Ali-Helmi/modular_robotics/Object Dection and Gripper Arm/Object Detection/Source code/test/images/WIN_20230304_14_51_10_Pro_jpg.rf.c719f185c8aedad8c6cd8eb817fdbf0e.jpg

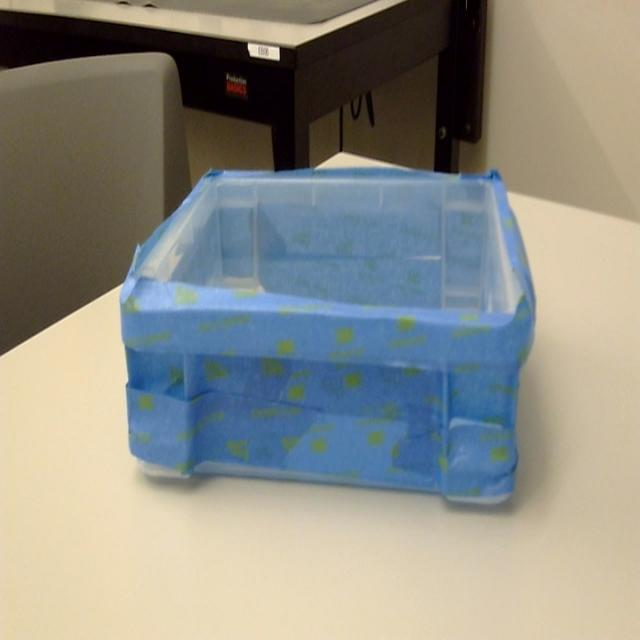
Object Dection and Gripper Arm/Object Detection/Source code/test/images/WIN_20230304_14_51_10_Pro_jpg.rf.c719f185c8aedad8c6cd8eb817fdbf0e.jpg
