Ali-Helmi/modular_robotics/Object Dection and Gripper Arm/Object Detection/Source code/test/images/WIN_20230304_14_51_47_Pro_jpg.rf.07478893552f3b3fd59447c2d8dccacb.jpg

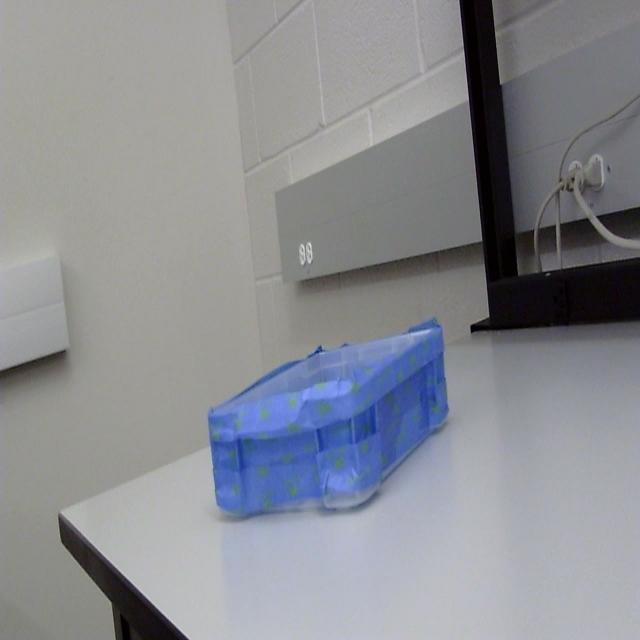
Object Dection and Gripper Arm/Object Detection/Source code/test/images/WIN_20230304_14_51_47_Pro_jpg.rf.07478893552f3b3fd59447c2d8dccacb.jpg
