Ali-Helmi/modular_robotics/README.md

# Modular Robotics (Molucubes)
A repository which holds all the files for the subsystems that make up our senior design project.
