Ali-Helmi/modular_robotics/Housing and PCBs/PCBs/info.txt

final_PCBs_404 is the location for the final designs for the arm, sensor, and connector PCBs
used for the robot in ECEN 404

The others are the old designs
