Ali-Helmi/modular_robotics/Object Dection and Gripper Arm/Gripper Arm/2-15-2023/newArm/screenshots/hollistic_sketch_layout.png

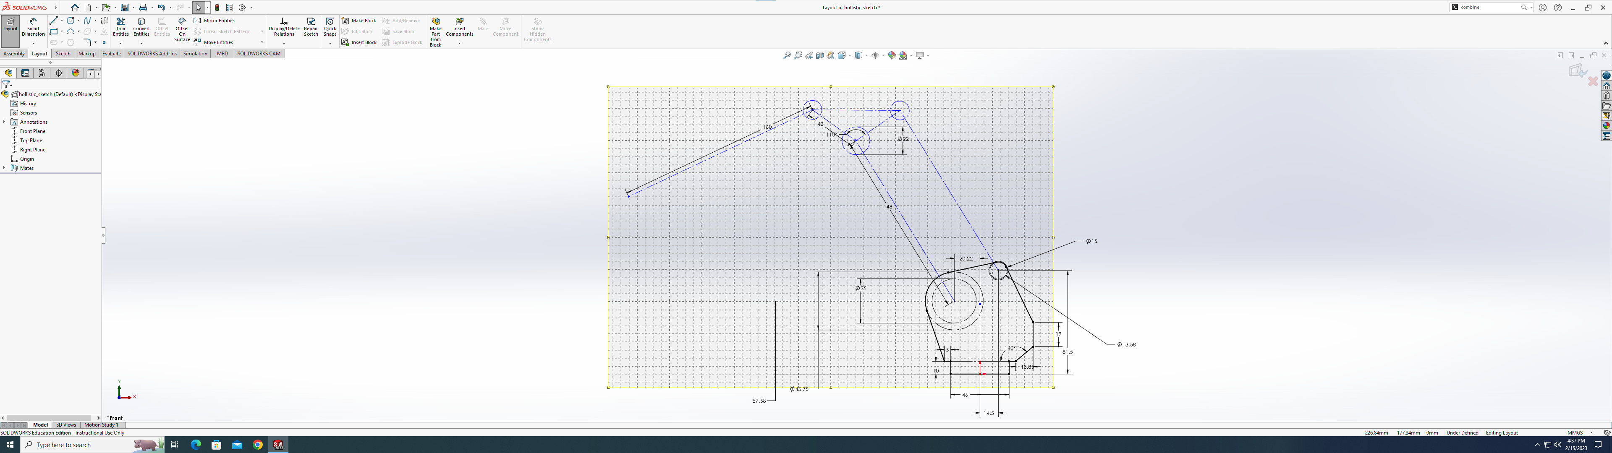
Object Dection and Gripper Arm/Gripper Arm/2-15-2023/newArm/screenshots/hollistic_sketch_layout.png
