Ali-Helmi/modular_robotics/Object Dection and Gripper Arm/Gripper Arm/2-15-2023/newArm/screenshots/modular_base_3d.png

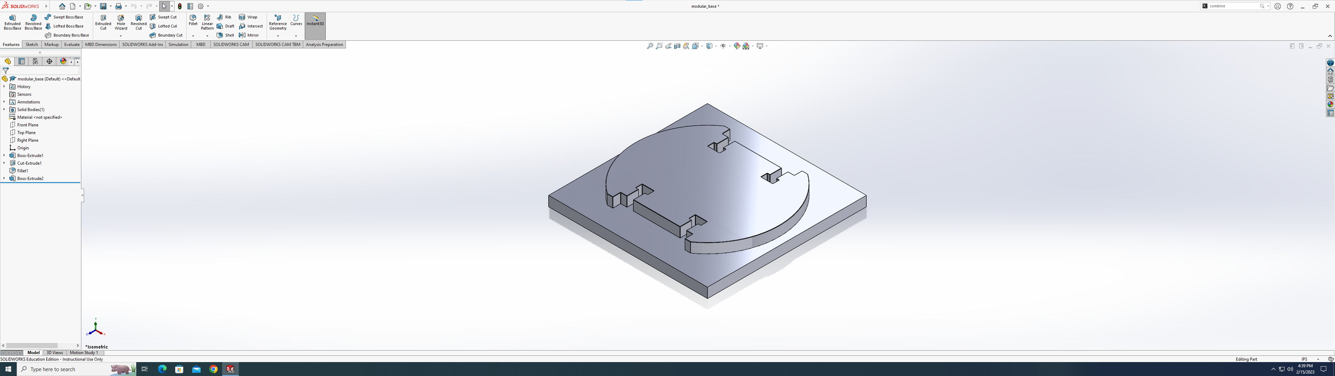
Object Dection and Gripper Arm/Gripper Arm/2-15-2023/newArm/screenshots/modular_base_3d.png
