Ali-Helmi/modular_robotics/Object Dection and Gripper Arm/Gripper Arm/3-20-2023/PXL_20230322_123354596.jpg

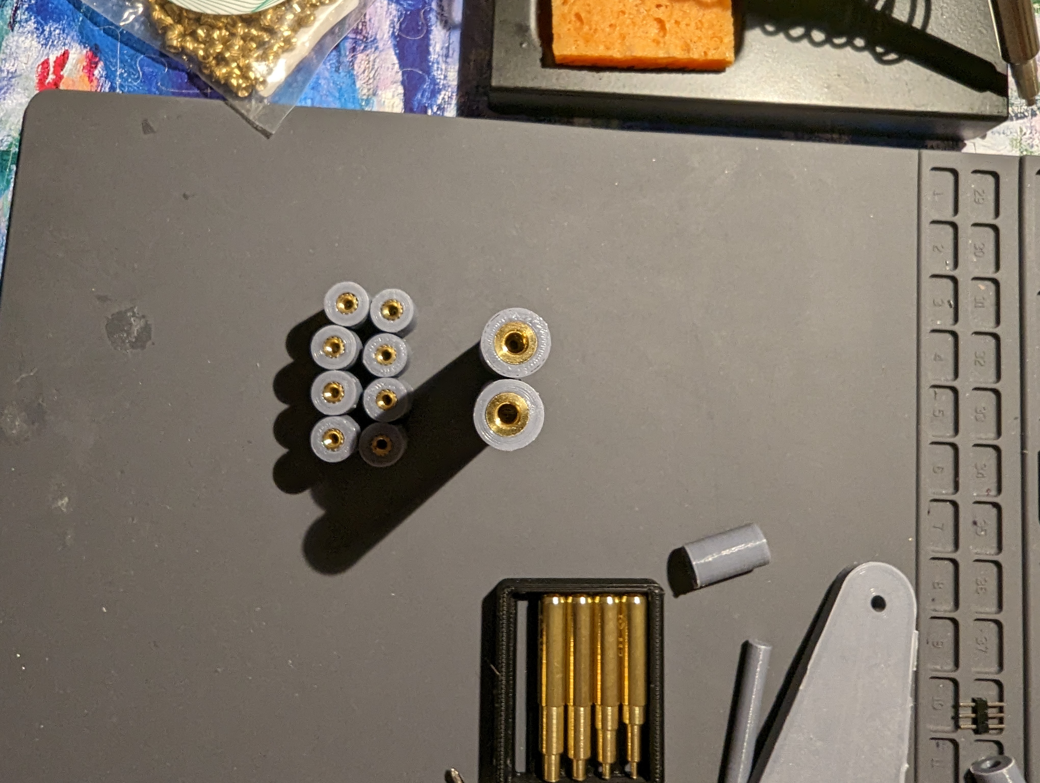
Object Dection and Gripper Arm/Gripper Arm/3-20-2023/PXL_20230322_123354596.jpg
