Ali-Helmi/modular_robotics/Object Dection and Gripper Arm/Gripper Arm/Demonstrations/gripper_arm_extended.jpg

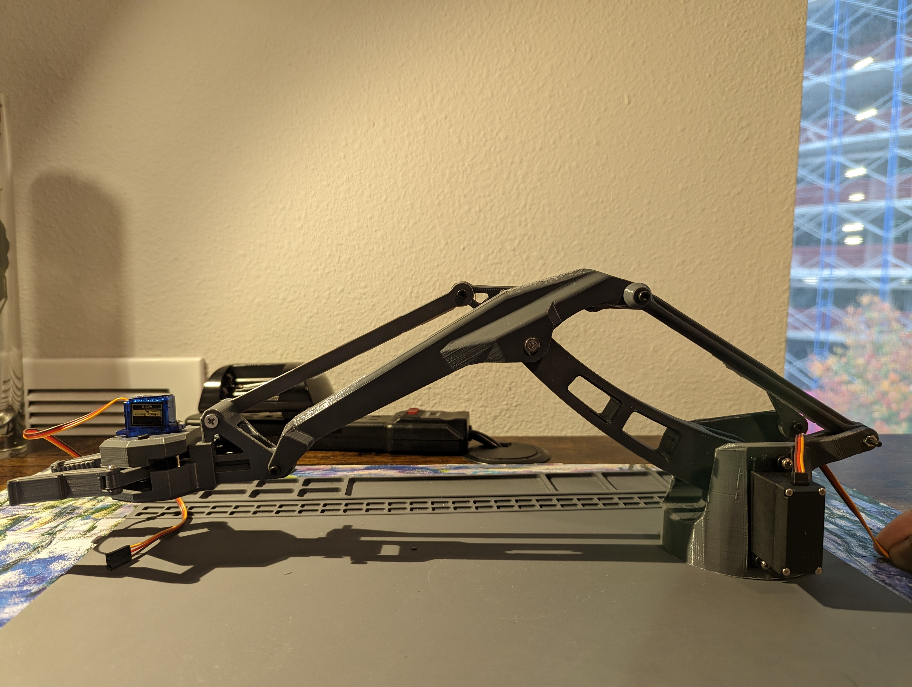
Object Dection and Gripper Arm/Gripper Arm/Demonstrations/gripper_arm_extended.jpg
