Ali-Helmi/modular_robotics/Object Dection and Gripper Arm/Gripper Arm/Demonstrations/gripper_arm_normal.jpg

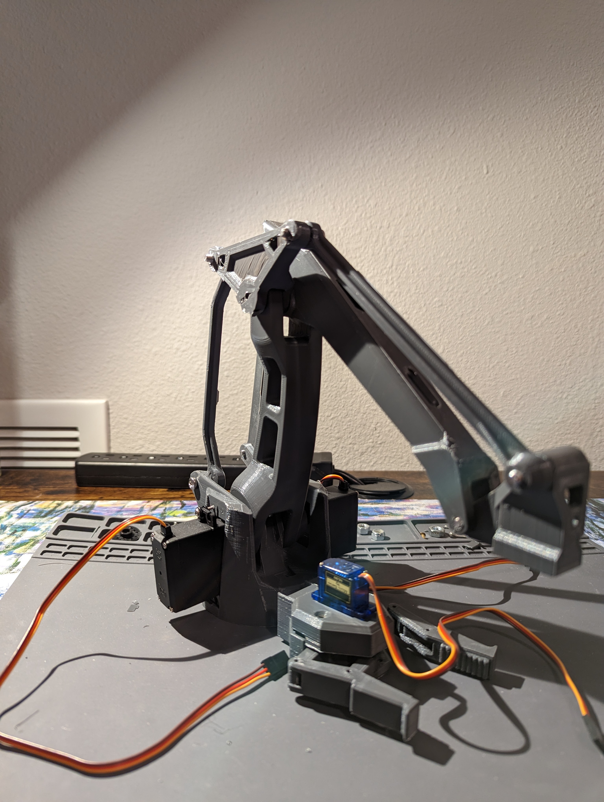
Object Dection and Gripper Arm/Gripper Arm/Demonstrations/gripper_arm_normal.jpg
