Ali-Helmi/modular_robotics/Object Dection and Gripper Arm/Gripper Arm/Demonstrations/PXL_20230322_113851654.jpg

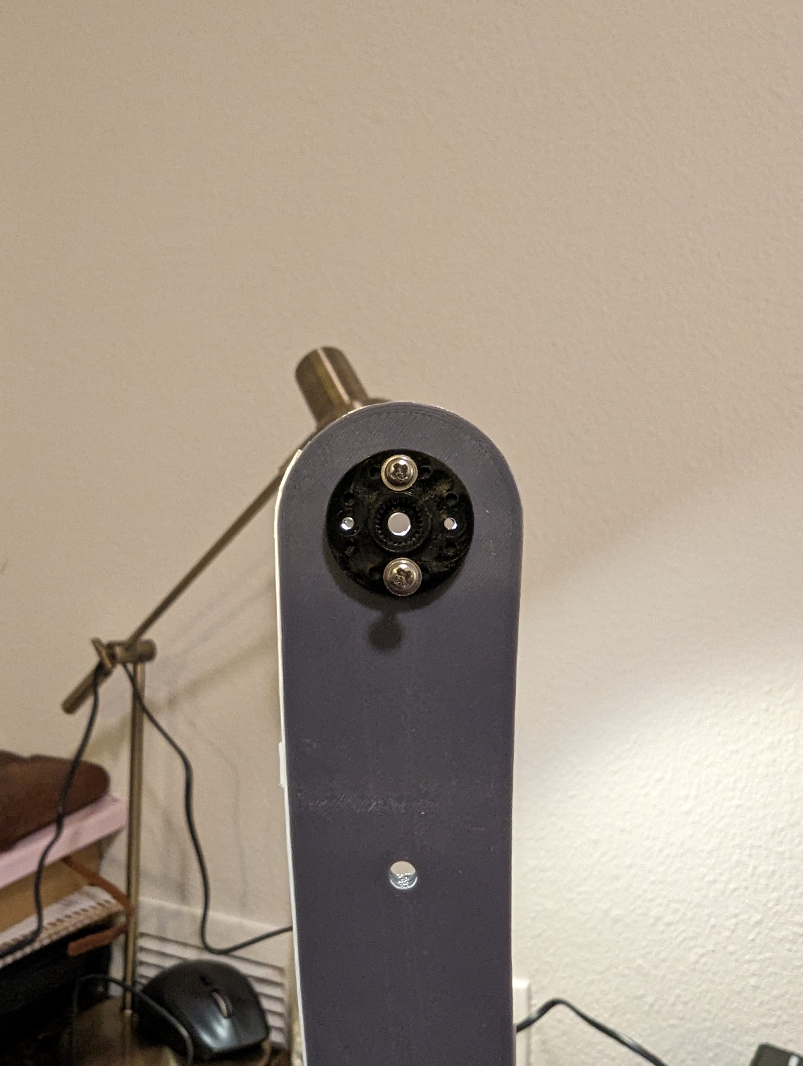
Object Dection and Gripper Arm/Gripper Arm/Demonstrations/PXL_20230322_113851654.jpg
