Ali-Helmi/modular_robotics/Object Dection and Gripper Arm/Gripper Arm/Demonstrations/PXL_20230405_151951665.jpg

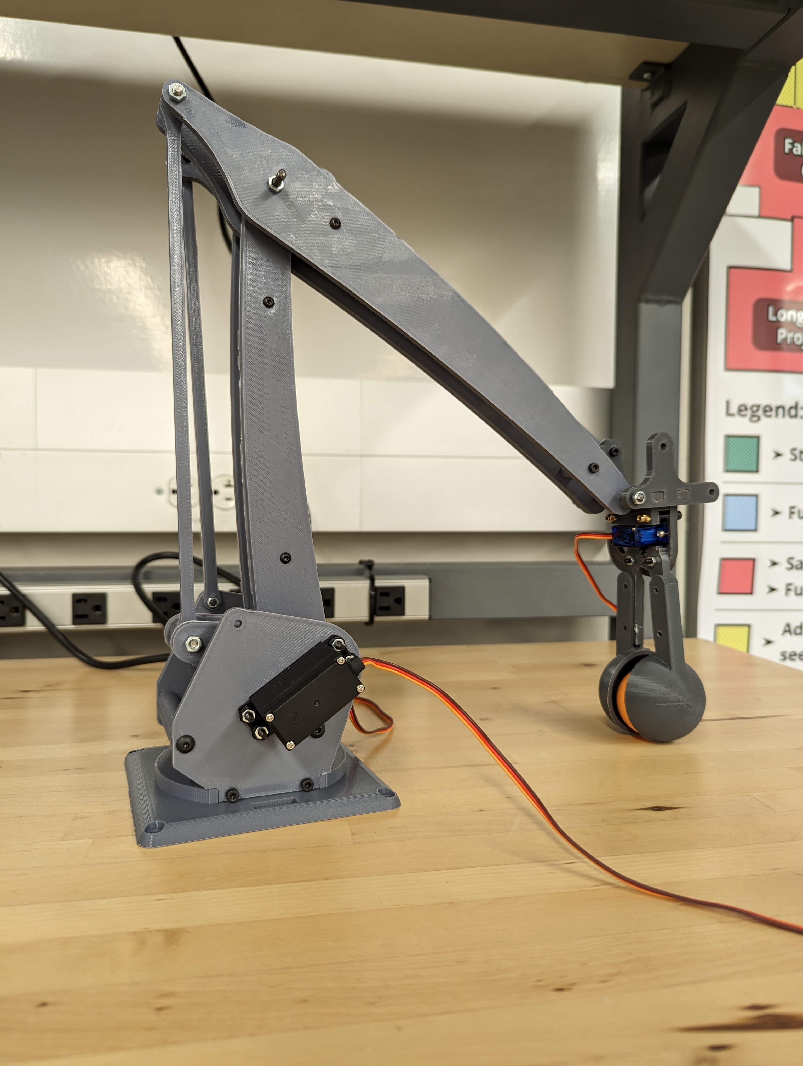
Object Dection and Gripper Arm/Gripper Arm/Demonstrations/PXL_20230405_151951665.jpg
