Ali-Helmi/modular_robotics/Object Dection and Gripper Arm/Gripper Arm/Demonstrations/PXL_20230406_000420174.jpg

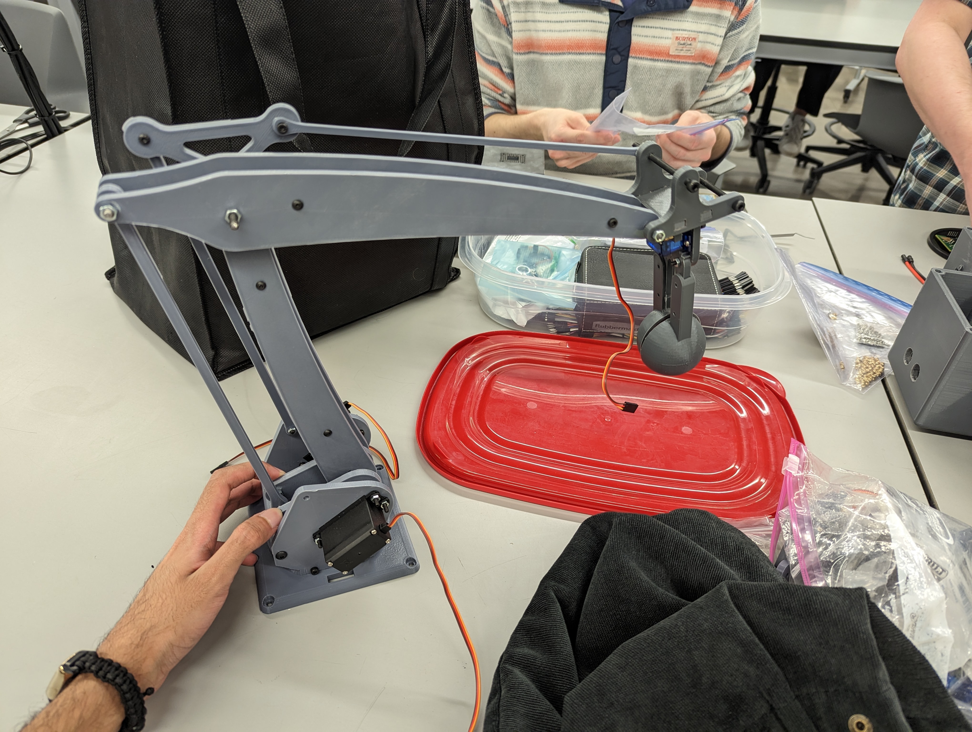
Object Dection and Gripper Arm/Gripper Arm/Demonstrations/PXL_20230406_000420174.jpg
