Ali-Helmi/modular_robotics/Object Dection and Gripper Arm/Gripper Arm/Demonstrations/PXL_20230406_001806251.jpg

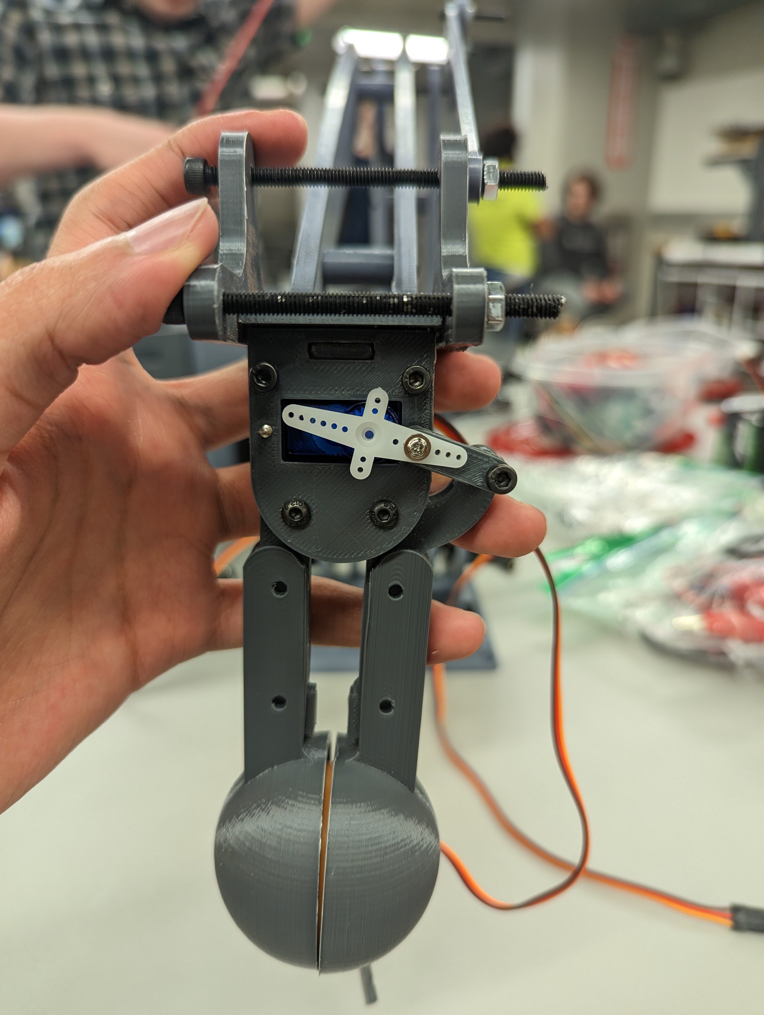
Object Dection and Gripper Arm/Gripper Arm/Demonstrations/PXL_20230406_001806251.jpg
