Ali-Helmi/modular_robotics/Object Dection and Gripper Arm/Gripper Arm/Designs/design1.png

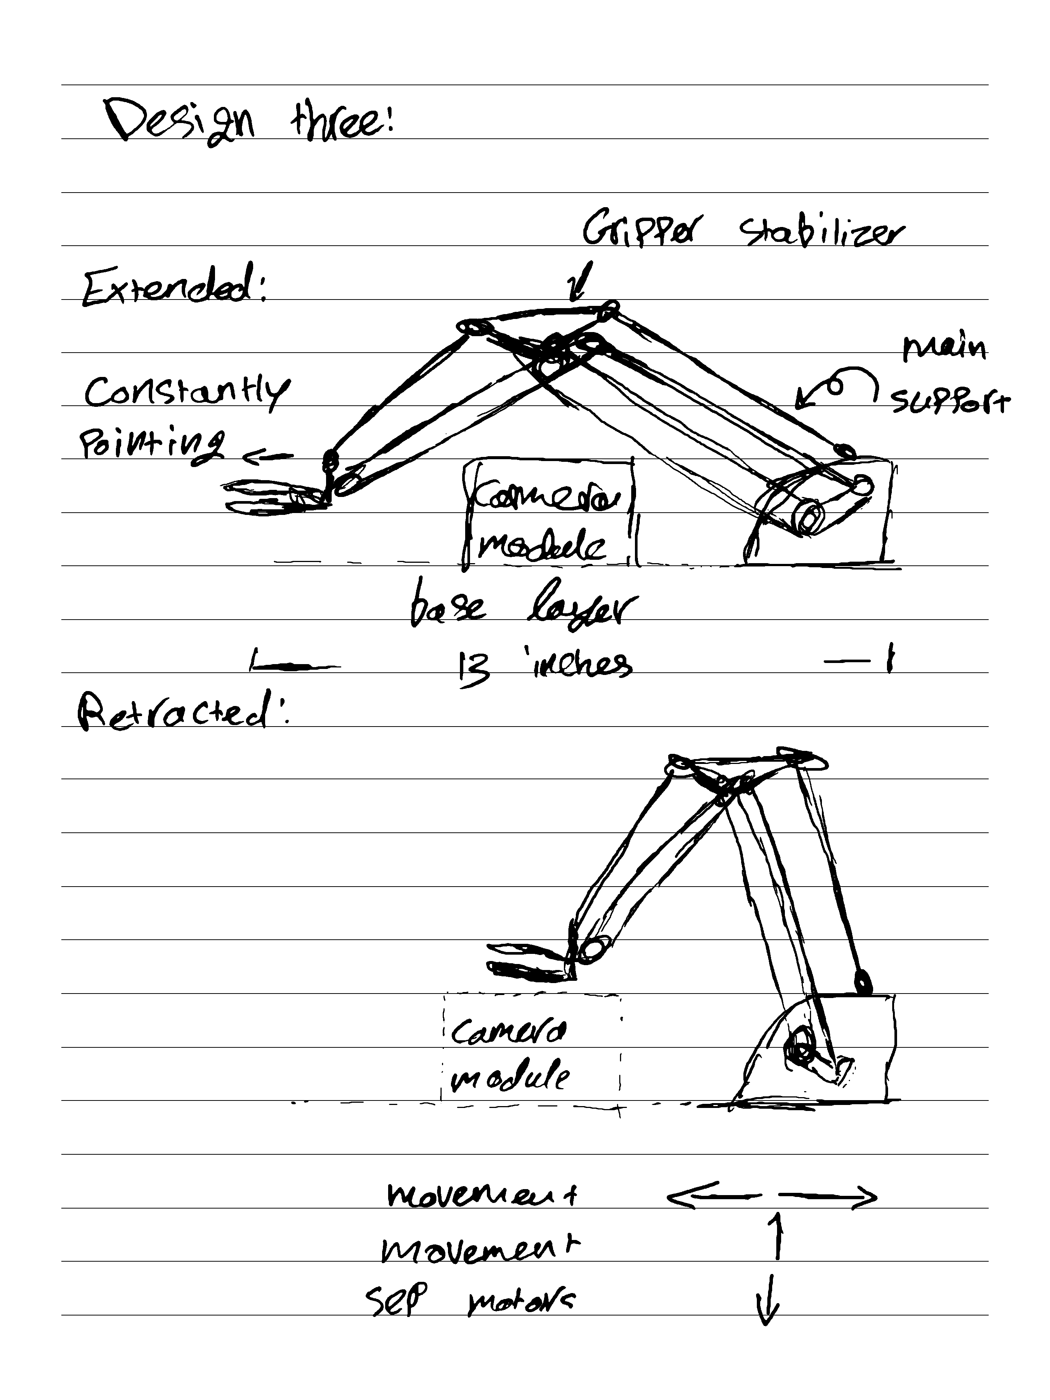
Object Dection and Gripper Arm/Gripper Arm/Designs/design1.png
