Ali-Helmi/modular_robotics/Object Dection and Gripper Arm/Gripper Arm/Designs/design2.png

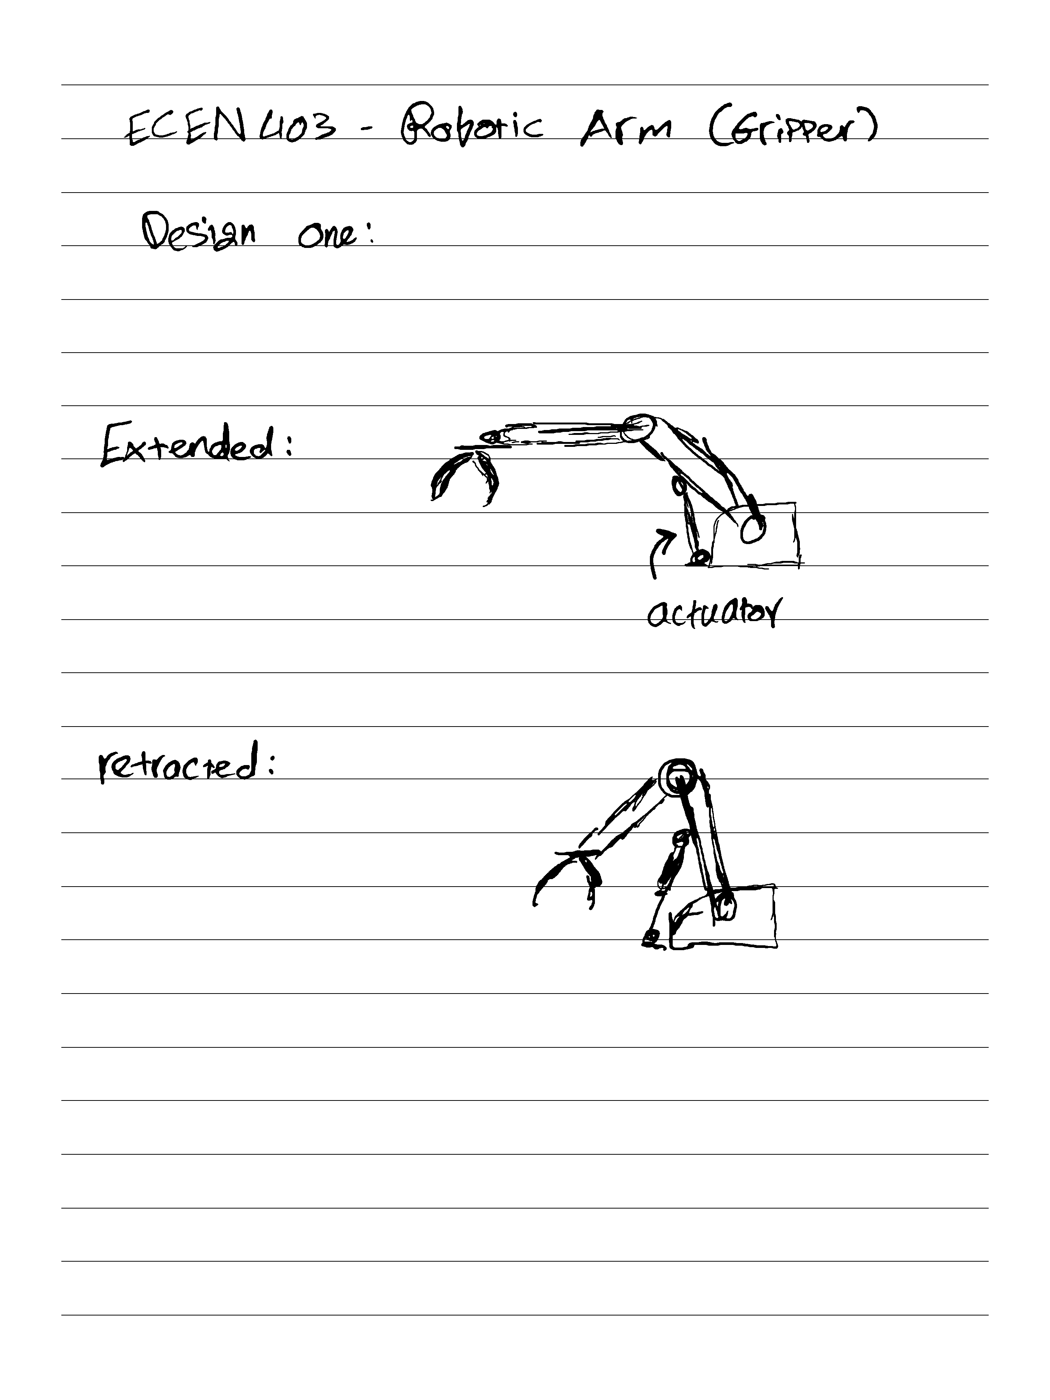
Object Dection and Gripper Arm/Gripper Arm/Designs/design2.png
