Ali-Helmi/modular_robotics/Object Dection and Gripper Arm/Gripper Arm/Designs/design3.png

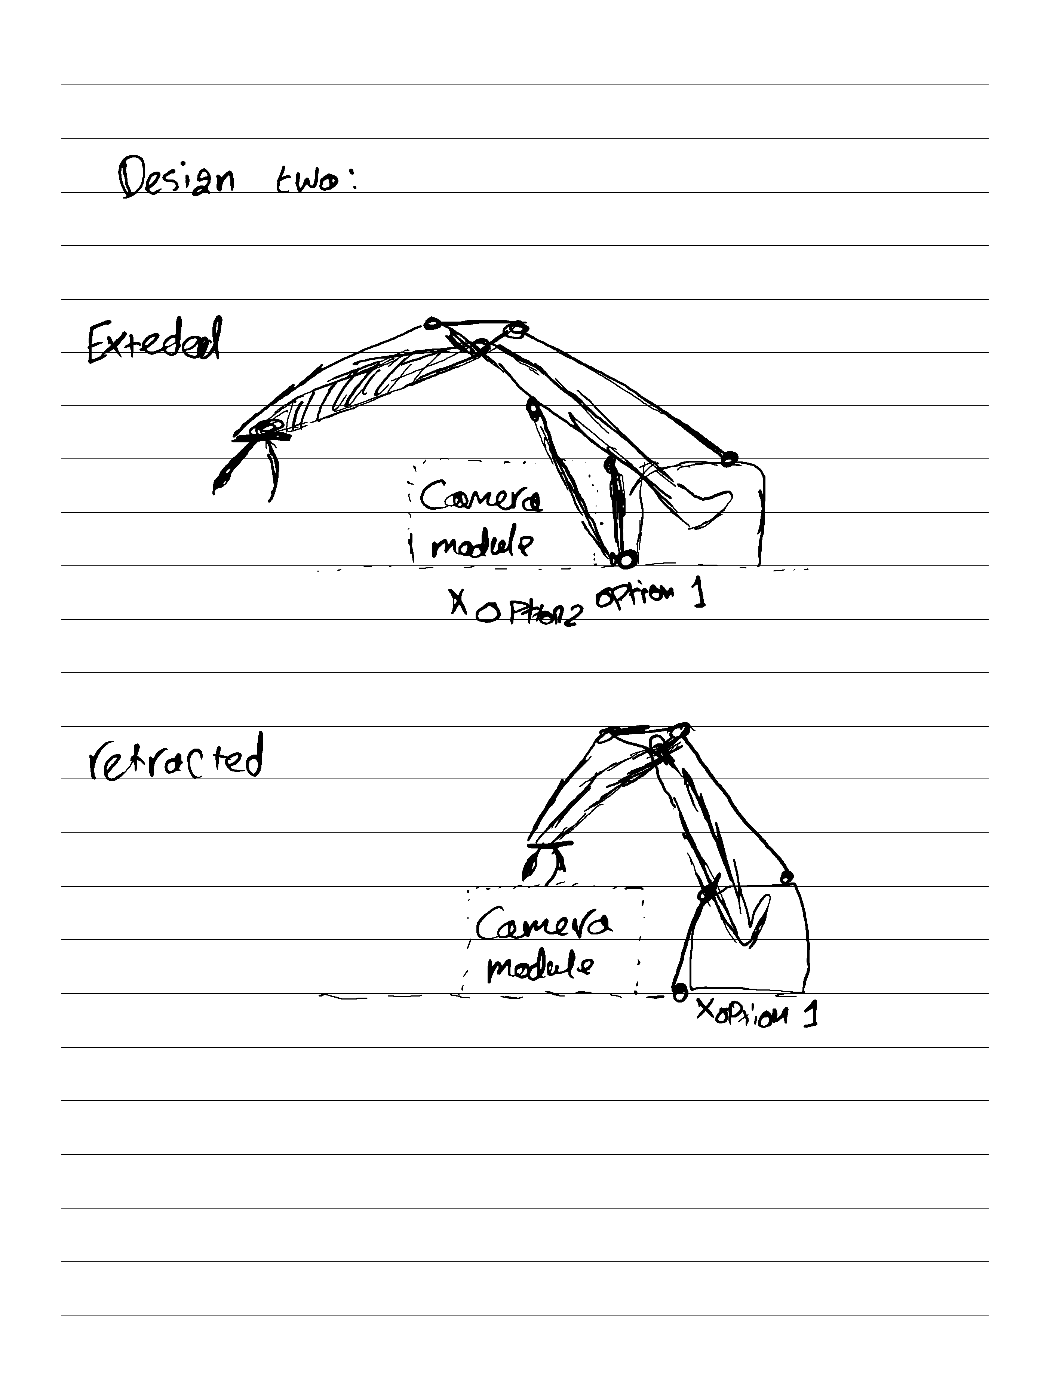
Object Dection and Gripper Arm/Gripper Arm/Designs/design3.png
