Ali-Helmi/modular_robotics/Object Dection and Gripper Arm/Object Detection/Demonstration/confusion_matrix.png

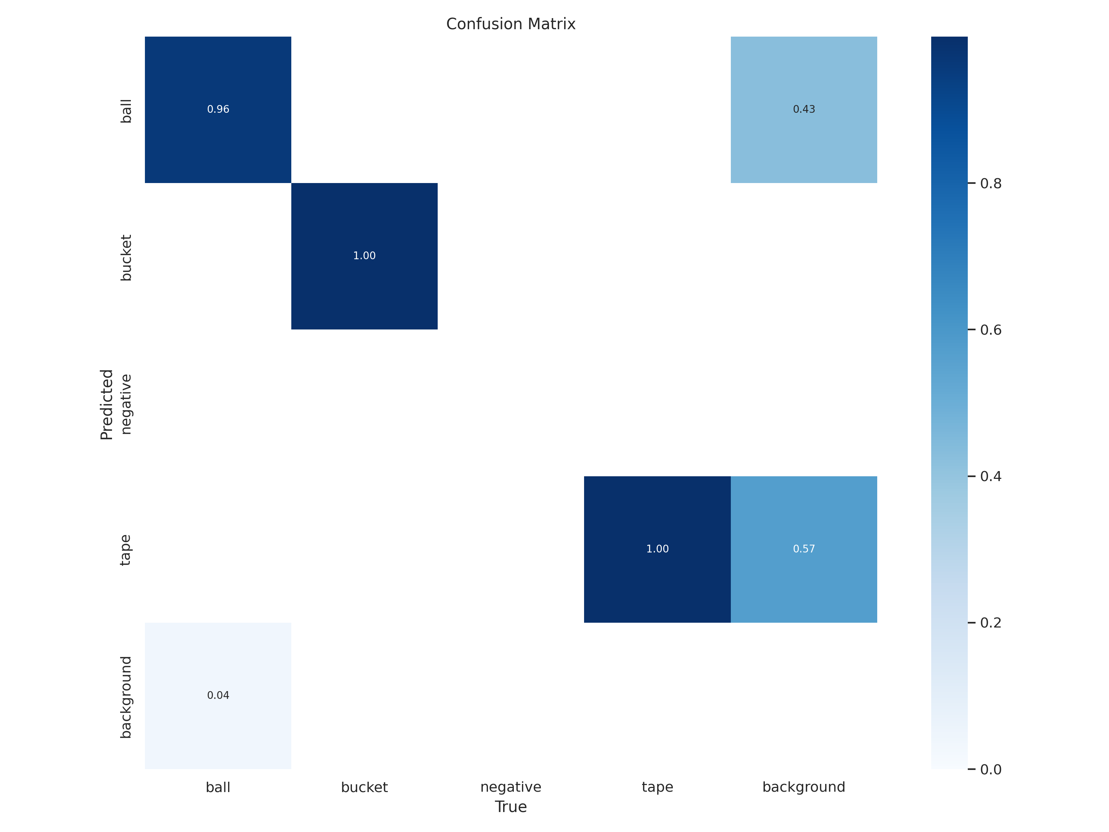
Object Dection and Gripper Arm/Object Detection/Demonstration/confusion_matrix.png
