Ali-Helmi/modular_robotics/Object Dection and Gripper Arm/Object Detection/Demonstration/example.jpeg

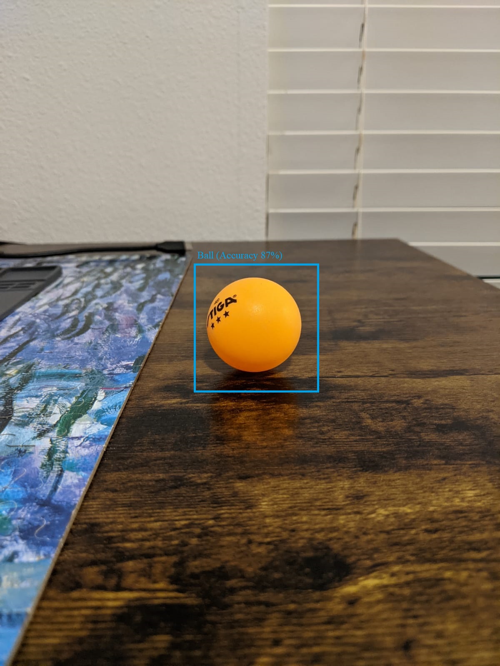
Object Dection and Gripper Arm/Object Detection/Demonstration/example.jpeg
