Ali-Helmi/modular_robotics/Object Dection and Gripper Arm/Object Detection/Demonstration/F1_curve.png

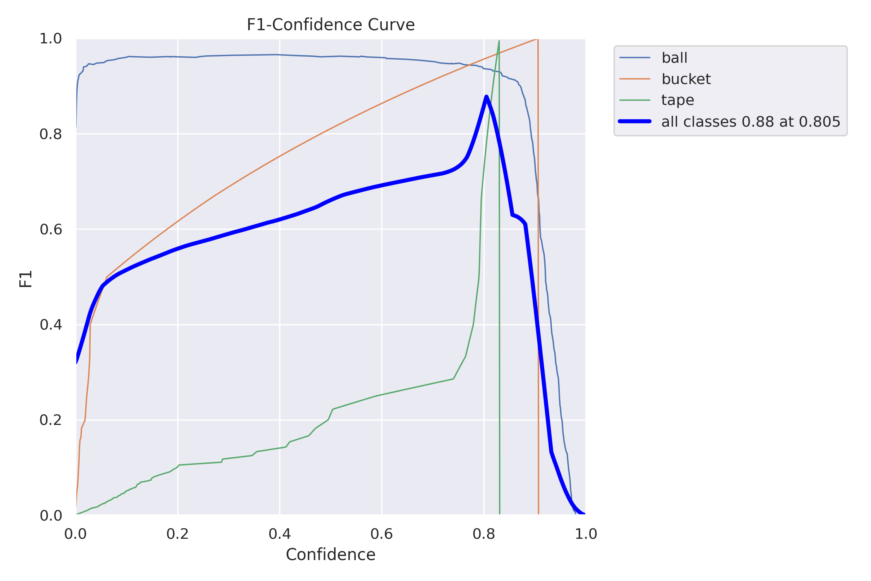
Object Dection and Gripper Arm/Object Detection/Demonstration/F1_curve.png
