Ali-Helmi/modular_robotics/Object Dection and Gripper Arm/Object Detection/Demonstration/PR_curve.png

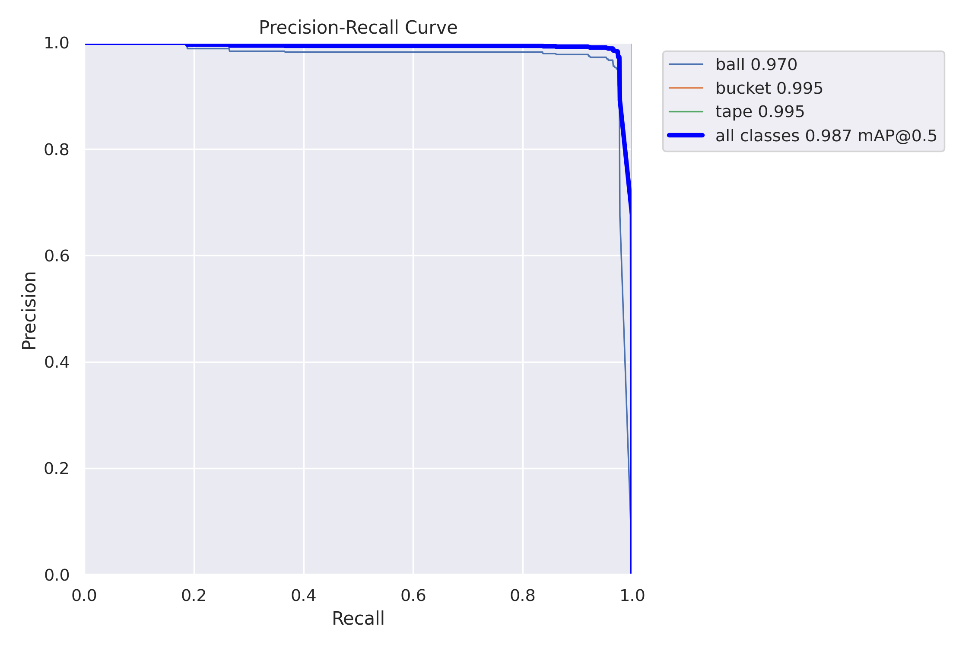
Object Dection and Gripper Arm/Object Detection/Demonstration/PR_curve.png
