Ali-Helmi/modular_robotics/Object Dection and Gripper Arm/Object Detection/Demonstration/Screenshot 2023-02-15 011303.png

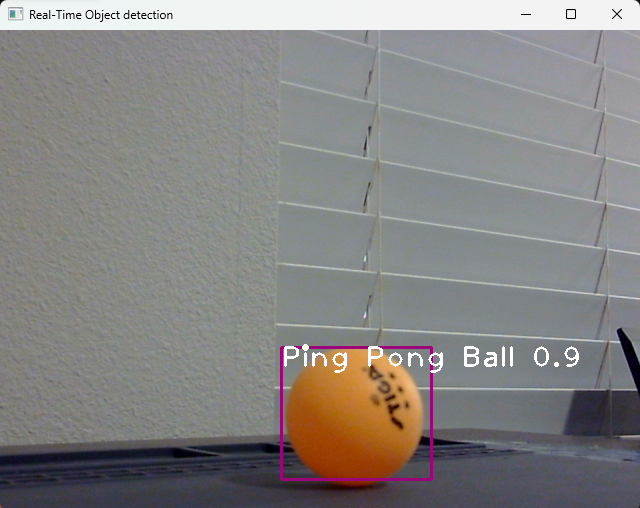
Object Dection and Gripper Arm/Object Detection/Demonstration/Screenshot 2023-02-15 011303.png
