Ali-Helmi/modular_robotics/Object Dection and Gripper Arm/Object Detection/Demonstration/Screenshot 2023-03-20 095929.png

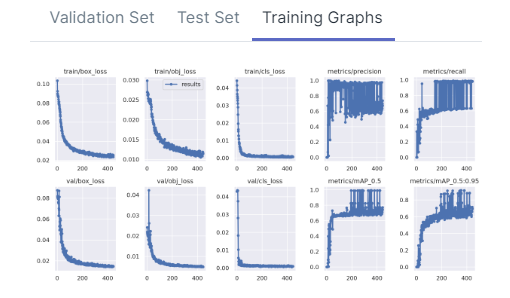
Object Dection and Gripper Arm/Object Detection/Demonstration/Screenshot 2023-03-20 095929.png
