Ali-Helmi/modular_robotics/Object Dection and Gripper Arm/Object Detection/Demonstration/train_batch1.jpg

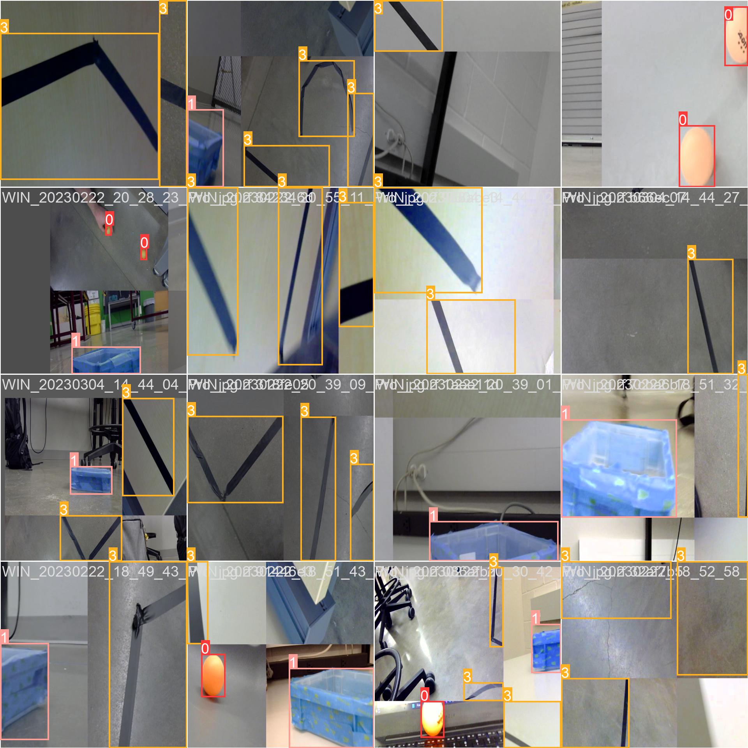
Object Dection and Gripper Arm/Object Detection/Demonstration/train_batch1.jpg
