Ali-Helmi/modular_robotics/Object Dection and Gripper Arm/Object Detection/Demonstration/val_batch0_labels.jpg

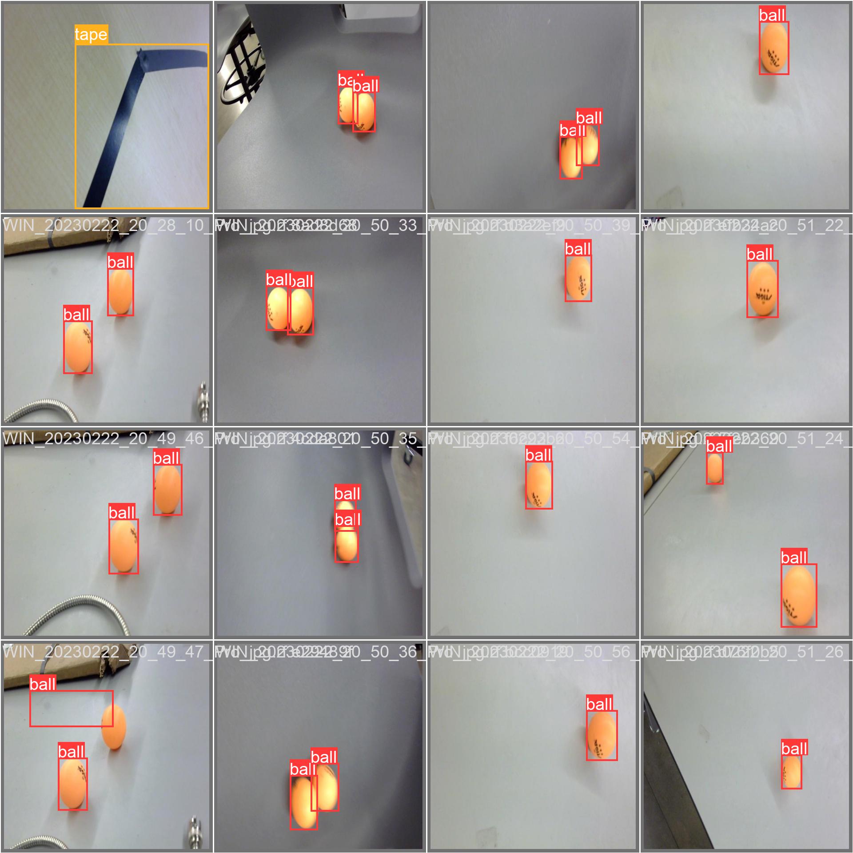
Object Dection and Gripper Arm/Object Detection/Demonstration/val_batch0_labels.jpg
