Ali-Helmi/modular_robotics/Object Dection and Gripper Arm/Object Detection/Demonstration/val_batch1_labels.jpg

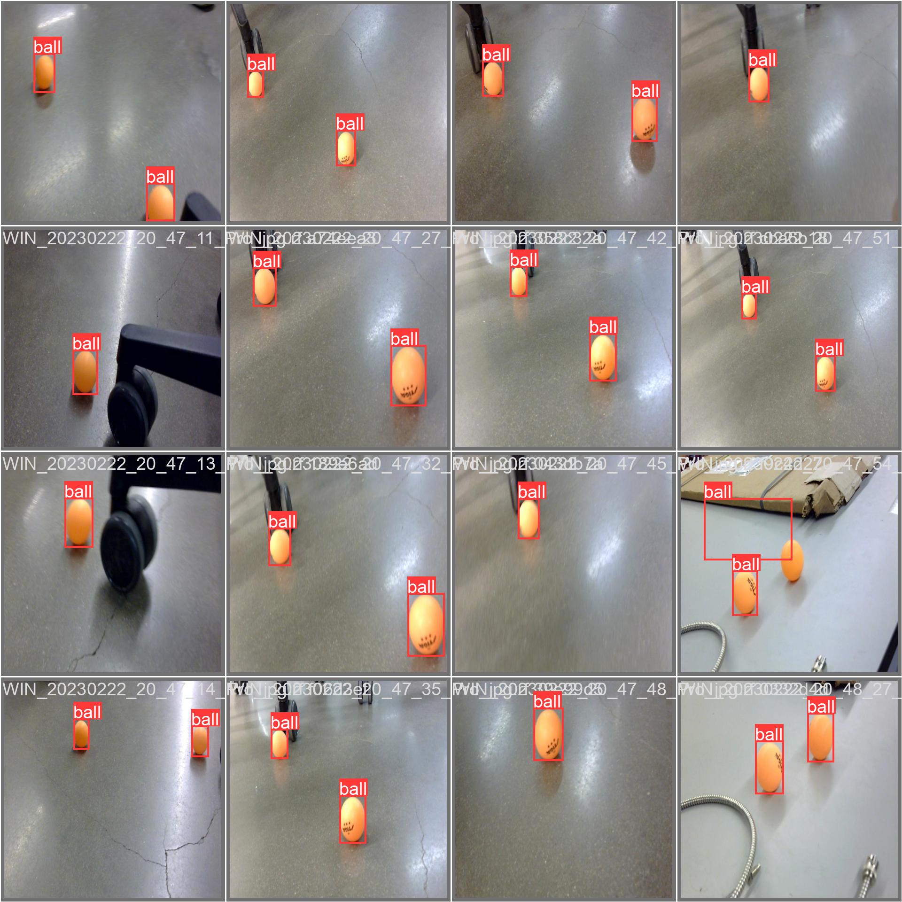
Object Dection and Gripper Arm/Object Detection/Demonstration/val_batch1_labels.jpg
