Ali-Helmi/modular_robotics/Object Dection and Gripper Arm/Object Detection/Source code/runs/detect/predict/WIN_20230222_20_41_58_Pro_jpg.rf.e61d919e48a1193bfad353eb70a3a4d8.jpg

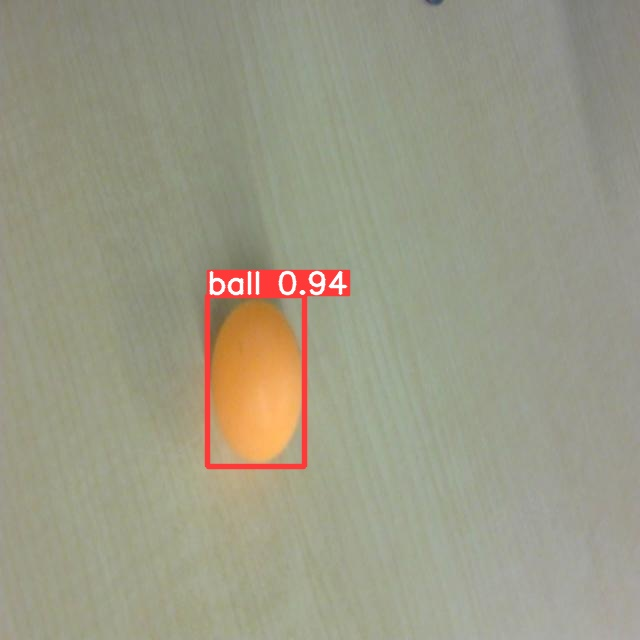
Object Dection and Gripper Arm/Object Detection/Source code/runs/detect/predict/WIN_20230222_20_41_58_Pro_jpg.rf.e61d919e48a1193bfad353eb70a3a4d8.jpg
