Ali-Helmi/modular_robotics/Object Dection and Gripper Arm/Object Detection/Source code/runs/detect/predict/WIN_20230222_20_41_59_Pro_jpg.rf.57af9cab96229cc4d8199def921395b4.jpg

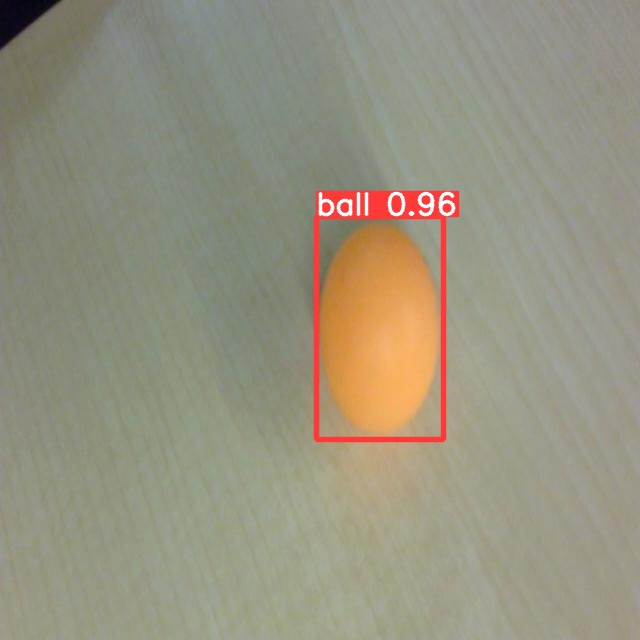
Object Dection and Gripper Arm/Object Detection/Source code/runs/detect/predict/WIN_20230222_20_41_59_Pro_jpg.rf.57af9cab96229cc4d8199def921395b4.jpg
