Ali-Helmi/modular_robotics/Object Dection and Gripper Arm/Object Detection/Source code/runs/detect/predict/WIN_20230222_20_42_05_Pro_jpg.rf.62c3d07dbcf5bc8ec9b22e7d9fde196d.jpg

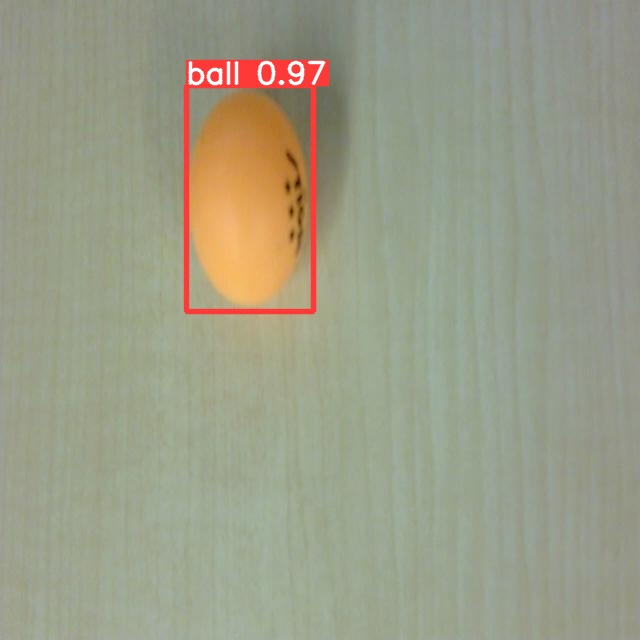
Object Dection and Gripper Arm/Object Detection/Source code/runs/detect/predict/WIN_20230222_20_42_05_Pro_jpg.rf.62c3d07dbcf5bc8ec9b22e7d9fde196d.jpg
