Ali-Helmi/modular_robotics/Object Dection and Gripper Arm/Object Detection/Source code/runs/detect/predict/WIN_20230222_20_42_07_Pro_jpg.rf.55e85c02e4a7fd01ec5aa6d832e29c8c.jpg

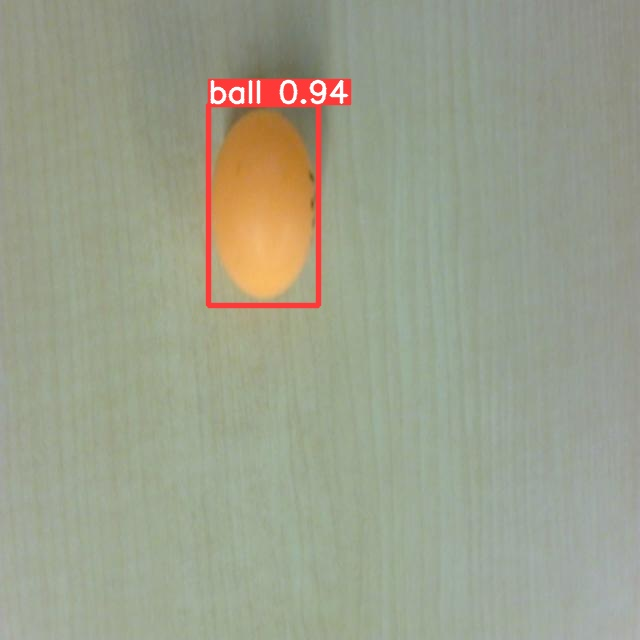
Object Dection and Gripper Arm/Object Detection/Source code/runs/detect/predict/WIN_20230222_20_42_07_Pro_jpg.rf.55e85c02e4a7fd01ec5aa6d832e29c8c.jpg
