Ali-Helmi/modular_robotics/Object Dection and Gripper Arm/Object Detection/Source code/runs/detect/predict/WIN_20230222_20_42_08_Pro_jpg.rf.afa162356394767642ac89f98e0a964a.jpg

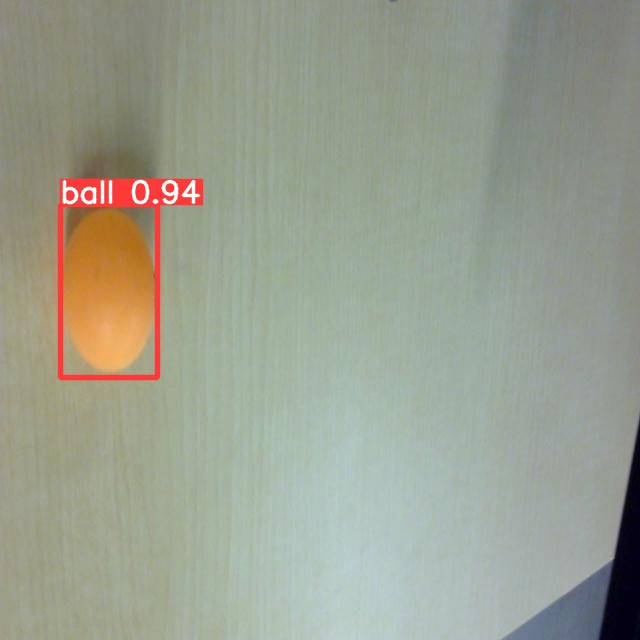
Object Dection and Gripper Arm/Object Detection/Source code/runs/detect/predict/WIN_20230222_20_42_08_Pro_jpg.rf.afa162356394767642ac89f98e0a964a.jpg
