Ali-Helmi/modular_robotics/Object Dection and Gripper Arm/Object Detection/Source code/runs/detect/predict/WIN_20230222_20_42_10_Pro_jpg.rf.1fc8804907ce4d8326613d061204f312.jpg

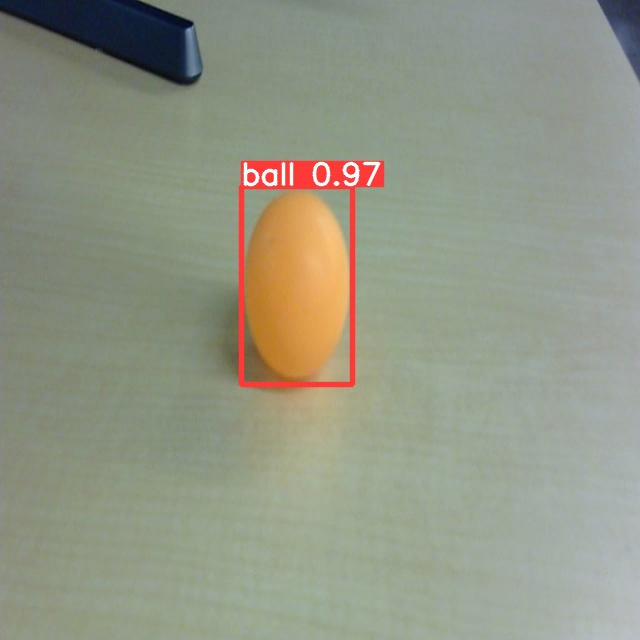
Object Dection and Gripper Arm/Object Detection/Source code/runs/detect/predict/WIN_20230222_20_42_10_Pro_jpg.rf.1fc8804907ce4d8326613d061204f312.jpg
