Ali-Helmi/modular_robotics/Object Dection and Gripper Arm/Object Detection/Source code/runs/detect/predict/WIN_20230222_20_42_14_Pro_jpg.rf.e390a783e06d13daef66cd6103ca5f59.jpg

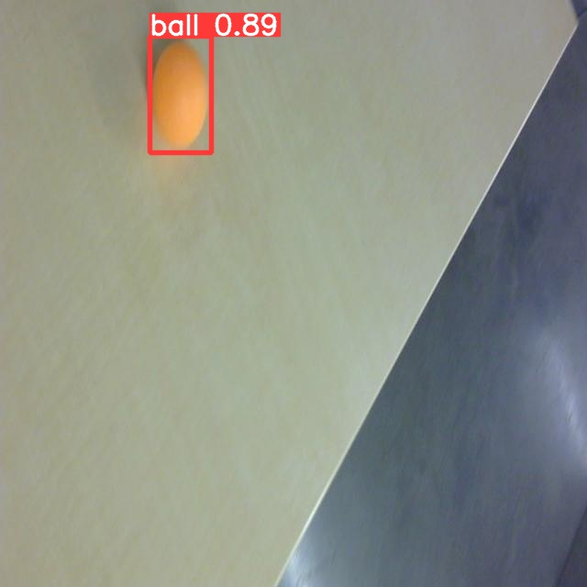
Object Dection and Gripper Arm/Object Detection/Source code/runs/detect/predict/WIN_20230222_20_42_14_Pro_jpg.rf.e390a783e06d13daef66cd6103ca5f59.jpg
