Ali-Helmi/modular_robotics/Object Dection and Gripper Arm/Object Detection/Source code/runs/detect/predict/WIN_20230222_20_42_17_Pro_jpg.rf.e4c94163a046c77c65f2ad23986a45a2.jpg

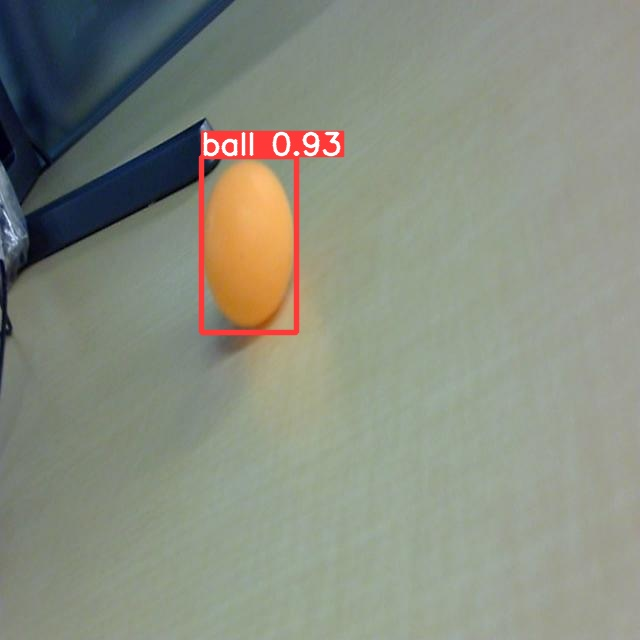
Object Dection and Gripper Arm/Object Detection/Source code/runs/detect/predict/WIN_20230222_20_42_17_Pro_jpg.rf.e4c94163a046c77c65f2ad23986a45a2.jpg
