Ali-Helmi/modular_robotics/Object Dection and Gripper Arm/Object Detection/Source code/runs/detect/predict/WIN_20230222_20_42_22_Pro_jpg.rf.ad3f222d145c41b0b2daa8378d9c63dd.jpg

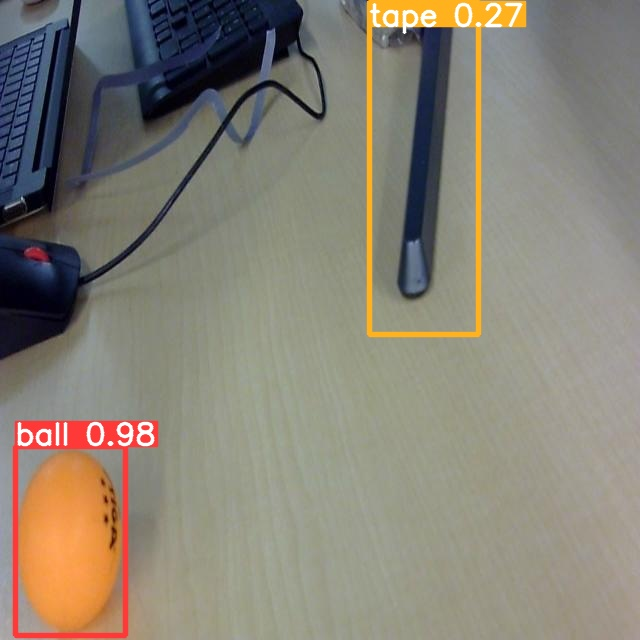
Object Dection and Gripper Arm/Object Detection/Source code/runs/detect/predict/WIN_20230222_20_42_22_Pro_jpg.rf.ad3f222d145c41b0b2daa8378d9c63dd.jpg
