Ali-Helmi/modular_robotics/Object Dection and Gripper Arm/Object Detection/Source code/runs/detect/predict/WIN_20230222_20_42_23_Pro-2-_jpg.rf.ef897bb1f743953ebfe49b2d5eb873fb.jpg

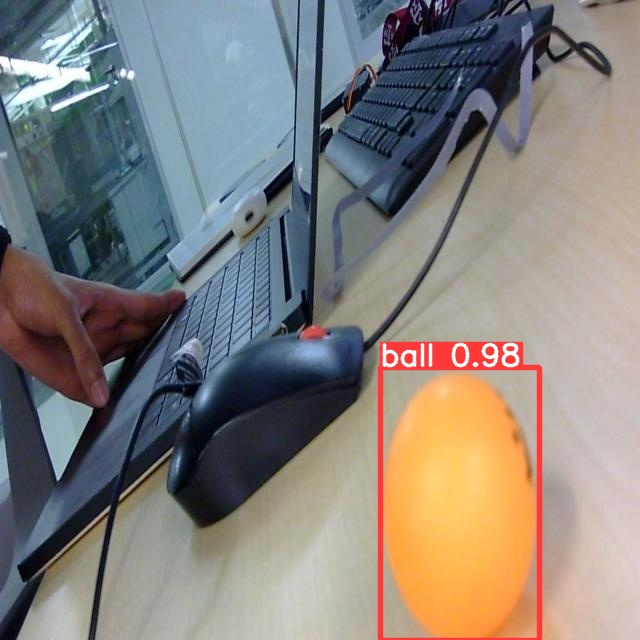
Object Dection and Gripper Arm/Object Detection/Source code/runs/detect/predict/WIN_20230222_20_42_23_Pro-2-_jpg.rf.ef897bb1f743953ebfe49b2d5eb873fb.jpg
