Ali-Helmi/modular_robotics/Object Dection and Gripper Arm/Object Detection/Source code/runs/detect/predict/WIN_20230222_20_42_23_Pro_jpg.rf.421d33f15f3513c79c6f9f95c828416c.jpg

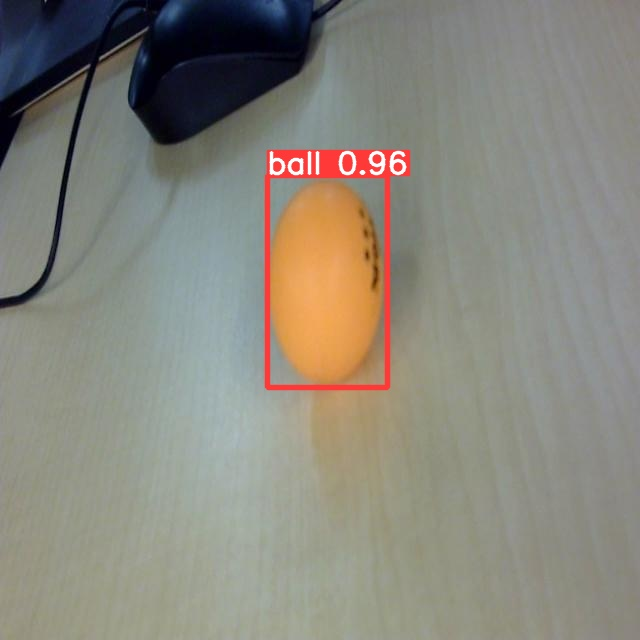
Object Dection and Gripper Arm/Object Detection/Source code/runs/detect/predict/WIN_20230222_20_42_23_Pro_jpg.rf.421d33f15f3513c79c6f9f95c828416c.jpg
