Ali-Helmi/modular_robotics/Object Dection and Gripper Arm/Object Detection/Source code/runs/detect/predict/WIN_20230222_20_42_24_Pro_jpg.rf.1850f637ae83d1093a1e5ebb9f2cc64a.jpg

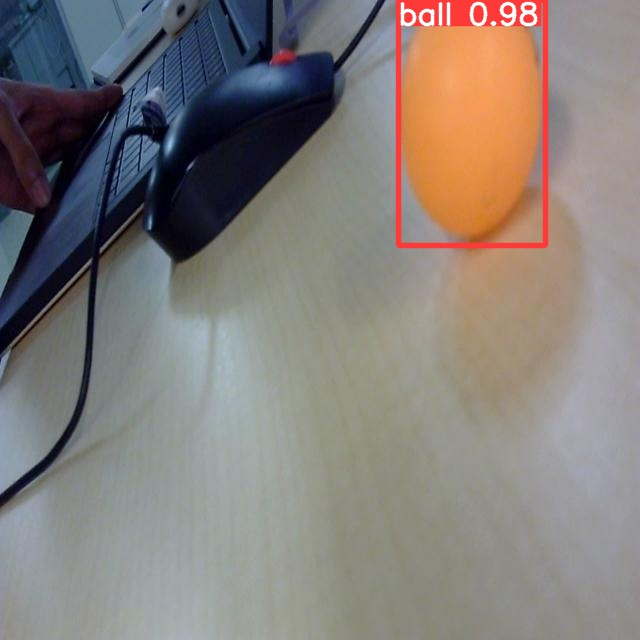
Object Dection and Gripper Arm/Object Detection/Source code/runs/detect/predict/WIN_20230222_20_42_24_Pro_jpg.rf.1850f637ae83d1093a1e5ebb9f2cc64a.jpg
