Ali-Helmi/modular_robotics/Object Dection and Gripper Arm/Object Detection/Source code/runs/detect/predict/WIN_20230222_20_42_37_Pro_jpg.rf.7443cb3c177e2c0b7fa5cba786193930.jpg

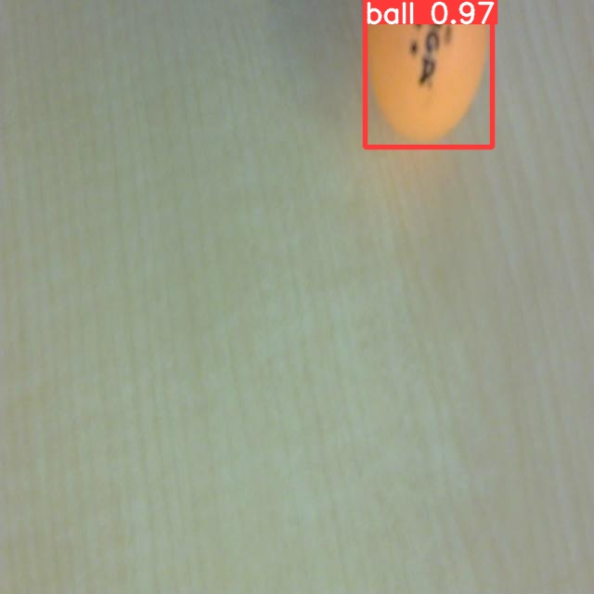
Object Dection and Gripper Arm/Object Detection/Source code/runs/detect/predict/WIN_20230222_20_42_37_Pro_jpg.rf.7443cb3c177e2c0b7fa5cba786193930.jpg
