Ali-Helmi/modular_robotics/Object Dection and Gripper Arm/Object Detection/Source code/runs/detect/predict/WIN_20230222_20_42_51_Pro_jpg.rf.cf0f2888a317015a88816559bff2b334.jpg

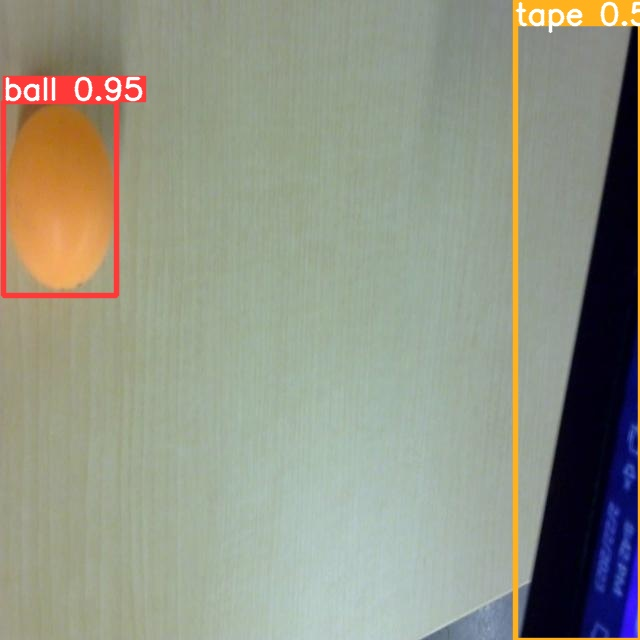
Object Dection and Gripper Arm/Object Detection/Source code/runs/detect/predict/WIN_20230222_20_42_51_Pro_jpg.rf.cf0f2888a317015a88816559bff2b334.jpg
