Ali-Helmi/modular_robotics/Object Dection and Gripper Arm/Object Detection/Source code/runs/detect/predict/WIN_20230222_20_43_01_Pro_jpg.rf.1466e566113093e976327f3e50e0bfa6.jpg

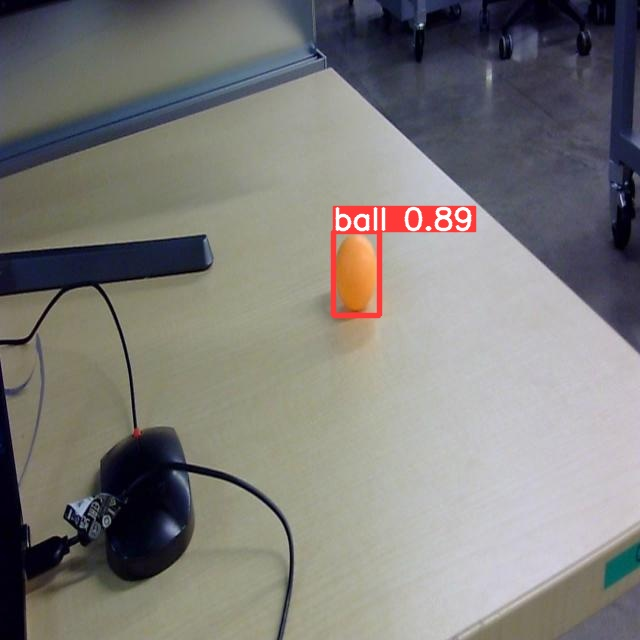
Object Dection and Gripper Arm/Object Detection/Source code/runs/detect/predict/WIN_20230222_20_43_01_Pro_jpg.rf.1466e566113093e976327f3e50e0bfa6.jpg
