Ali-Helmi/modular_robotics/Object Dection and Gripper Arm/Object Detection/Source code/runs/detect/predict/WIN_20230304_14_46_15_Pro_jpg.rf.ad3b58071bb6a038ecffc0758272e7c8.jpg

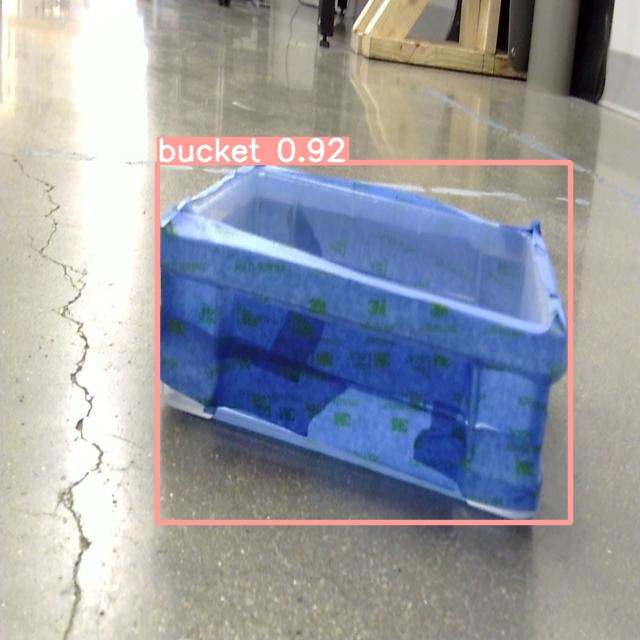
Object Dection and Gripper Arm/Object Detection/Source code/runs/detect/predict/WIN_20230304_14_46_15_Pro_jpg.rf.ad3b58071bb6a038ecffc0758272e7c8.jpg
