Ali-Helmi/modular_robotics/Object Dection and Gripper Arm/Object Detection/Source code/runs/detect/predict/WIN_20230304_14_48_05_Pro_jpg.rf.032ed2ba74aa346afbc14d55ac41eee0.jpg

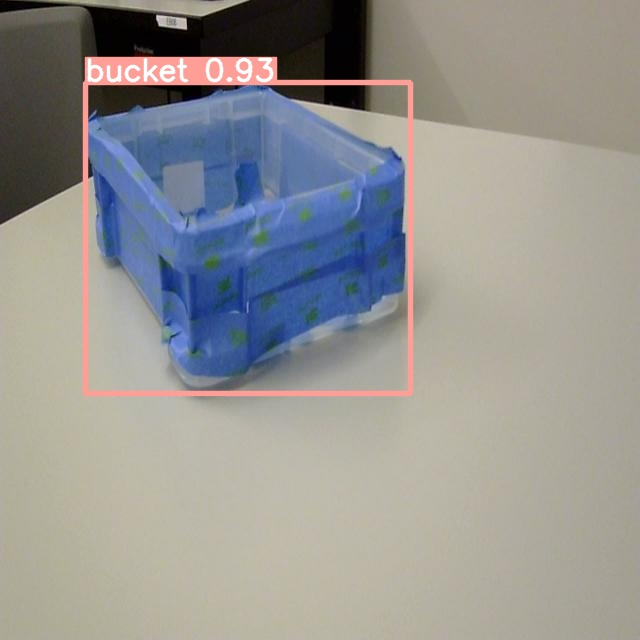
Object Dection and Gripper Arm/Object Detection/Source code/runs/detect/predict/WIN_20230304_14_48_05_Pro_jpg.rf.032ed2ba74aa346afbc14d55ac41eee0.jpg
