Ali-Helmi/modular_robotics/Object Dection and Gripper Arm/Object Detection/Source code/runs/detect/predict/WIN_20230304_14_48_30_Pro_jpg.rf.718f7f3974199c090885a59334cac305.jpg

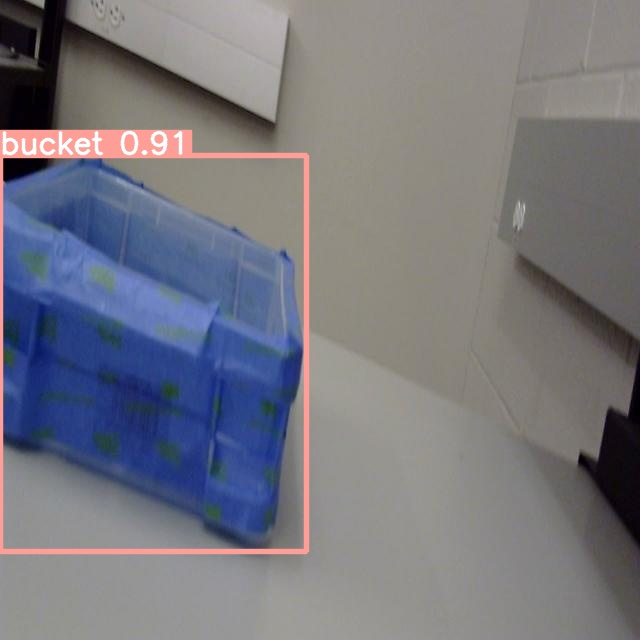
Object Dection and Gripper Arm/Object Detection/Source code/runs/detect/predict/WIN_20230304_14_48_30_Pro_jpg.rf.718f7f3974199c090885a59334cac305.jpg
