Ali-Helmi/modular_robotics/Object Dection and Gripper Arm/Object Detection/Source code/runs/detect/predict/WIN_20230304_14_48_39_Pro_jpg.rf.cf532f7716e0446a99bb854064ceee5d.jpg

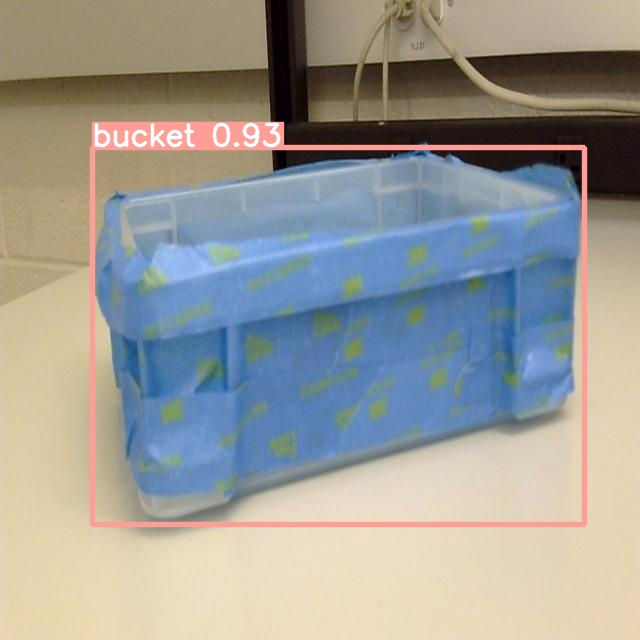
Object Dection and Gripper Arm/Object Detection/Source code/runs/detect/predict/WIN_20230304_14_48_39_Pro_jpg.rf.cf532f7716e0446a99bb854064ceee5d.jpg
