Ali-Helmi/modular_robotics/Object Dection and Gripper Arm/Object Detection/Source code/runs/detect/predict/WIN_20230304_14_48_40_Pro_jpg.rf.a6c73db75bf1a3c4b4ed3e310eabf87a.jpg

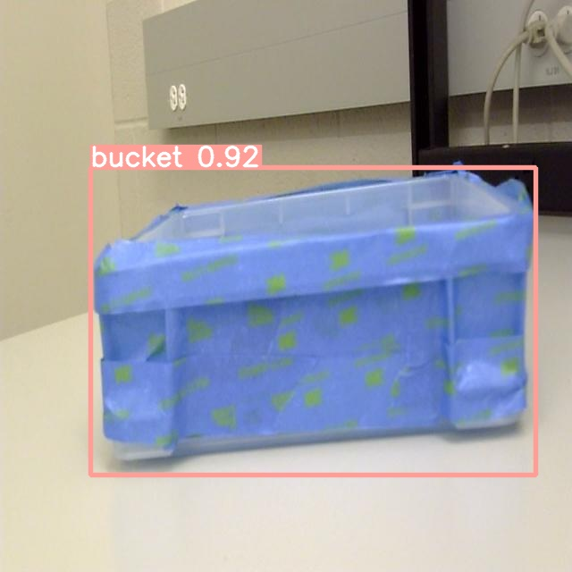
Object Dection and Gripper Arm/Object Detection/Source code/runs/detect/predict/WIN_20230304_14_48_40_Pro_jpg.rf.a6c73db75bf1a3c4b4ed3e310eabf87a.jpg
