Ali-Helmi/modular_robotics/Object Dection and Gripper Arm/Object Detection/Source code/runs/detect/predict/WIN_20230304_14_48_45_Pro_jpg.rf.d2edaa73f7cdd017987211a29db16979.jpg

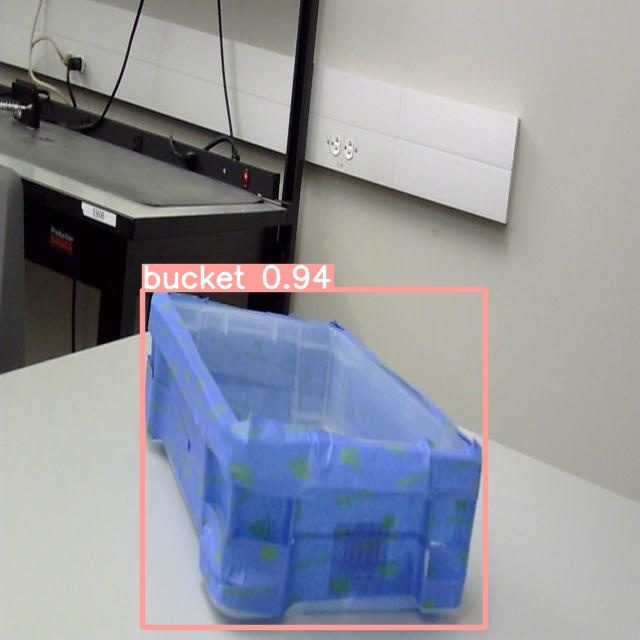
Object Dection and Gripper Arm/Object Detection/Source code/runs/detect/predict/WIN_20230304_14_48_45_Pro_jpg.rf.d2edaa73f7cdd017987211a29db16979.jpg
