Ali-Helmi/modular_robotics/Object Dection and Gripper Arm/Object Detection/Source code/runs/detect/predict/WIN_20230304_14_48_49_Pro_jpg.rf.f5be8b0f634f58380dcf9c016fd42464.jpg

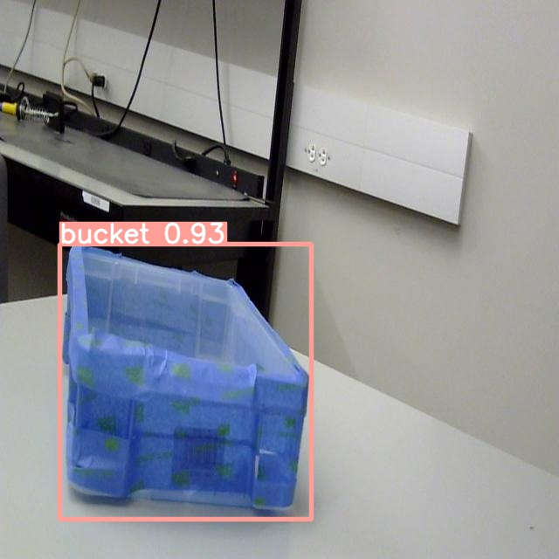
Object Dection and Gripper Arm/Object Detection/Source code/runs/detect/predict/WIN_20230304_14_48_49_Pro_jpg.rf.f5be8b0f634f58380dcf9c016fd42464.jpg
