Ali-Helmi/modular_robotics/Object Dection and Gripper Arm/Object Detection/Source code/runs/detect/predict/WIN_20230304_14_49_18_Pro-2-_jpg.rf.40296b98a6694dd991e0f5c5bda36253.jpg

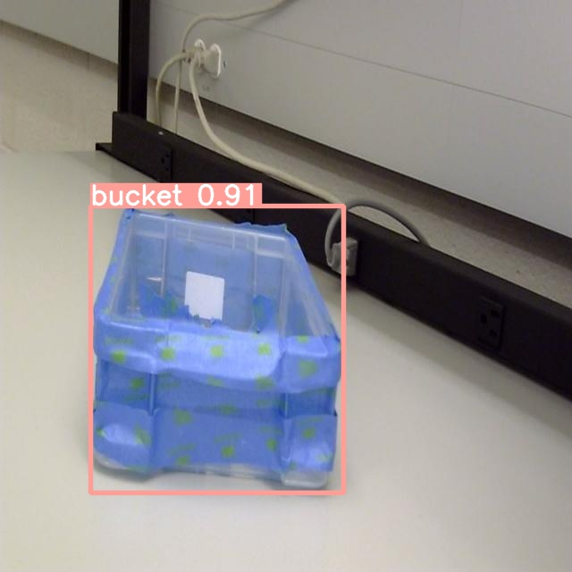
Object Dection and Gripper Arm/Object Detection/Source code/runs/detect/predict/WIN_20230304_14_49_18_Pro-2-_jpg.rf.40296b98a6694dd991e0f5c5bda36253.jpg
