Ali-Helmi/modular_robotics/Object Dection and Gripper Arm/Object Detection/Source code/runs/detect/predict/WIN_20230304_14_49_18_Pro_jpg.rf.6ad0076021e30d94ddaf0cc675c56f7b.jpg

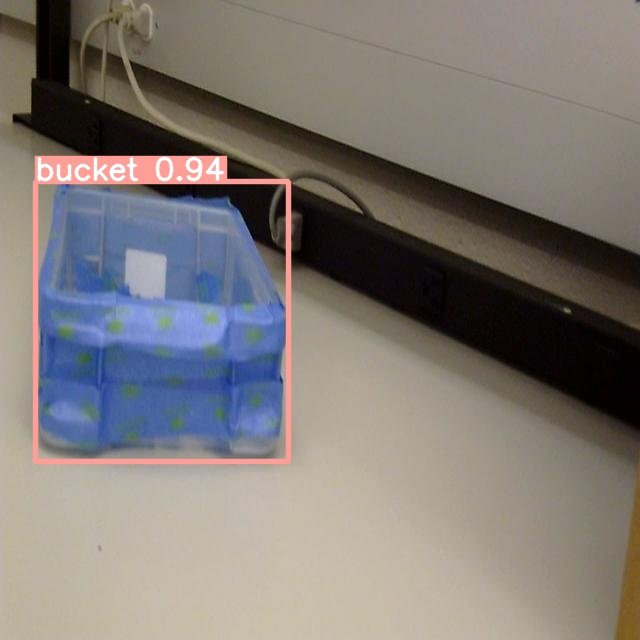
Object Dection and Gripper Arm/Object Detection/Source code/runs/detect/predict/WIN_20230304_14_49_18_Pro_jpg.rf.6ad0076021e30d94ddaf0cc675c56f7b.jpg
