Ali-Helmi/modular_robotics/Object Dection and Gripper Arm/Object Detection/Source code/runs/detect/predict/WIN_20230304_14_49_20_Pro_jpg.rf.9f84a50bb8383904dcbba25180c477c6.jpg

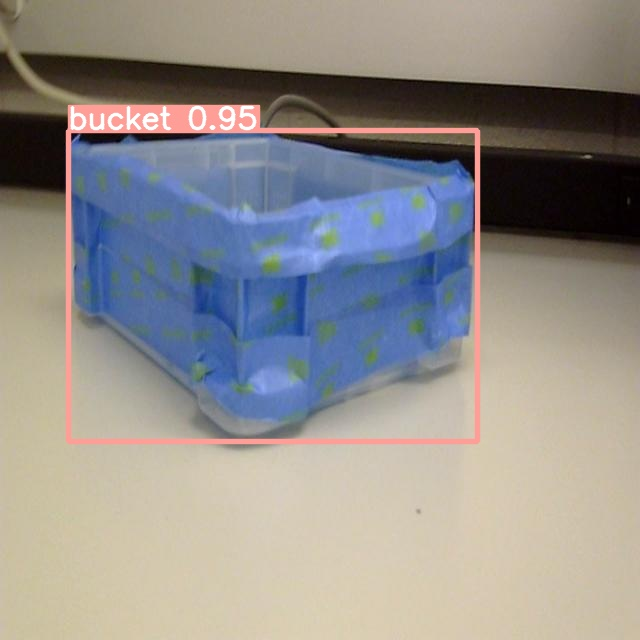
Object Dection and Gripper Arm/Object Detection/Source code/runs/detect/predict/WIN_20230304_14_49_20_Pro_jpg.rf.9f84a50bb8383904dcbba25180c477c6.jpg
