Ali-Helmi/modular_robotics/Object Dection and Gripper Arm/Object Detection/Source code/runs/detect/predict/WIN_20230304_14_49_21_Pro-2-_jpg.rf.b58da9c7e0e8edc387e3b7d142c59af5.jpg

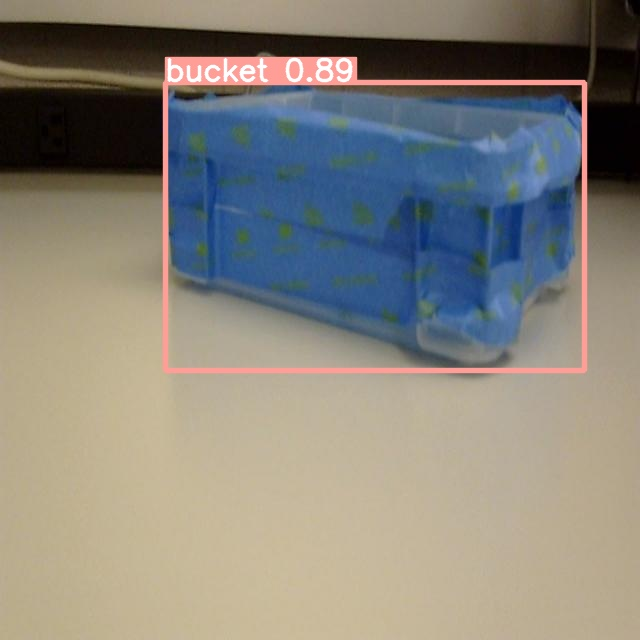
Object Dection and Gripper Arm/Object Detection/Source code/runs/detect/predict/WIN_20230304_14_49_21_Pro-2-_jpg.rf.b58da9c7e0e8edc387e3b7d142c59af5.jpg
