Ali-Helmi/modular_robotics/Object Dection and Gripper Arm/Object Detection/Source code/runs/detect/predict/WIN_20230304_14_49_21_Pro_jpg.rf.1c350e98f0405bd76f2a9eed6e580ce1.jpg

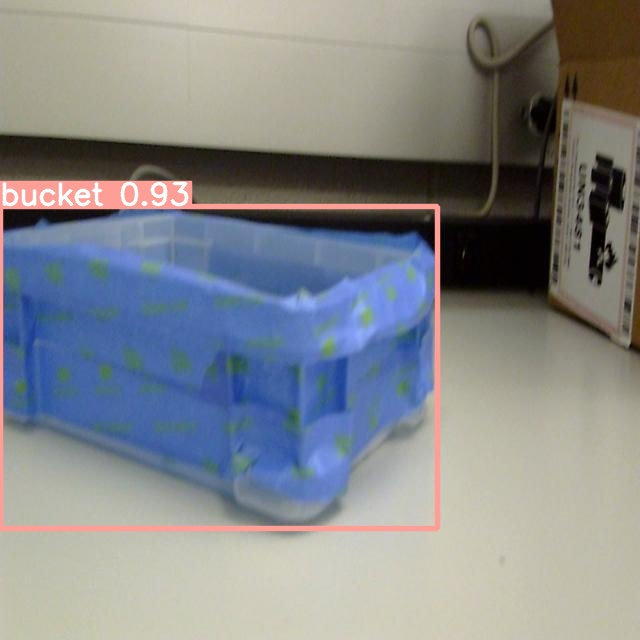
Object Dection and Gripper Arm/Object Detection/Source code/runs/detect/predict/WIN_20230304_14_49_21_Pro_jpg.rf.1c350e98f0405bd76f2a9eed6e580ce1.jpg
