Ali-Helmi/modular_robotics/Object Dection and Gripper Arm/Object Detection/Source code/runs/detect/predict/WIN_20230304_14_49_23_Pro_jpg.rf.ac087db0f7249e2eae21c289c21c8d93.jpg

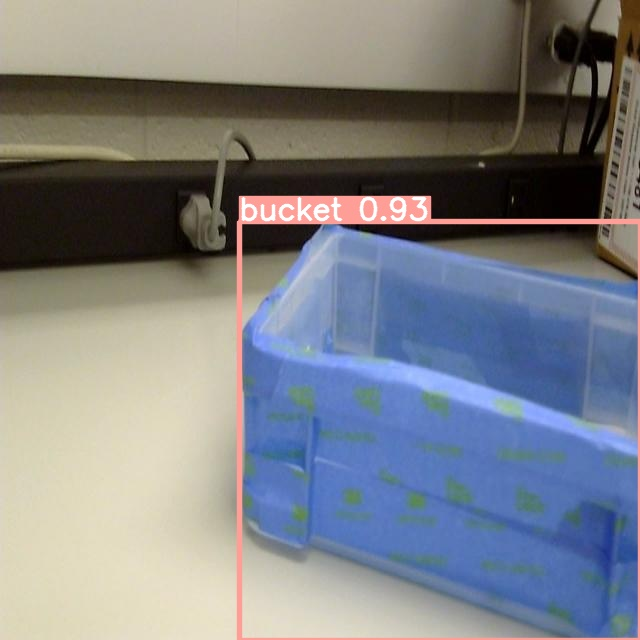
Object Dection and Gripper Arm/Object Detection/Source code/runs/detect/predict/WIN_20230304_14_49_23_Pro_jpg.rf.ac087db0f7249e2eae21c289c21c8d93.jpg
