Ali-Helmi/modular_robotics/Object Dection and Gripper Arm/Object Detection/Source code/runs/detect/predict/WIN_20230304_14_49_24_Pro_jpg.rf.4e52d64cfa2c5ca3434820039efc5289.jpg

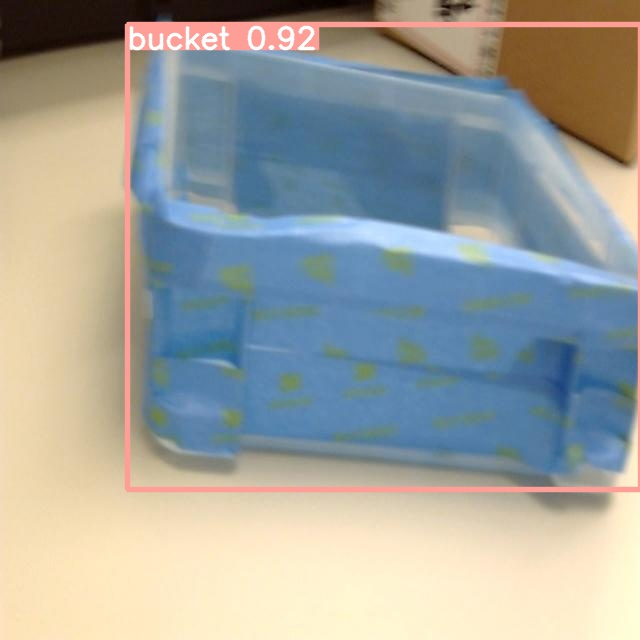
Object Dection and Gripper Arm/Object Detection/Source code/runs/detect/predict/WIN_20230304_14_49_24_Pro_jpg.rf.4e52d64cfa2c5ca3434820039efc5289.jpg
