Ali-Helmi/modular_robotics/Object Dection and Gripper Arm/Object Detection/Source code/runs/detect/predict/WIN_20230304_14_49_29_Pro_jpg.rf.9992d71a5b6e733b80d9029d1cfd01af.jpg

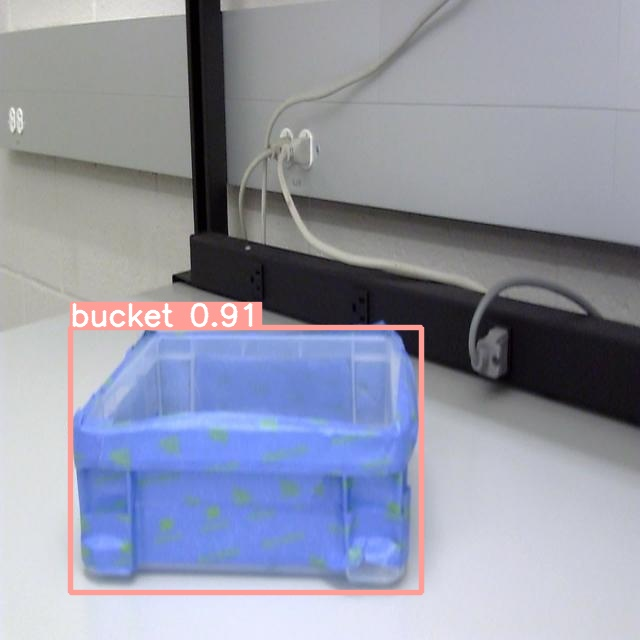
Object Dection and Gripper Arm/Object Detection/Source code/runs/detect/predict/WIN_20230304_14_49_29_Pro_jpg.rf.9992d71a5b6e733b80d9029d1cfd01af.jpg
