Ali-Helmi/modular_robotics/Object Dection and Gripper Arm/Object Detection/Source code/runs/detect/predict/WIN_20230304_14_49_30_Pro-2-_jpg.rf.bc72359d6a8329692b1e8d35709e5933.jpg

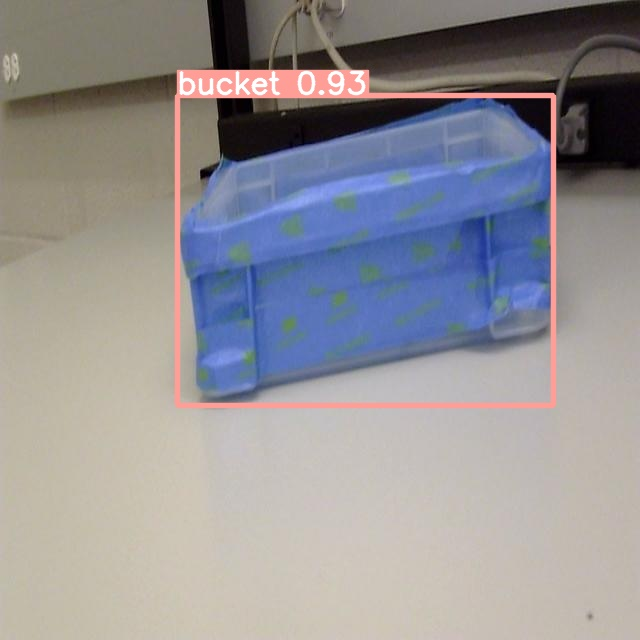
Object Dection and Gripper Arm/Object Detection/Source code/runs/detect/predict/WIN_20230304_14_49_30_Pro-2-_jpg.rf.bc72359d6a8329692b1e8d35709e5933.jpg
