Ali-Helmi/modular_robotics/Object Dection and Gripper Arm/Object Detection/Source code/runs/detect/predict/WIN_20230304_14_49_30_Pro_jpg.rf.d962908502c18c0b7d09894a5f6896f4.jpg

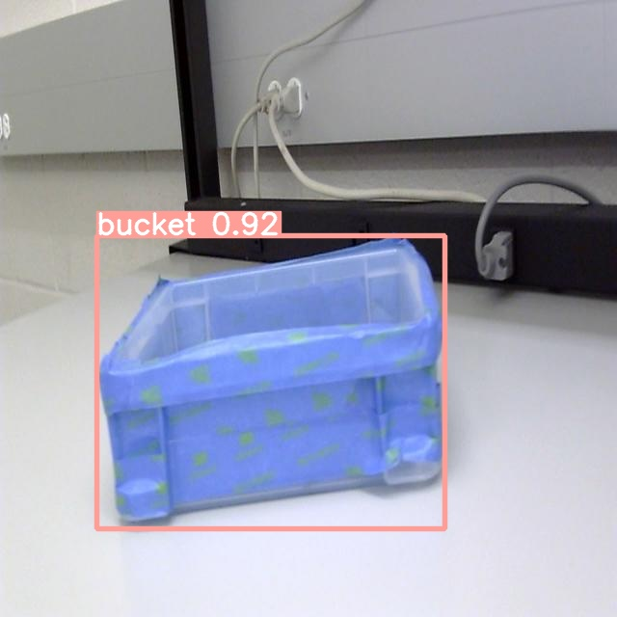
Object Dection and Gripper Arm/Object Detection/Source code/runs/detect/predict/WIN_20230304_14_49_30_Pro_jpg.rf.d962908502c18c0b7d09894a5f6896f4.jpg
