Ali-Helmi/modular_robotics/Object Dection and Gripper Arm/Object Detection/Source code/runs/detect/predict/WIN_20230304_14_49_32_Pro_jpg.rf.2ecabddede55c05cf26b78389f81c76c.jpg

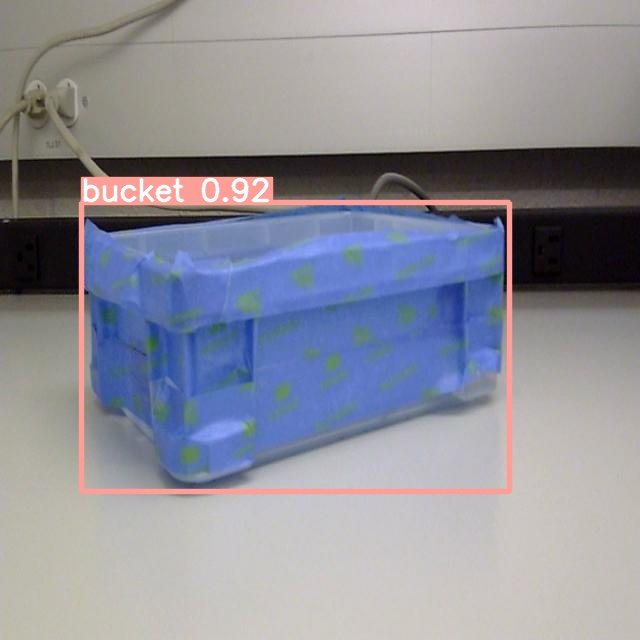
Object Dection and Gripper Arm/Object Detection/Source code/runs/detect/predict/WIN_20230304_14_49_32_Pro_jpg.rf.2ecabddede55c05cf26b78389f81c76c.jpg
