Ali-Helmi/modular_robotics/Object Dection and Gripper Arm/Object Detection/Source code/runs/detect/predict/WIN_20230304_14_49_35_Pro_jpg.rf.3351db3e97e9774fb5ce38f87013e334.jpg

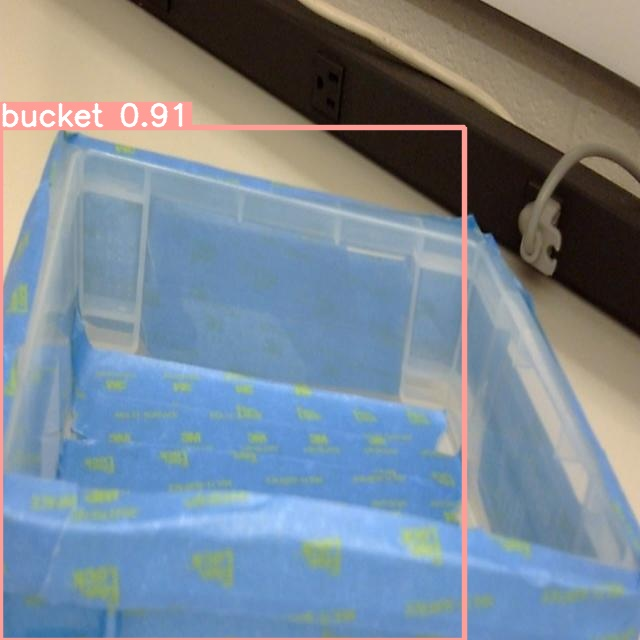
Object Dection and Gripper Arm/Object Detection/Source code/runs/detect/predict/WIN_20230304_14_49_35_Pro_jpg.rf.3351db3e97e9774fb5ce38f87013e334.jpg
