Ali-Helmi/modular_robotics/Object Dection and Gripper Arm/Object Detection/Source code/runs/detect/predict/WIN_20230304_14_49_39_Pro_jpg.rf.794fe931cdc10fef4bd9d6371243f491.jpg

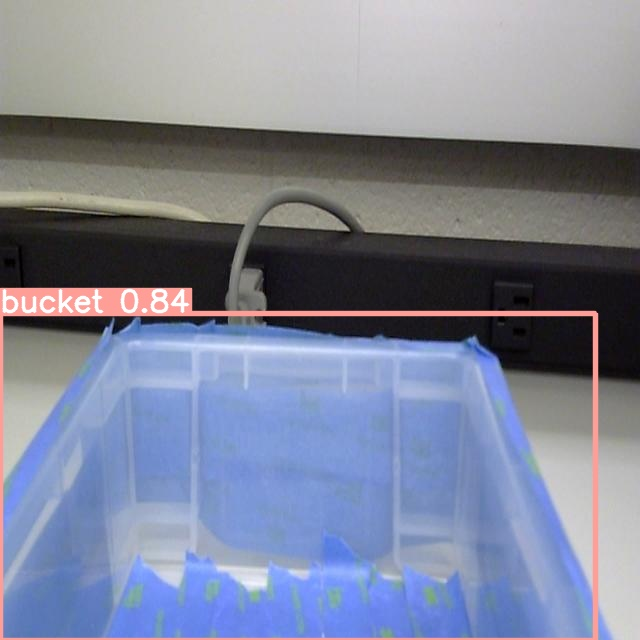
Object Dection and Gripper Arm/Object Detection/Source code/runs/detect/predict/WIN_20230304_14_49_39_Pro_jpg.rf.794fe931cdc10fef4bd9d6371243f491.jpg
