Ali-Helmi/modular_robotics/Object Dection and Gripper Arm/Object Detection/Source code/runs/detect/predict/WIN_20230304_14_49_40_Pro_jpg.rf.0b7ae8f24d247cfe2c9de858f47e9dc7.jpg

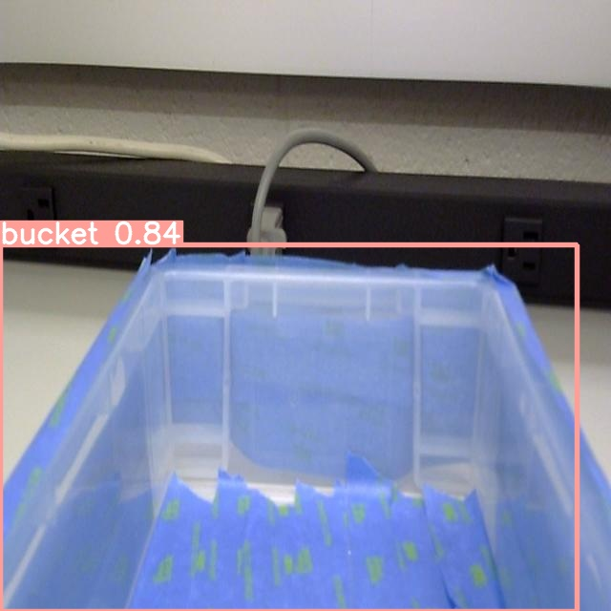
Object Dection and Gripper Arm/Object Detection/Source code/runs/detect/predict/WIN_20230304_14_49_40_Pro_jpg.rf.0b7ae8f24d247cfe2c9de858f47e9dc7.jpg
