Ali-Helmi/modular_robotics/Object Dection and Gripper Arm/Object Detection/Source code/runs/detect/predict/WIN_20230304_14_49_42_Pro_jpg.rf.ecb39163936746ccbc8a0b3ed40c6ea9.jpg

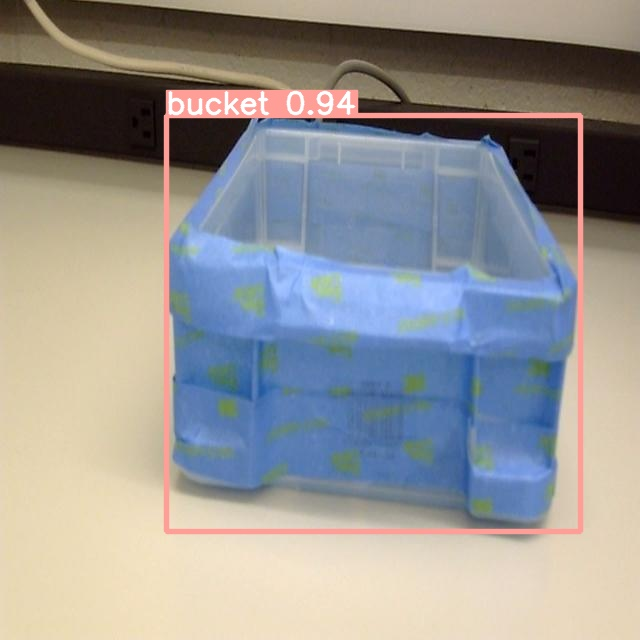
Object Dection and Gripper Arm/Object Detection/Source code/runs/detect/predict/WIN_20230304_14_49_42_Pro_jpg.rf.ecb39163936746ccbc8a0b3ed40c6ea9.jpg
