Ali-Helmi/modular_robotics/Object Dection and Gripper Arm/Object Detection/Source code/runs/detect/predict/WIN_20230304_14_49_43_Pro_jpg.rf.e0da24f99922b47fdc4b7af2ba8dfe9c.jpg

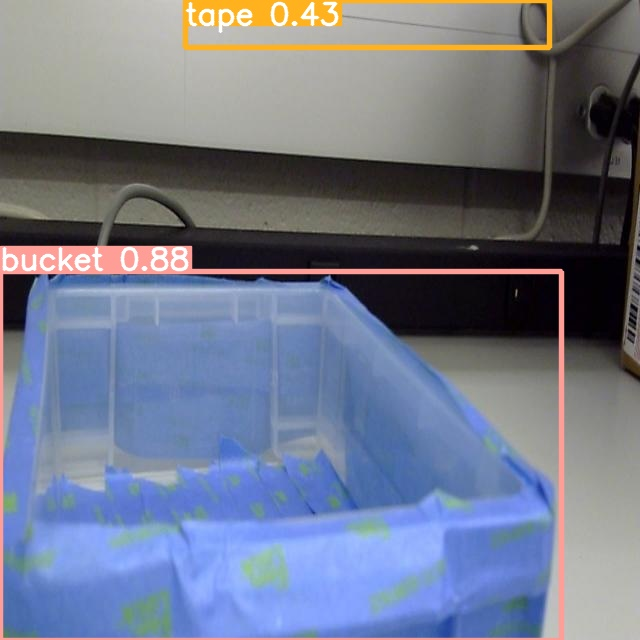
Object Dection and Gripper Arm/Object Detection/Source code/runs/detect/predict/WIN_20230304_14_49_43_Pro_jpg.rf.e0da24f99922b47fdc4b7af2ba8dfe9c.jpg
