Ali-Helmi/modular_robotics/Object Dection and Gripper Arm/Object Detection/Source code/runs/detect/predict/WIN_20230304_14_49_51_Pro_jpg.rf.3da37361e55337ab01c40cd0485cd9bd.jpg

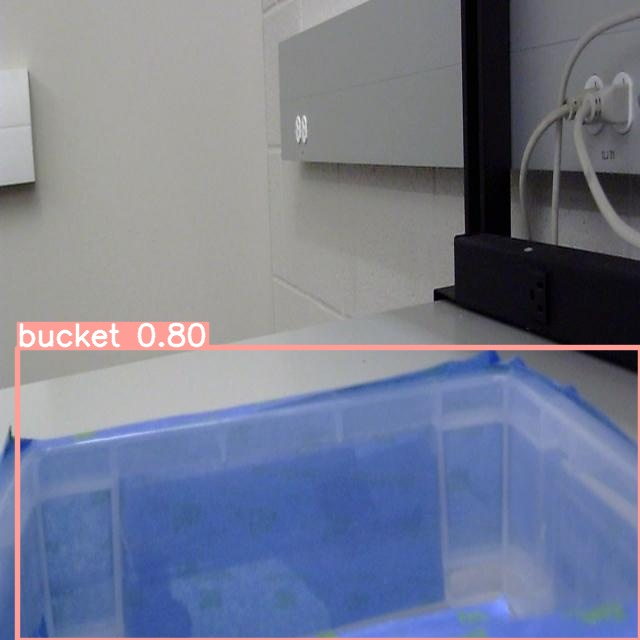
Object Dection and Gripper Arm/Object Detection/Source code/runs/detect/predict/WIN_20230304_14_49_51_Pro_jpg.rf.3da37361e55337ab01c40cd0485cd9bd.jpg
