Ali-Helmi/modular_robotics/Object Dection and Gripper Arm/Object Detection/Source code/runs/detect/predict/WIN_20230304_14_49_54_Pro_jpg.rf.73b31e1edb7322927ed5406c2f8c88e9.jpg

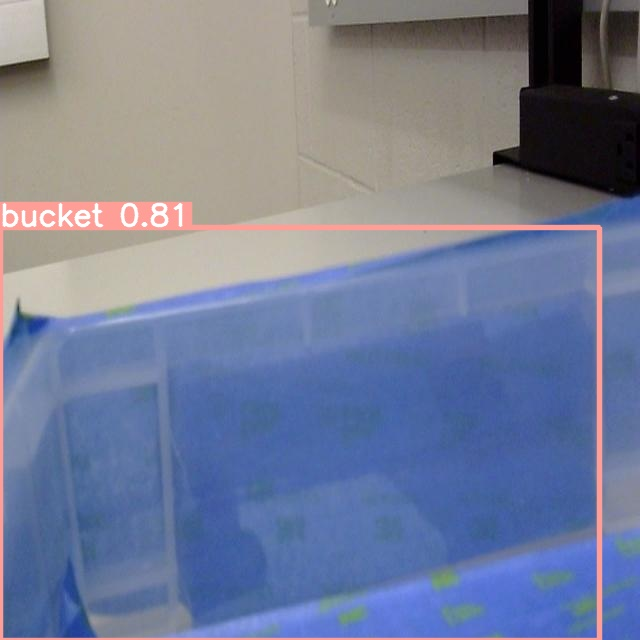
Object Dection and Gripper Arm/Object Detection/Source code/runs/detect/predict/WIN_20230304_14_49_54_Pro_jpg.rf.73b31e1edb7322927ed5406c2f8c88e9.jpg
