Ali-Helmi/modular_robotics/Object Dection and Gripper Arm/Object Detection/Source code/runs/detect/predict/WIN_20230304_14_49_57_Pro_jpg.rf.a7d962164d650b200921ca3bd62d5140.jpg

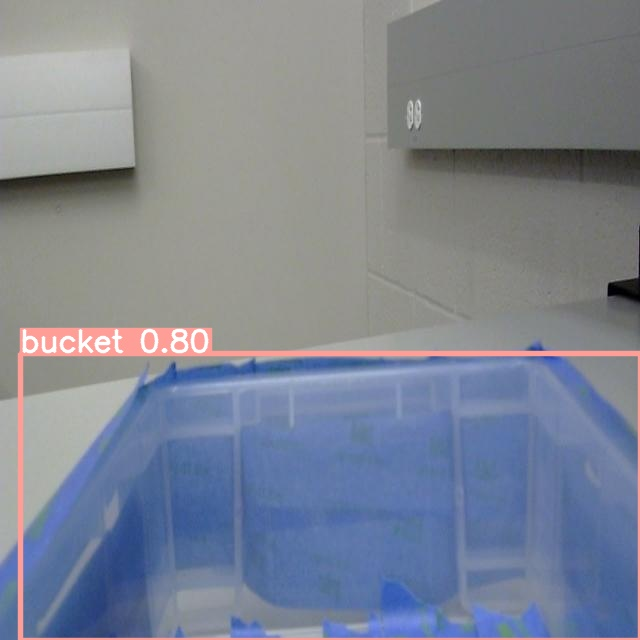
Object Dection and Gripper Arm/Object Detection/Source code/runs/detect/predict/WIN_20230304_14_49_57_Pro_jpg.rf.a7d962164d650b200921ca3bd62d5140.jpg
