Ali-Helmi/modular_robotics/Object Dection and Gripper Arm/Object Detection/Source code/runs/detect/predict/WIN_20230304_14_49_58_Pro_jpg.rf.5b450190fc0497180ceec3f7968df04d.jpg

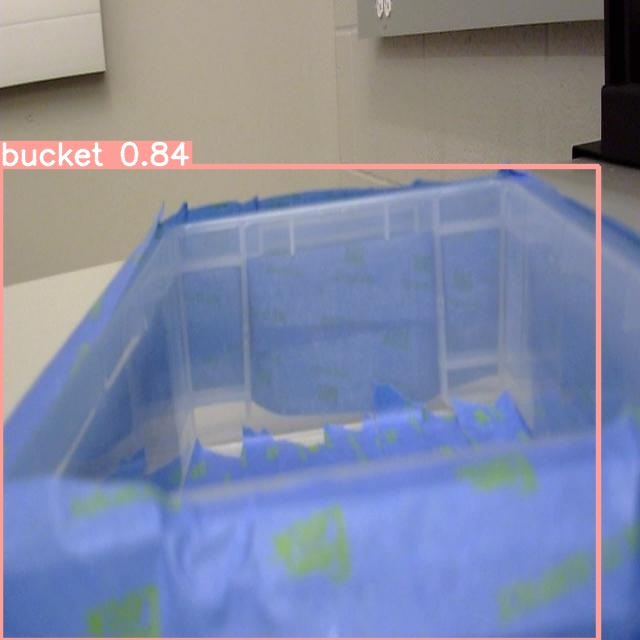
Object Dection and Gripper Arm/Object Detection/Source code/runs/detect/predict/WIN_20230304_14_49_58_Pro_jpg.rf.5b450190fc0497180ceec3f7968df04d.jpg
