Ali-Helmi/modular_robotics/Object Dection and Gripper Arm/Object Detection/Source code/runs/detect/predict/WIN_20230304_14_50_00_Pro_jpg.rf.7bc9ea965251cde1c69ce1c11c8a9e60.jpg

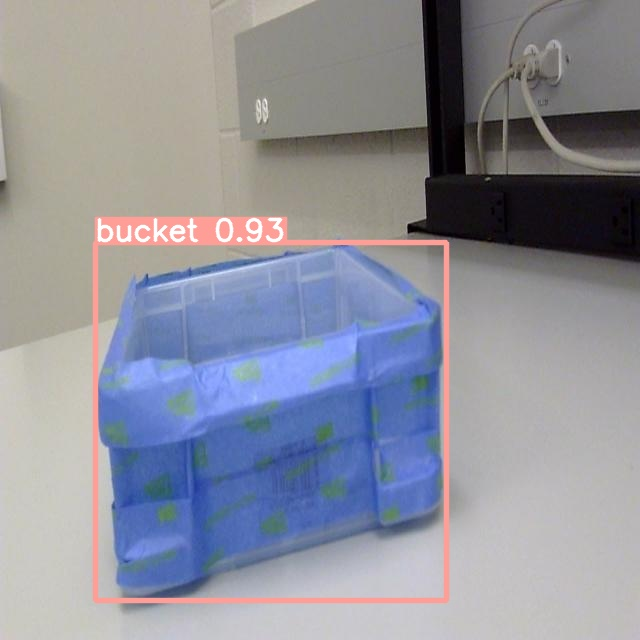
Object Dection and Gripper Arm/Object Detection/Source code/runs/detect/predict/WIN_20230304_14_50_00_Pro_jpg.rf.7bc9ea965251cde1c69ce1c11c8a9e60.jpg
