Ali-Helmi/modular_robotics/Object Dection and Gripper Arm/Object Detection/Source code/runs/detect/predict/WIN_20230304_14_50_05_Pro_jpg.rf.dfff0ebf71373d765927e24b974f6400.jpg

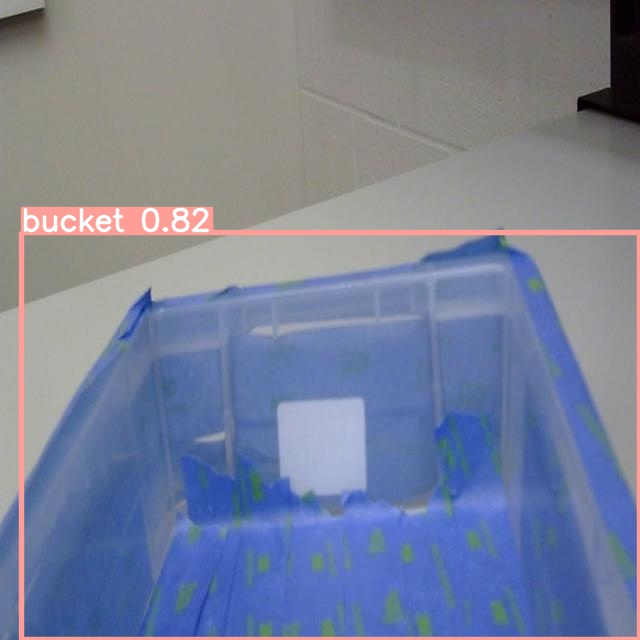
Object Dection and Gripper Arm/Object Detection/Source code/runs/detect/predict/WIN_20230304_14_50_05_Pro_jpg.rf.dfff0ebf71373d765927e24b974f6400.jpg
