Ali-Helmi/modular_robotics/Object Dection and Gripper Arm/Object Detection/Source code/runs/detect/predict/WIN_20230304_14_50_06_Pro_jpg.rf.391a799db9262c05b175812b11b5e2f3.jpg

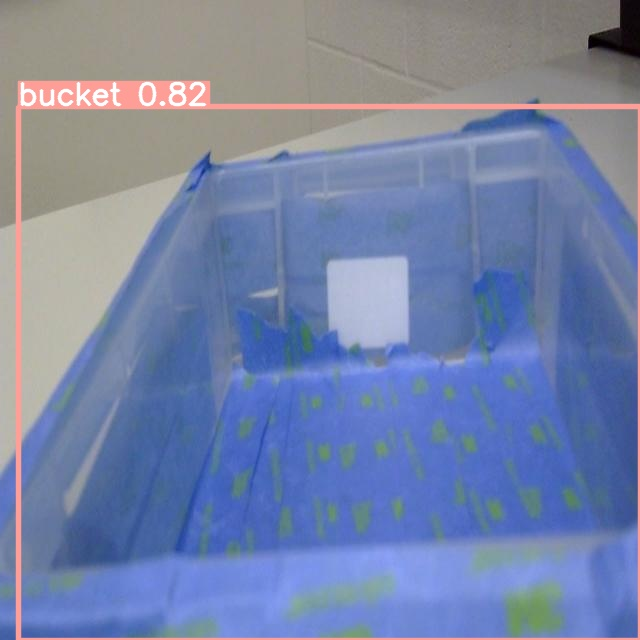
Object Dection and Gripper Arm/Object Detection/Source code/runs/detect/predict/WIN_20230304_14_50_06_Pro_jpg.rf.391a799db9262c05b175812b11b5e2f3.jpg
