Ali-Helmi/modular_robotics/Object Dection and Gripper Arm/Object Detection/Source code/runs/detect/predict/WIN_20230304_14_50_07_Pro_jpg.rf.1597d24cfdc0ec8e97d4e1db2131fbc2.jpg

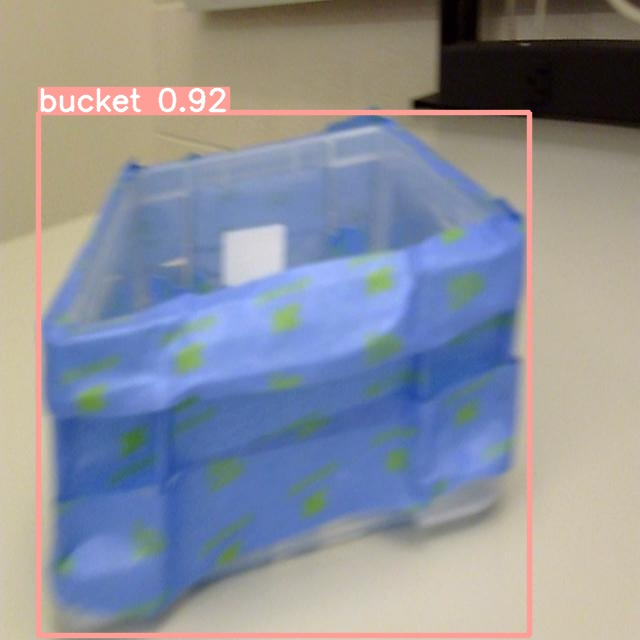
Object Dection and Gripper Arm/Object Detection/Source code/runs/detect/predict/WIN_20230304_14_50_07_Pro_jpg.rf.1597d24cfdc0ec8e97d4e1db2131fbc2.jpg
