Ali-Helmi/modular_robotics/Object Dection and Gripper Arm/Object Detection/Source code/runs/detect/predict/WIN_20230304_14_50_08_Pro_jpg.rf.476732ffd5344557595fa426ad9012ff.jpg

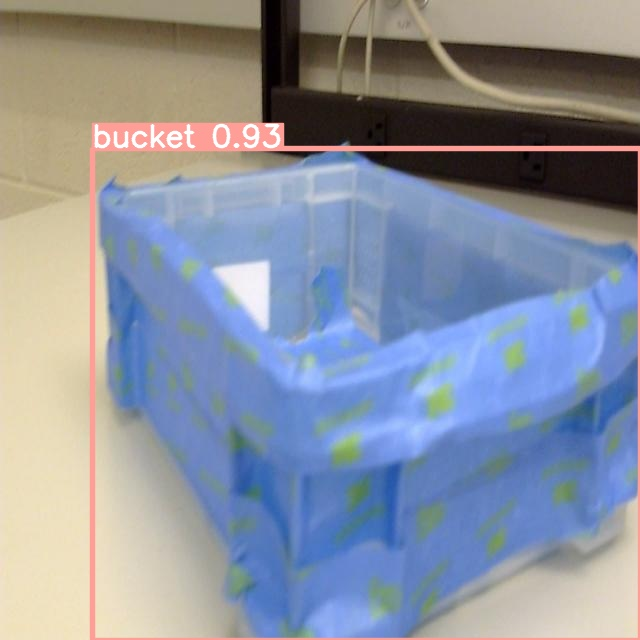
Object Dection and Gripper Arm/Object Detection/Source code/runs/detect/predict/WIN_20230304_14_50_08_Pro_jpg.rf.476732ffd5344557595fa426ad9012ff.jpg
