Ali-Helmi/modular_robotics/Object Dection and Gripper Arm/Object Detection/Source code/runs/detect/predict/WIN_20230304_14_50_09_Pro_jpg.rf.d7391adcfece9db5724f4b740da0280c.jpg

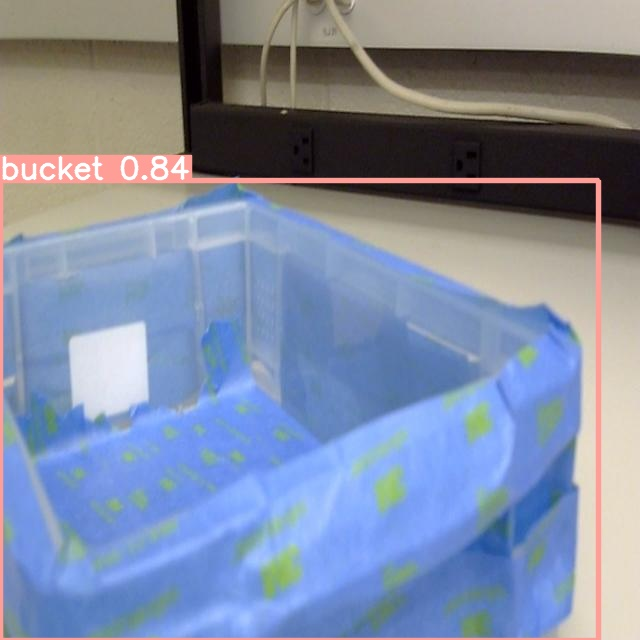
Object Dection and Gripper Arm/Object Detection/Source code/runs/detect/predict/WIN_20230304_14_50_09_Pro_jpg.rf.d7391adcfece9db5724f4b740da0280c.jpg
