Ali-Helmi/modular_robotics/Object Dection and Gripper Arm/Object Detection/Source code/runs/detect/predict/WIN_20230304_14_50_11_Pro_jpg.rf.8e973e08be1a7de0de0e9ebd1caa654f.jpg

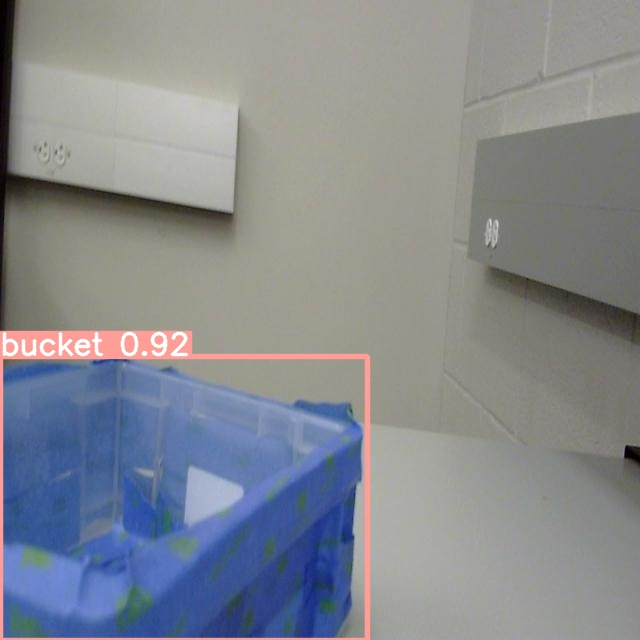
Object Dection and Gripper Arm/Object Detection/Source code/runs/detect/predict/WIN_20230304_14_50_11_Pro_jpg.rf.8e973e08be1a7de0de0e9ebd1caa654f.jpg
