Ali-Helmi/modular_robotics/Object Dection and Gripper Arm/Object Detection/Source code/runs/detect/predict/WIN_20230304_14_50_12_Pro_jpg.rf.cfaa60d3e09adba76f5d1a509303dc82.jpg

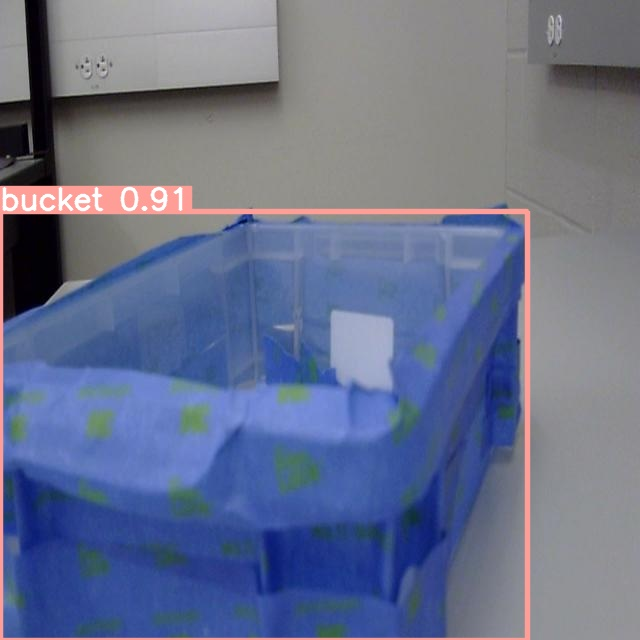
Object Dection and Gripper Arm/Object Detection/Source code/runs/detect/predict/WIN_20230304_14_50_12_Pro_jpg.rf.cfaa60d3e09adba76f5d1a509303dc82.jpg
