Ali-Helmi/modular_robotics/Object Dection and Gripper Arm/Object Detection/Source code/runs/detect/predict/WIN_20230304_14_50_14_Pro-2-_jpg.rf.4c511e84b7cabc03f0e35fab618101ab.jpg

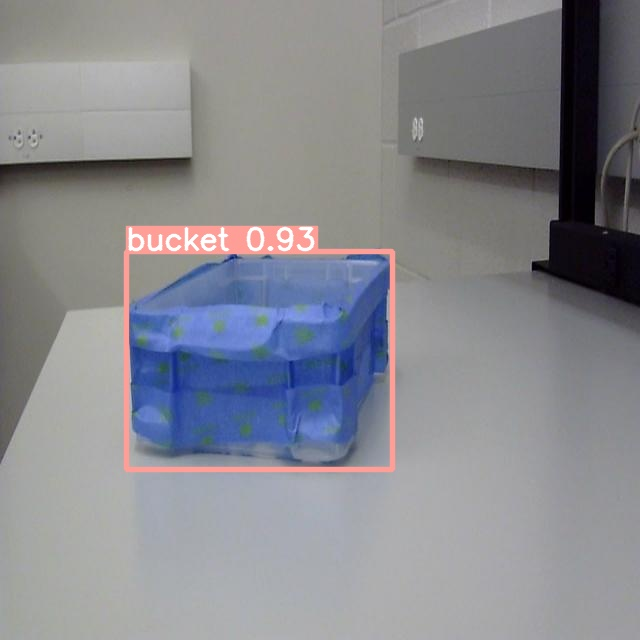
Object Dection and Gripper Arm/Object Detection/Source code/runs/detect/predict/WIN_20230304_14_50_14_Pro-2-_jpg.rf.4c511e84b7cabc03f0e35fab618101ab.jpg
