Ali-Helmi/modular_robotics/Object Dection and Gripper Arm/Object Detection/Source code/runs/detect/predict/WIN_20230304_14_50_14_Pro_jpg.rf.f851fdad19f463f0924a4c0e8c6e9f46.jpg

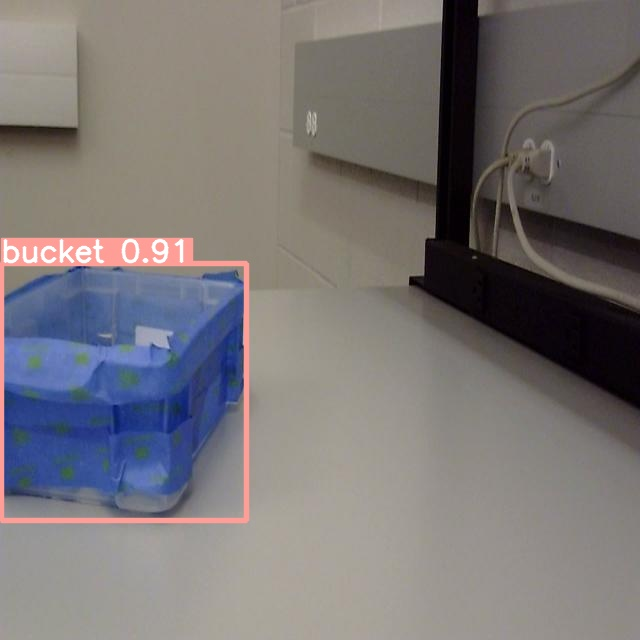
Object Dection and Gripper Arm/Object Detection/Source code/runs/detect/predict/WIN_20230304_14_50_14_Pro_jpg.rf.f851fdad19f463f0924a4c0e8c6e9f46.jpg
