Ali-Helmi/modular_robotics/Object Dection and Gripper Arm/Object Detection/Source code/runs/detect/predict/WIN_20230304_14_50_15_Pro_jpg.rf.caeb3a0ccc3e39be45a2c2cac4016d2b.jpg

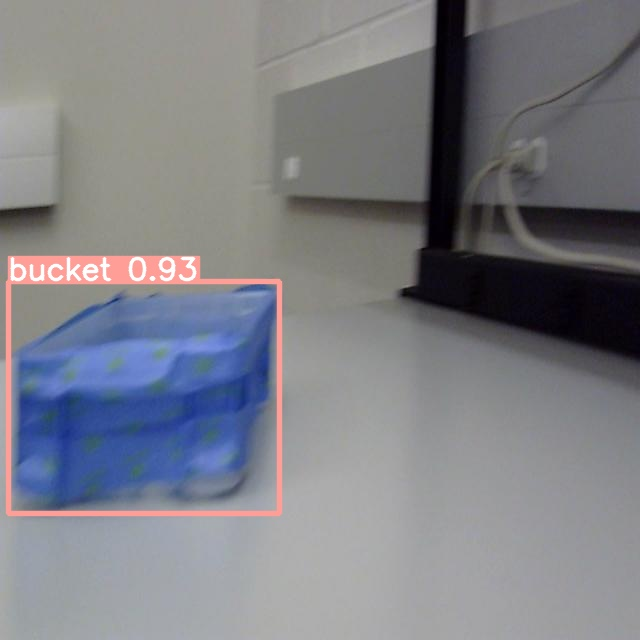
Object Dection and Gripper Arm/Object Detection/Source code/runs/detect/predict/WIN_20230304_14_50_15_Pro_jpg.rf.caeb3a0ccc3e39be45a2c2cac4016d2b.jpg
