Ali-Helmi/modular_robotics/Object Dection and Gripper Arm/Object Detection/Source code/runs/detect/predict/WIN_20230304_14_50_17_Pro_jpg.rf.59cbdf5b2377c3ddcc6756e1f8af1f67.jpg

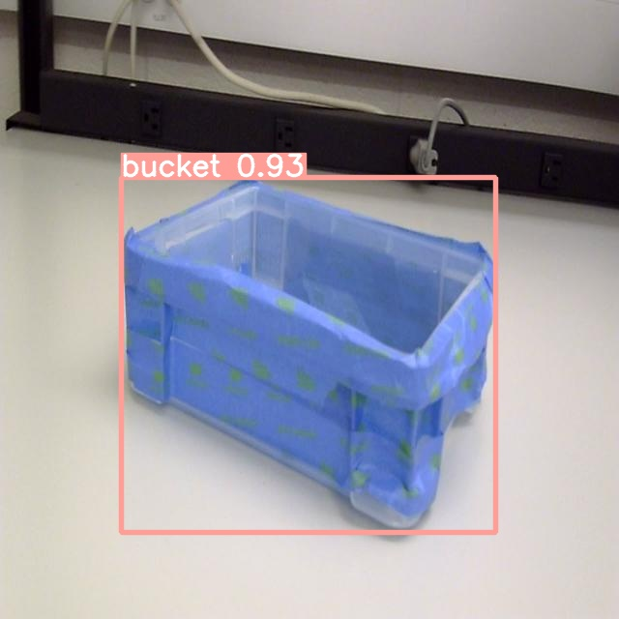
Object Dection and Gripper Arm/Object Detection/Source code/runs/detect/predict/WIN_20230304_14_50_17_Pro_jpg.rf.59cbdf5b2377c3ddcc6756e1f8af1f67.jpg
