Ali-Helmi/modular_robotics/Object Dection and Gripper Arm/Object Detection/Source code/runs/detect/predict/WIN_20230304_14_50_18_Pro_jpg.rf.89cf818595abe91fe9cceaba33c6d5c7.jpg

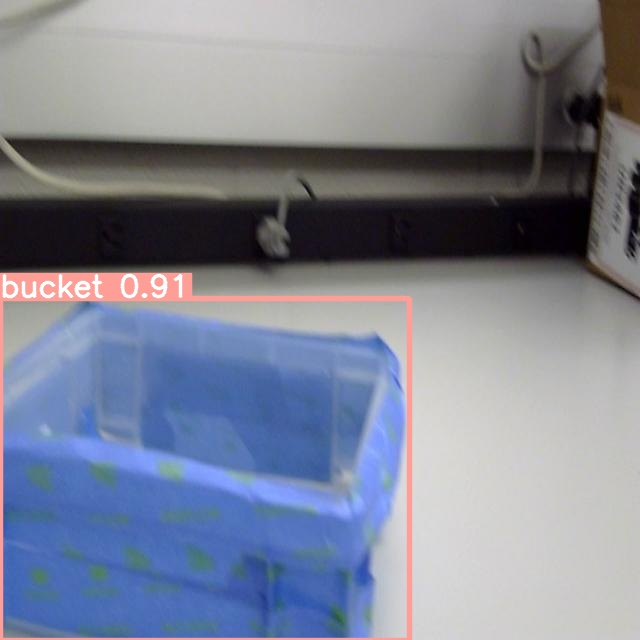
Object Dection and Gripper Arm/Object Detection/Source code/runs/detect/predict/WIN_20230304_14_50_18_Pro_jpg.rf.89cf818595abe91fe9cceaba33c6d5c7.jpg
