Ali-Helmi/modular_robotics/Object Dection and Gripper Arm/Object Detection/Source code/runs/detect/predict/WIN_20230304_14_50_20_Pro_jpg.rf.38b64e348074e1c0fd59d26f643f6258.jpg

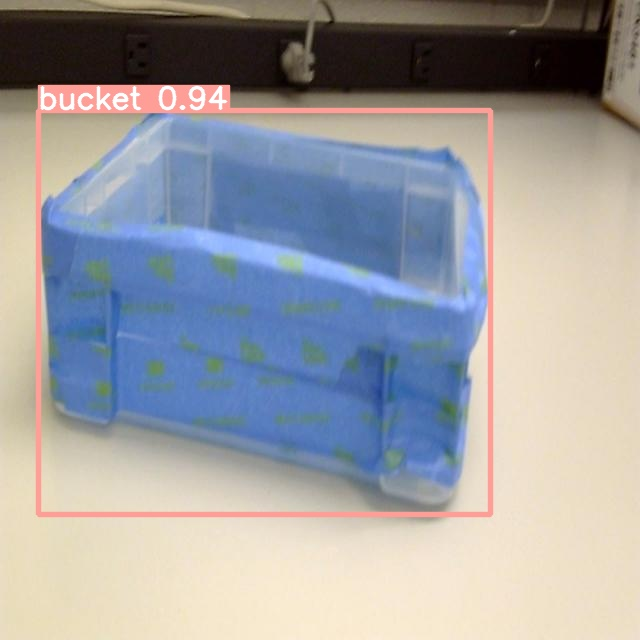
Object Dection and Gripper Arm/Object Detection/Source code/runs/detect/predict/WIN_20230304_14_50_20_Pro_jpg.rf.38b64e348074e1c0fd59d26f643f6258.jpg
