Ali-Helmi/modular_robotics/Object Dection and Gripper Arm/Object Detection/Source code/runs/detect/predict/WIN_20230304_14_50_22_Pro_jpg.rf.fe85290f1ed16287fbb2b5551db84e3a.jpg

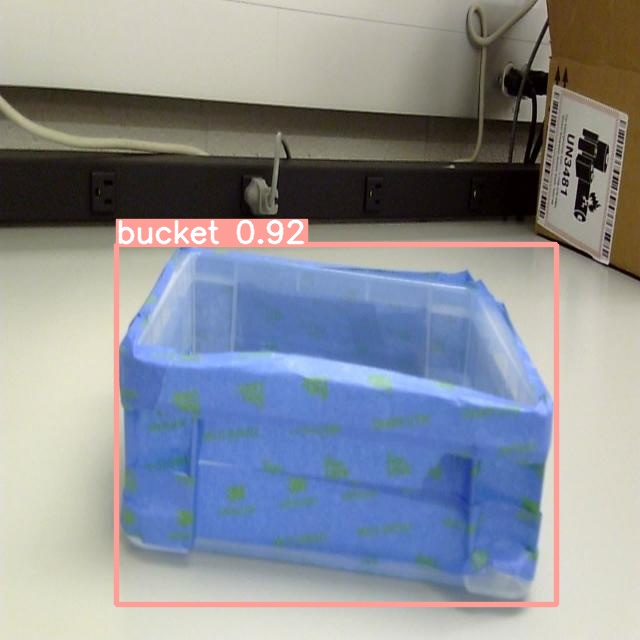
Object Dection and Gripper Arm/Object Detection/Source code/runs/detect/predict/WIN_20230304_14_50_22_Pro_jpg.rf.fe85290f1ed16287fbb2b5551db84e3a.jpg
