Ali-Helmi/modular_robotics/Object Dection and Gripper Arm/Object Detection/Source code/runs/detect/predict/WIN_20230304_14_50_24_Pro_jpg.rf.71905244a8d7ec243bb5760a7569f439.jpg

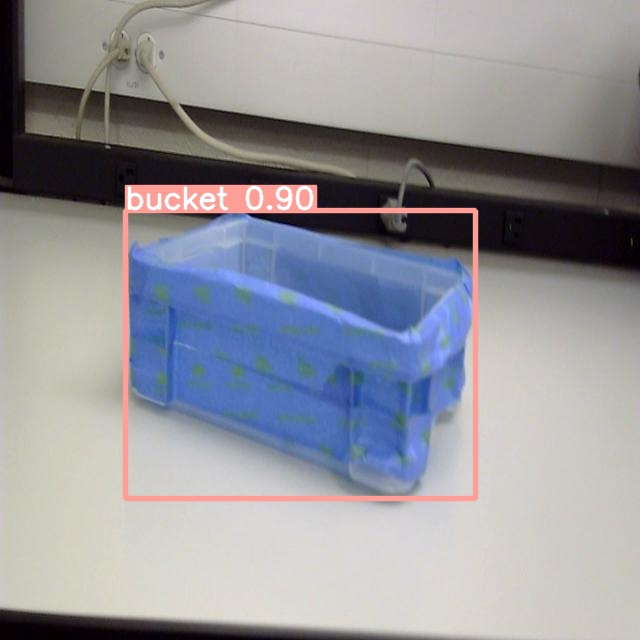
Object Dection and Gripper Arm/Object Detection/Source code/runs/detect/predict/WIN_20230304_14_50_24_Pro_jpg.rf.71905244a8d7ec243bb5760a7569f439.jpg
