Ali-Helmi/modular_robotics/Object Dection and Gripper Arm/Object Detection/Source code/runs/detect/predict/WIN_20230304_14_50_30_Pro_jpg.rf.3e4f06d4425b5f7623a65ffbbb94d6d8.jpg

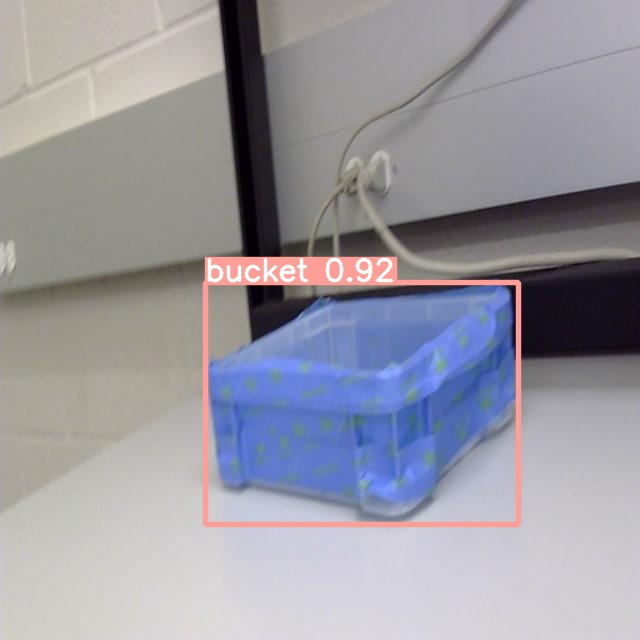
Object Dection and Gripper Arm/Object Detection/Source code/runs/detect/predict/WIN_20230304_14_50_30_Pro_jpg.rf.3e4f06d4425b5f7623a65ffbbb94d6d8.jpg
