Ali-Helmi/modular_robotics/Object Dection and Gripper Arm/Object Detection/Source code/runs/detect/predict/WIN_20230304_14_50_31_Pro_jpg.rf.343aaf48f283fd798304e9bb661755e6.jpg

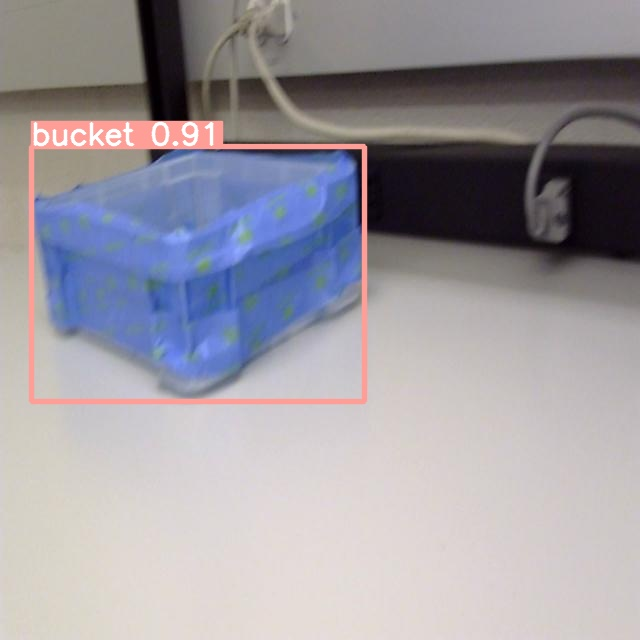
Object Dection and Gripper Arm/Object Detection/Source code/runs/detect/predict/WIN_20230304_14_50_31_Pro_jpg.rf.343aaf48f283fd798304e9bb661755e6.jpg
