Ali-Helmi/modular_robotics/Object Dection and Gripper Arm/Object Detection/Source code/runs/detect/predict/WIN_20230304_14_50_32_Pro_jpg.rf.6c81bbd1367f5ced7e10e8cad06f85a4.jpg

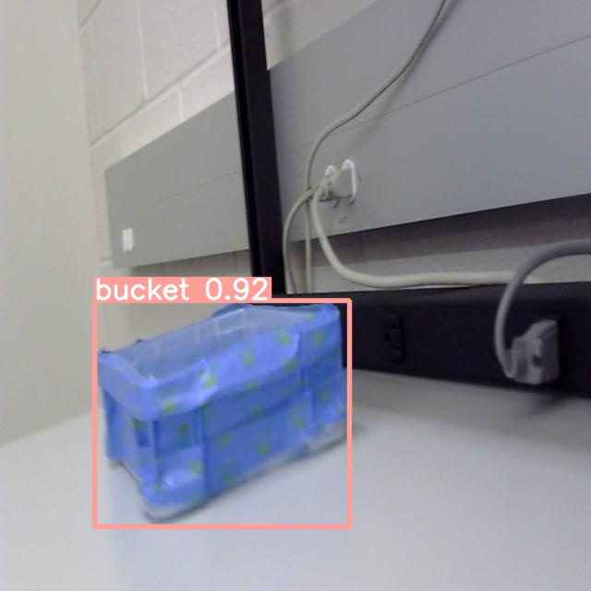
Object Dection and Gripper Arm/Object Detection/Source code/runs/detect/predict/WIN_20230304_14_50_32_Pro_jpg.rf.6c81bbd1367f5ced7e10e8cad06f85a4.jpg
