Ali-Helmi/modular_robotics/Object Dection and Gripper Arm/Object Detection/Source code/runs/detect/predict/WIN_20230304_14_50_33_Pro_jpg.rf.0ad00d70b5c28584a752e1b21b224910.jpg

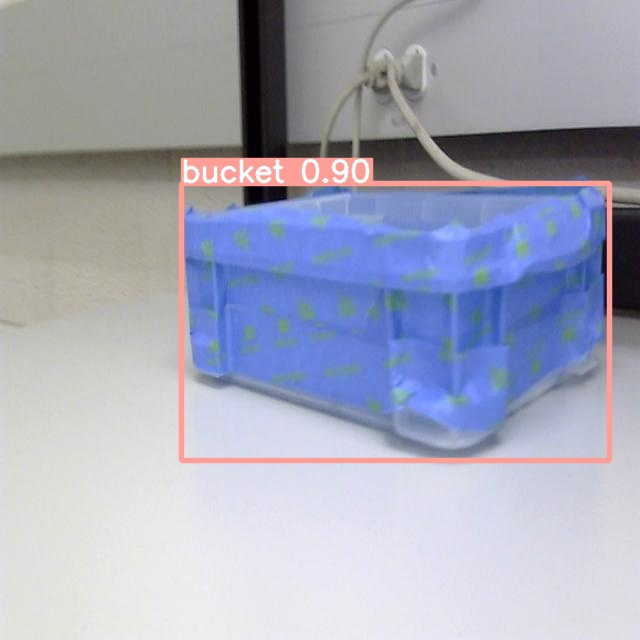
Object Dection and Gripper Arm/Object Detection/Source code/runs/detect/predict/WIN_20230304_14_50_33_Pro_jpg.rf.0ad00d70b5c28584a752e1b21b224910.jpg
