Ali-Helmi/modular_robotics/Object Dection and Gripper Arm/Object Detection/Source code/runs/detect/predict/WIN_20230304_14_50_34_Pro_jpg.rf.e65a4398f8de77c3d9624701245af56a.jpg

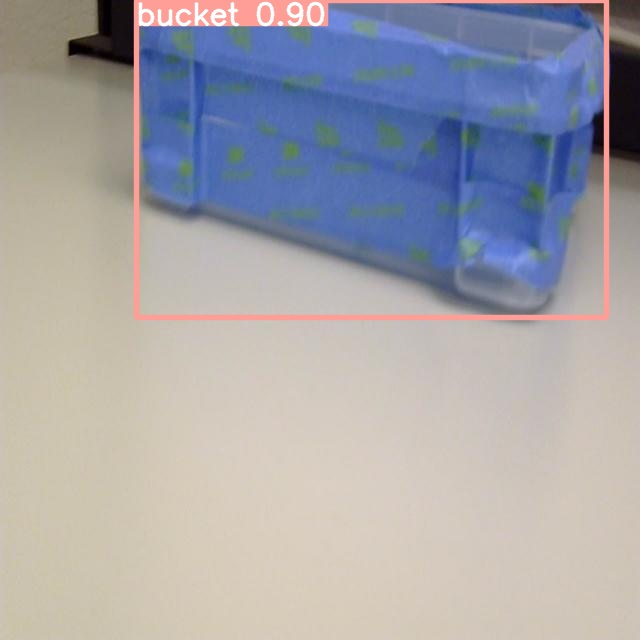
Object Dection and Gripper Arm/Object Detection/Source code/runs/detect/predict/WIN_20230304_14_50_34_Pro_jpg.rf.e65a4398f8de77c3d9624701245af56a.jpg
