Ali-Helmi/modular_robotics/Object Dection and Gripper Arm/Object Detection/Source code/runs/detect/predict/WIN_20230304_14_50_35_Pro_jpg.rf.6d86a0aef9b45ca2acf78aaabe6190a9.jpg

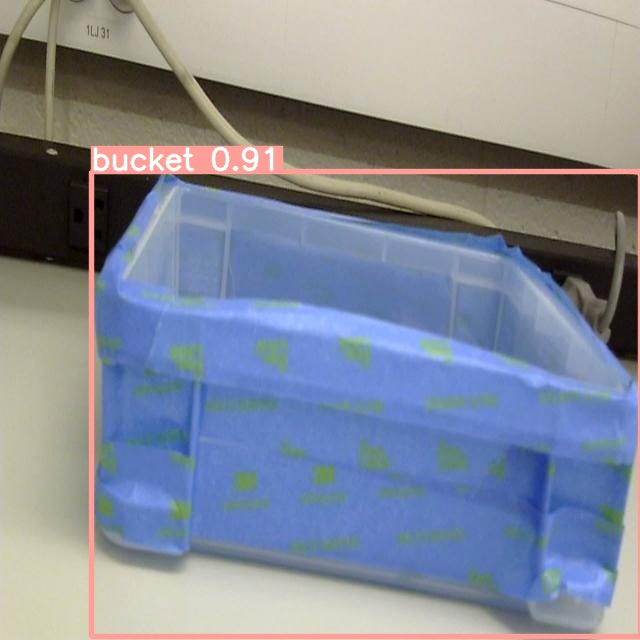
Object Dection and Gripper Arm/Object Detection/Source code/runs/detect/predict/WIN_20230304_14_50_35_Pro_jpg.rf.6d86a0aef9b45ca2acf78aaabe6190a9.jpg
