Ali-Helmi/modular_robotics/Object Dection and Gripper Arm/Object Detection/Source code/runs/detect/predict/WIN_20230304_14_50_37_Pro_jpg.rf.5d96b379f7a5f427c8bc481b1b351ca3.jpg

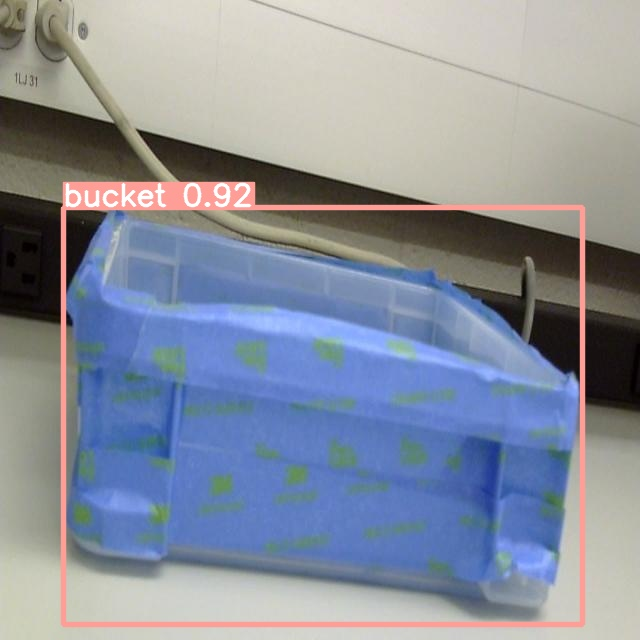
Object Dection and Gripper Arm/Object Detection/Source code/runs/detect/predict/WIN_20230304_14_50_37_Pro_jpg.rf.5d96b379f7a5f427c8bc481b1b351ca3.jpg
