Ali-Helmi/modular_robotics/Object Dection and Gripper Arm/Object Detection/Source code/runs/detect/predict/WIN_20230304_14_50_39_Pro_jpg.rf.340c8423a65bc791c2d0292924cbdbdd.jpg

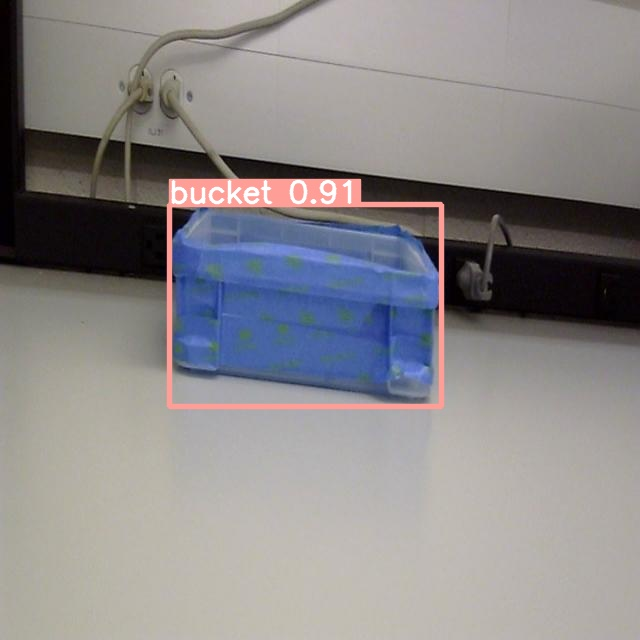
Object Dection and Gripper Arm/Object Detection/Source code/runs/detect/predict/WIN_20230304_14_50_39_Pro_jpg.rf.340c8423a65bc791c2d0292924cbdbdd.jpg
