Ali-Helmi/modular_robotics/Object Dection and Gripper Arm/Object Detection/Source code/runs/detect/predict/WIN_20230304_14_50_41_Pro_jpg.rf.4c532bffde5d35cd4edd6121ef1598b3.jpg

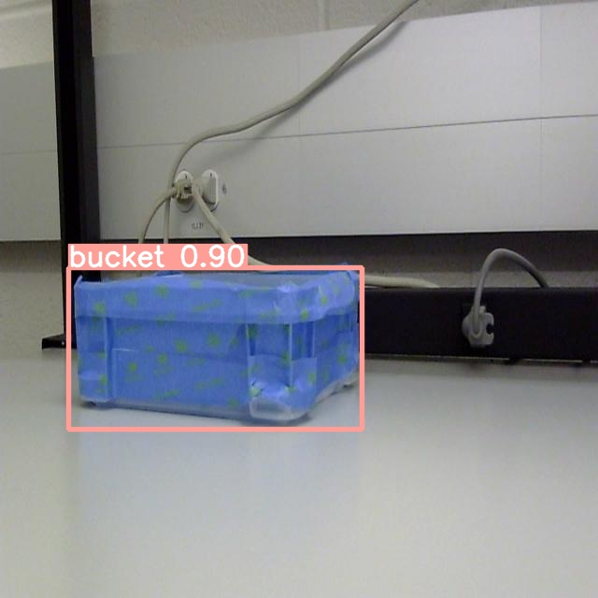
Object Dection and Gripper Arm/Object Detection/Source code/runs/detect/predict/WIN_20230304_14_50_41_Pro_jpg.rf.4c532bffde5d35cd4edd6121ef1598b3.jpg
