Ali-Helmi/modular_robotics/Object Dection and Gripper Arm/Object Detection/Source code/runs/detect/predict/WIN_20230304_14_50_45_Pro_jpg.rf.23dc87295125bc182ab2043e64188fb5.jpg

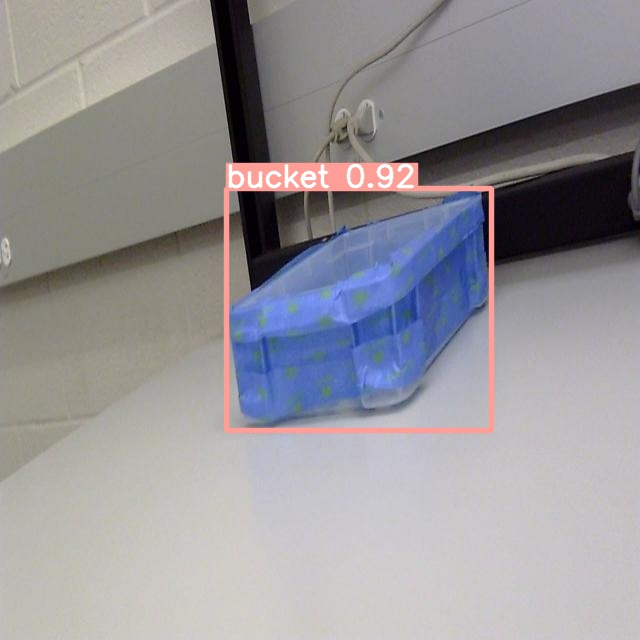
Object Dection and Gripper Arm/Object Detection/Source code/runs/detect/predict/WIN_20230304_14_50_45_Pro_jpg.rf.23dc87295125bc182ab2043e64188fb5.jpg
