Ali-Helmi/modular_robotics/Object Dection and Gripper Arm/Object Detection/Source code/runs/detect/predict/WIN_20230304_14_50_46_Pro-2-_jpg.rf.27153e5619e2f3fd1af93df95ede9793.jpg

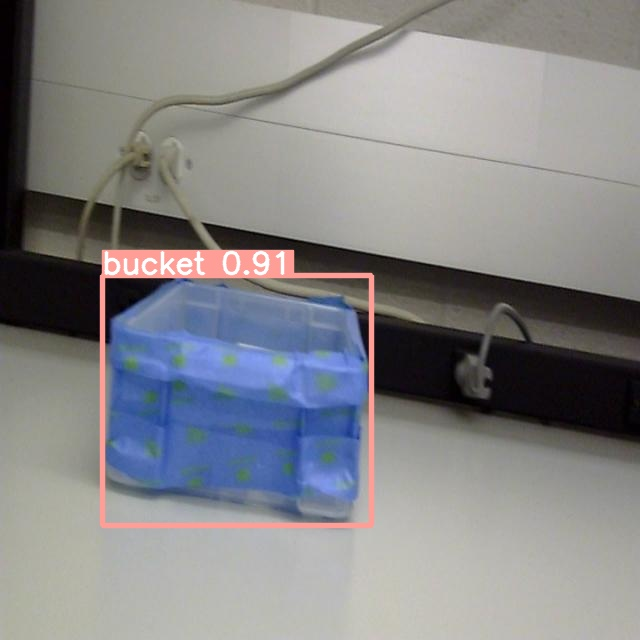
Object Dection and Gripper Arm/Object Detection/Source code/runs/detect/predict/WIN_20230304_14_50_46_Pro-2-_jpg.rf.27153e5619e2f3fd1af93df95ede9793.jpg
