Ali-Helmi/modular_robotics/Object Dection and Gripper Arm/Object Detection/Source code/runs/detect/predict/WIN_20230304_14_50_46_Pro_jpg.rf.c90e38a504a9fdafb1ed77ed8815e068.jpg

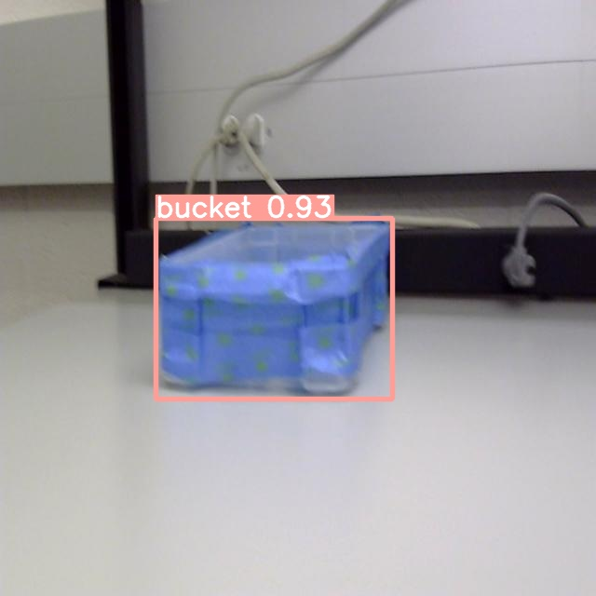
Object Dection and Gripper Arm/Object Detection/Source code/runs/detect/predict/WIN_20230304_14_50_46_Pro_jpg.rf.c90e38a504a9fdafb1ed77ed8815e068.jpg
