Ali-Helmi/modular_robotics/Object Dection and Gripper Arm/Object Detection/Source code/runs/detect/predict/WIN_20230304_14_50_47_Pro_jpg.rf.9416a5dffc4f450edf5274b9861f0588.jpg

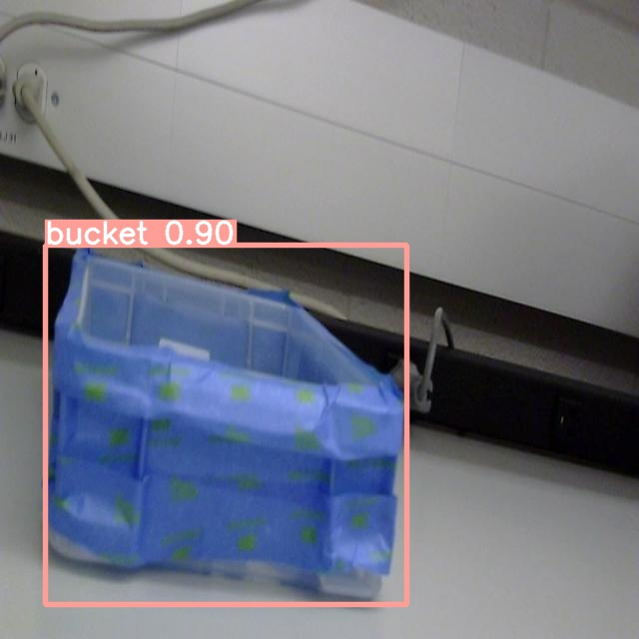
Object Dection and Gripper Arm/Object Detection/Source code/runs/detect/predict/WIN_20230304_14_50_47_Pro_jpg.rf.9416a5dffc4f450edf5274b9861f0588.jpg
