Ali-Helmi/modular_robotics/Object Dection and Gripper Arm/Object Detection/Source code/runs/detect/predict/WIN_20230304_14_50_48_Pro_jpg.rf.e64daf97d30a1989b59c99386fb38a5f.jpg

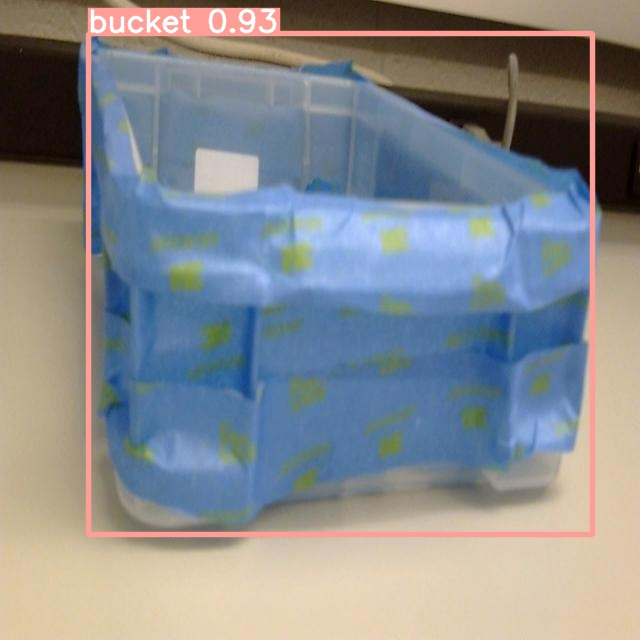
Object Dection and Gripper Arm/Object Detection/Source code/runs/detect/predict/WIN_20230304_14_50_48_Pro_jpg.rf.e64daf97d30a1989b59c99386fb38a5f.jpg
