Ali-Helmi/modular_robotics/Object Dection and Gripper Arm/Object Detection/Source code/runs/detect/predict/WIN_20230304_14_50_51_Pro-2-_jpg.rf.5e972d1a8dda2a70b71fd29fd04881ba.jpg

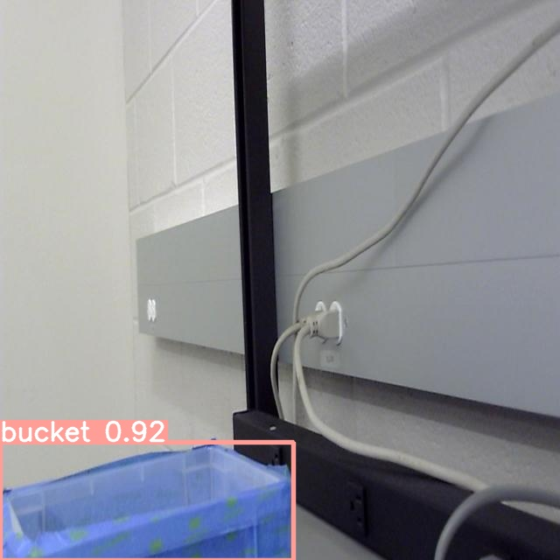
Object Dection and Gripper Arm/Object Detection/Source code/runs/detect/predict/WIN_20230304_14_50_51_Pro-2-_jpg.rf.5e972d1a8dda2a70b71fd29fd04881ba.jpg
