Ali-Helmi/modular_robotics/Object Dection and Gripper Arm/Object Detection/Source code/runs/detect/predict/WIN_20230304_14_50_51_Pro_jpg.rf.089749e0bd3564f1beddbca2eb53f6b8.jpg

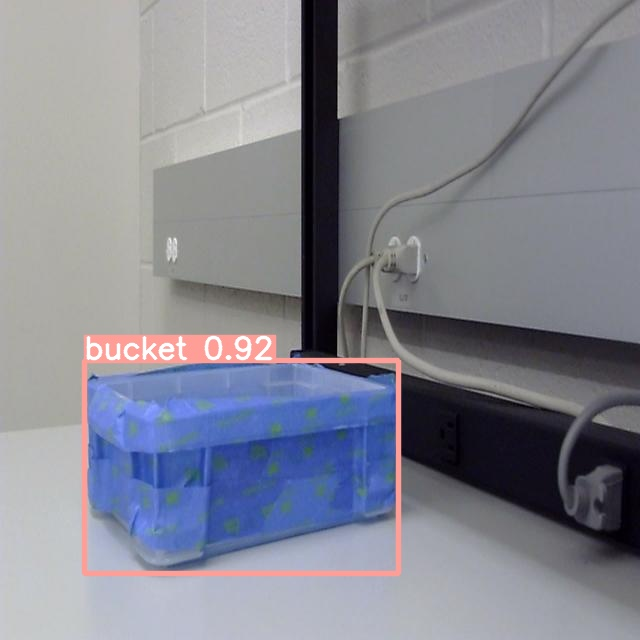
Object Dection and Gripper Arm/Object Detection/Source code/runs/detect/predict/WIN_20230304_14_50_51_Pro_jpg.rf.089749e0bd3564f1beddbca2eb53f6b8.jpg
