Ali-Helmi/modular_robotics/Object Dection and Gripper Arm/Object Detection/Source code/runs/detect/predict/WIN_20230304_14_50_52_Pro_jpg.rf.067c38406bfc157b3edb44f614e65a5d.jpg

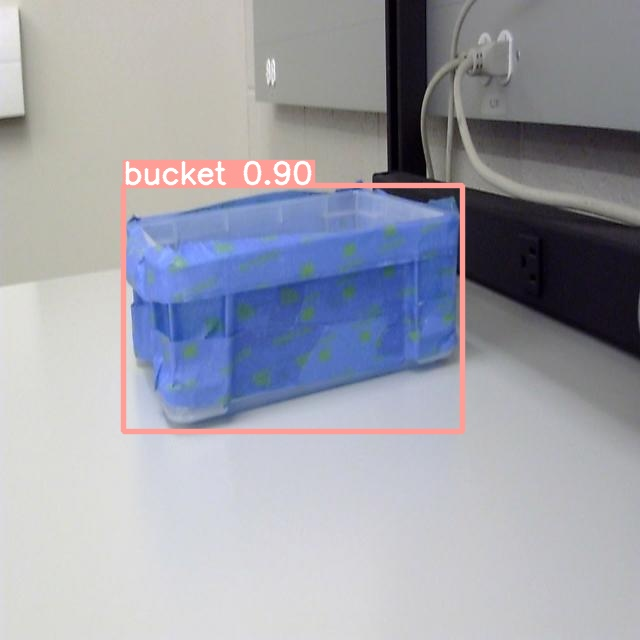
Object Dection and Gripper Arm/Object Detection/Source code/runs/detect/predict/WIN_20230304_14_50_52_Pro_jpg.rf.067c38406bfc157b3edb44f614e65a5d.jpg
