Ali-Helmi/modular_robotics/Object Dection and Gripper Arm/Object Detection/Source code/runs/detect/predict/WIN_20230304_14_50_54_Pro_jpg.rf.d38a35146651cad1727862090110514c.jpg

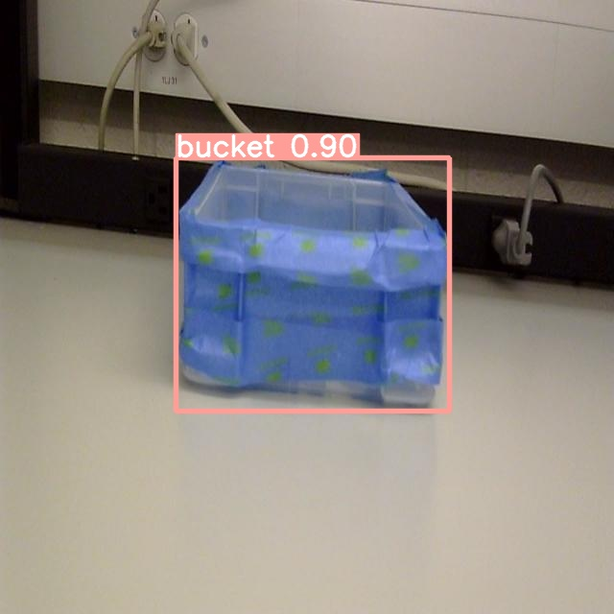
Object Dection and Gripper Arm/Object Detection/Source code/runs/detect/predict/WIN_20230304_14_50_54_Pro_jpg.rf.d38a35146651cad1727862090110514c.jpg
