Ali-Helmi/modular_robotics/Object Dection and Gripper Arm/Object Detection/Source code/runs/detect/predict/WIN_20230304_14_50_56_Pro_jpg.rf.a25fbbdae41269cb478e603d56d31d81.jpg

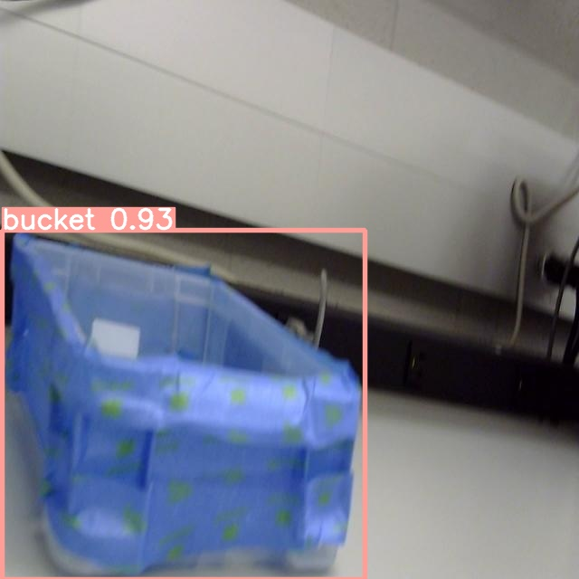
Object Dection and Gripper Arm/Object Detection/Source code/runs/detect/predict/WIN_20230304_14_50_56_Pro_jpg.rf.a25fbbdae41269cb478e603d56d31d81.jpg
