Ali-Helmi/modular_robotics/Object Dection and Gripper Arm/Object Detection/Source code/runs/detect/predict/WIN_20230304_14_50_59_Pro_jpg.rf.bed2e0aa6b5c92ac552ff30c7807680e.jpg

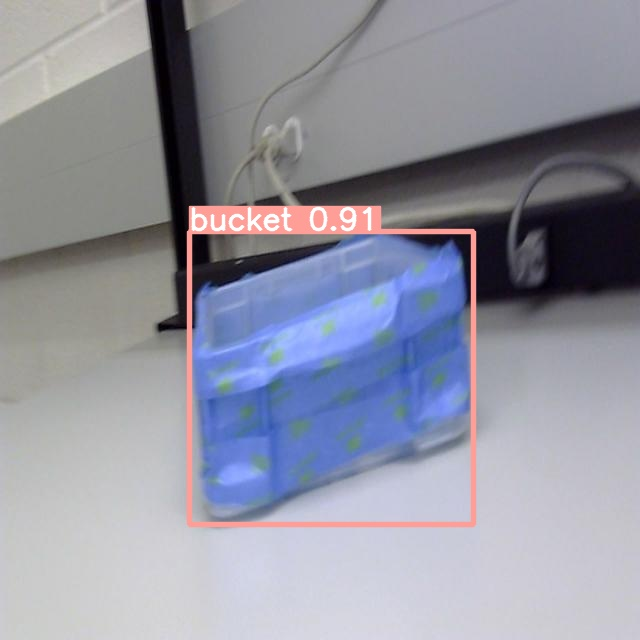
Object Dection and Gripper Arm/Object Detection/Source code/runs/detect/predict/WIN_20230304_14_50_59_Pro_jpg.rf.bed2e0aa6b5c92ac552ff30c7807680e.jpg
