Ali-Helmi/modular_robotics/Object Dection and Gripper Arm/Object Detection/Source code/runs/detect/predict/WIN_20230304_14_51_04_Pro_jpg.rf.484fcf9cd0090fd1f684bb5f7b9dbae7.jpg

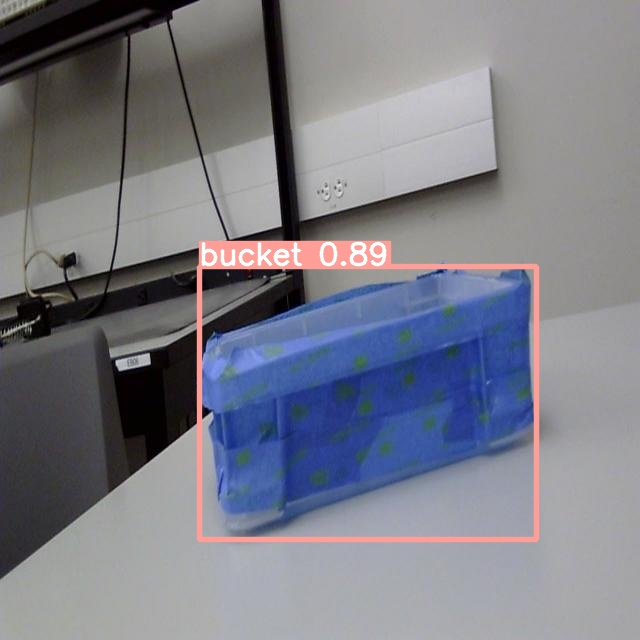
Object Dection and Gripper Arm/Object Detection/Source code/runs/detect/predict/WIN_20230304_14_51_04_Pro_jpg.rf.484fcf9cd0090fd1f684bb5f7b9dbae7.jpg
