Ali-Helmi/modular_robotics/Object Dection and Gripper Arm/Object Detection/Source code/runs/detect/predict/WIN_20230304_14_51_05_Pro_jpg.rf.13d2440fda69e880376c0fc933b681ee.jpg

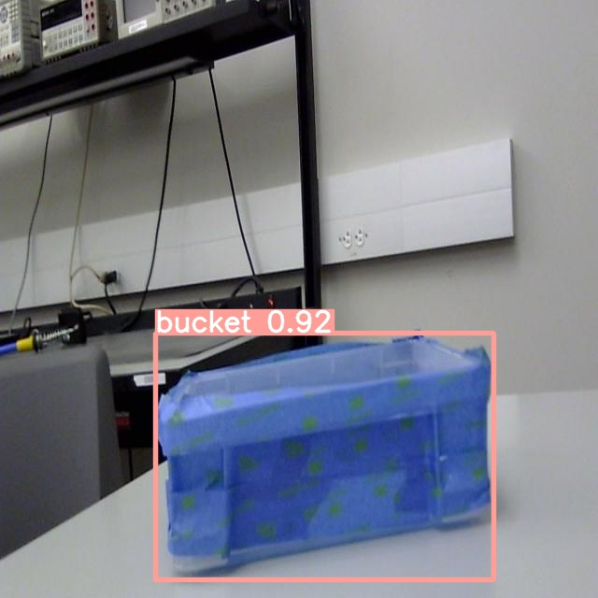
Object Dection and Gripper Arm/Object Detection/Source code/runs/detect/predict/WIN_20230304_14_51_05_Pro_jpg.rf.13d2440fda69e880376c0fc933b681ee.jpg
