Ali-Helmi/modular_robotics/Object Dection and Gripper Arm/Object Detection/Source code/runs/detect/predict/WIN_20230304_14_51_06_Pro_jpg.rf.55ef005098517ca531d754c86c704386.jpg

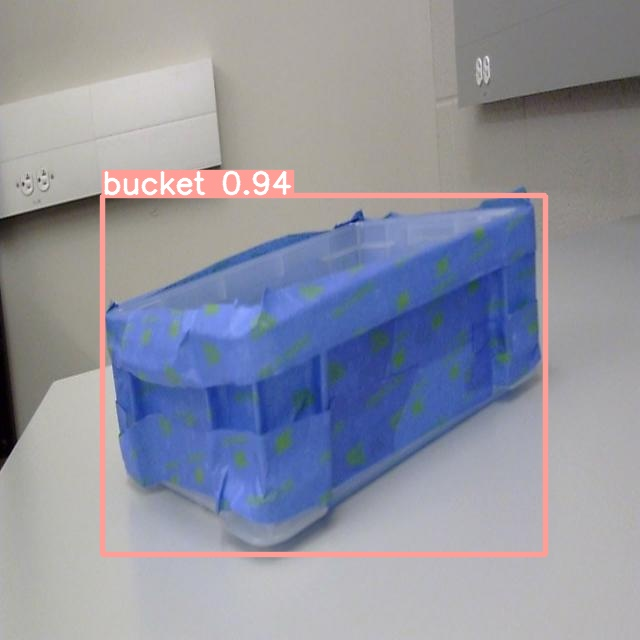
Object Dection and Gripper Arm/Object Detection/Source code/runs/detect/predict/WIN_20230304_14_51_06_Pro_jpg.rf.55ef005098517ca531d754c86c704386.jpg
