Ali-Helmi/modular_robotics/Object Dection and Gripper Arm/Object Detection/Source code/runs/detect/predict/WIN_20230304_14_51_11_Pro_jpg.rf.2d5738055debc72ea414fdf6dfa9c92c.jpg

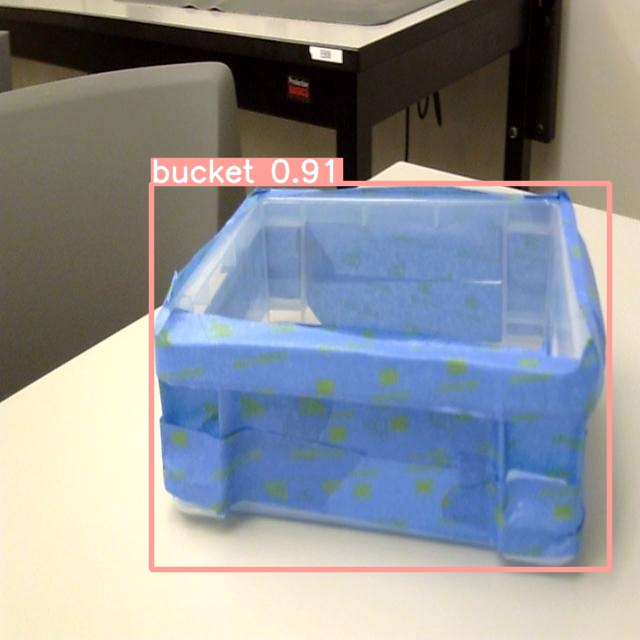
Object Dection and Gripper Arm/Object Detection/Source code/runs/detect/predict/WIN_20230304_14_51_11_Pro_jpg.rf.2d5738055debc72ea414fdf6dfa9c92c.jpg
