Ali-Helmi/modular_robotics/Object Dection and Gripper Arm/Object Detection/Source code/runs/detect/predict/WIN_20230304_14_51_12_Pro_jpg.rf.9b93b2f096cc6a054490694497bbdf46.jpg

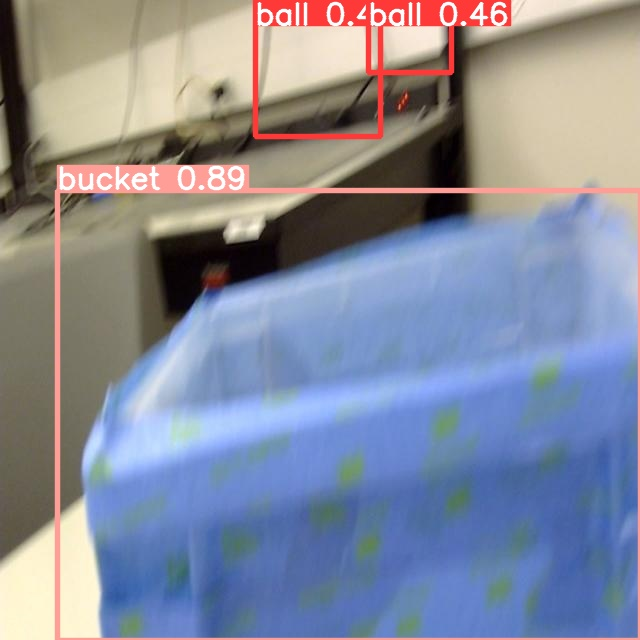
Object Dection and Gripper Arm/Object Detection/Source code/runs/detect/predict/WIN_20230304_14_51_12_Pro_jpg.rf.9b93b2f096cc6a054490694497bbdf46.jpg
