Ali-Helmi/modular_robotics/Object Dection and Gripper Arm/Object Detection/Source code/runs/detect/predict/WIN_20230304_14_51_13_Pro-2-_jpg.rf.9639a4fb6eb4e90fe22ed04a10e6d23c.jpg

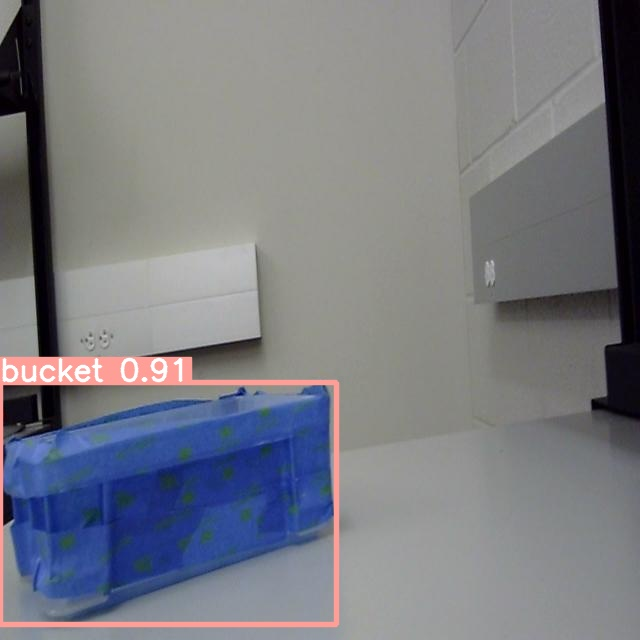
Object Dection and Gripper Arm/Object Detection/Source code/runs/detect/predict/WIN_20230304_14_51_13_Pro-2-_jpg.rf.9639a4fb6eb4e90fe22ed04a10e6d23c.jpg
