Ali-Helmi/modular_robotics/Object Dection and Gripper Arm/Object Detection/Source code/runs/detect/predict/WIN_20230304_14_51_13_Pro_jpg.rf.b78b5f2b6353e6c0942bfe03882525be.jpg

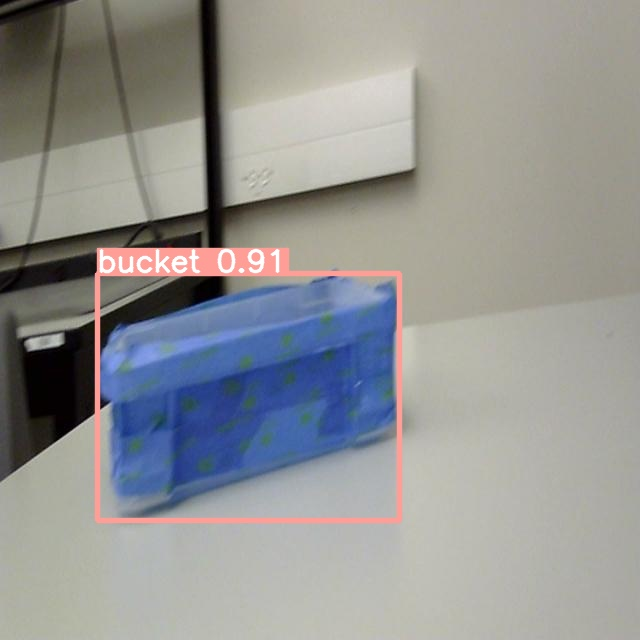
Object Dection and Gripper Arm/Object Detection/Source code/runs/detect/predict/WIN_20230304_14_51_13_Pro_jpg.rf.b78b5f2b6353e6c0942bfe03882525be.jpg
