Ali-Helmi/modular_robotics/Object Dection and Gripper Arm/Object Detection/Source code/runs/detect/predict/WIN_20230304_14_51_14_Pro_jpg.rf.8c1f737b995101a9d8b7be412720f081.jpg

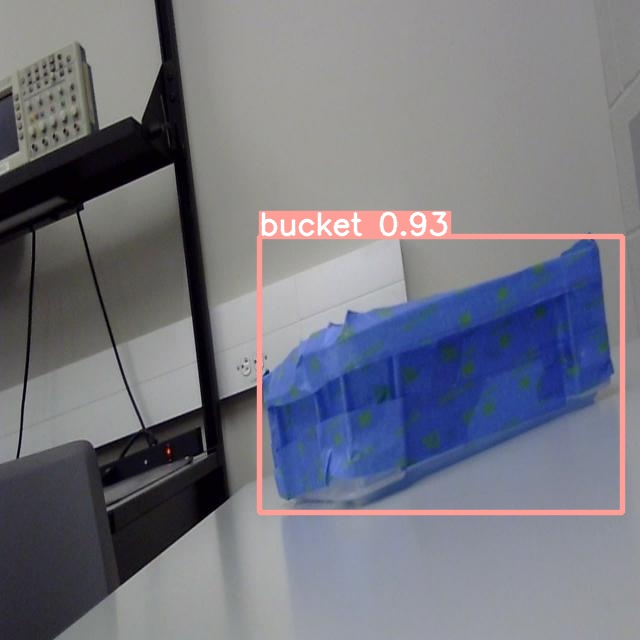
Object Dection and Gripper Arm/Object Detection/Source code/runs/detect/predict/WIN_20230304_14_51_14_Pro_jpg.rf.8c1f737b995101a9d8b7be412720f081.jpg
