Ali-Helmi/modular_robotics/Object Dection and Gripper Arm/Object Detection/Source code/runs/detect/predict/WIN_20230304_14_51_16_Pro_jpg.rf.3060ec14e3a90934a7ca118c1c85bc05.jpg

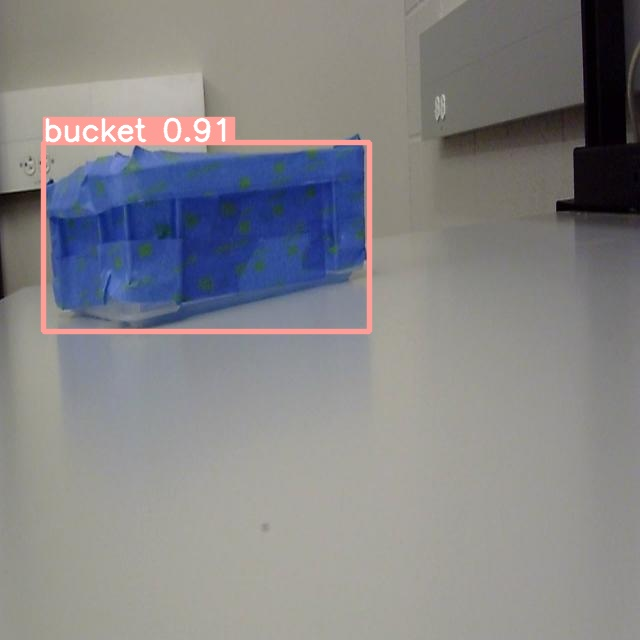
Object Dection and Gripper Arm/Object Detection/Source code/runs/detect/predict/WIN_20230304_14_51_16_Pro_jpg.rf.3060ec14e3a90934a7ca118c1c85bc05.jpg
