Ali-Helmi/modular_robotics/Object Dection and Gripper Arm/Object Detection/Source code/runs/detect/predict/WIN_20230304_14_51_17_Pro_jpg.rf.87295b0f7141c8269c4e92231b3a136e.jpg

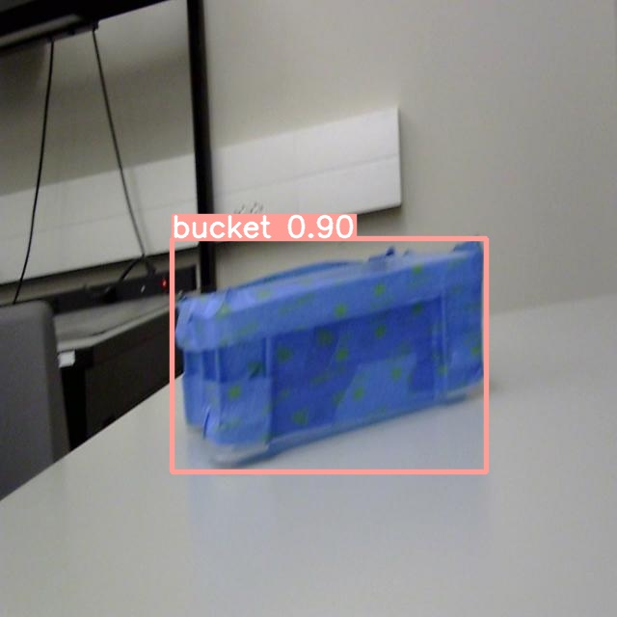
Object Dection and Gripper Arm/Object Detection/Source code/runs/detect/predict/WIN_20230304_14_51_17_Pro_jpg.rf.87295b0f7141c8269c4e92231b3a136e.jpg
