Ali-Helmi/modular_robotics/Object Dection and Gripper Arm/Object Detection/Source code/runs/detect/predict/WIN_20230304_14_51_21_Pro_jpg.rf.5d2accc293bc4f0e43e0a718197ab884.jpg

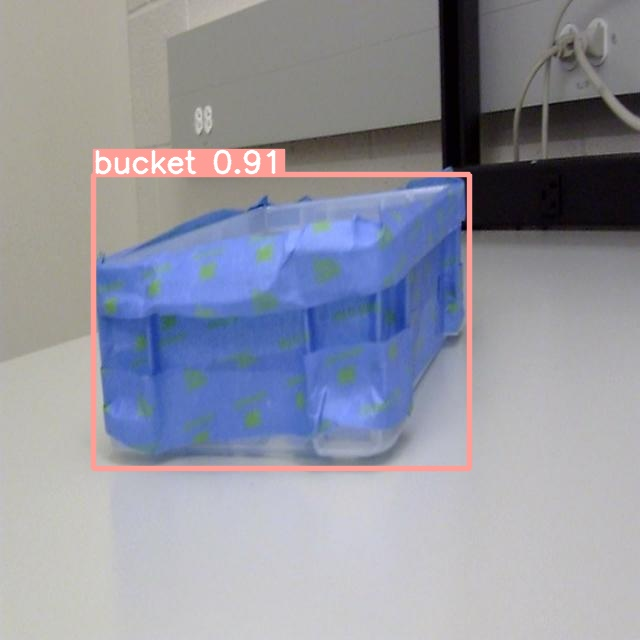
Object Dection and Gripper Arm/Object Detection/Source code/runs/detect/predict/WIN_20230304_14_51_21_Pro_jpg.rf.5d2accc293bc4f0e43e0a718197ab884.jpg
