Ali-Helmi/modular_robotics/Object Dection and Gripper Arm/Object Detection/Source code/runs/detect/predict/WIN_20230304_14_51_23_Pro_jpg.rf.b7637abd5c1cf59ae2d9dddaa4c57533.jpg

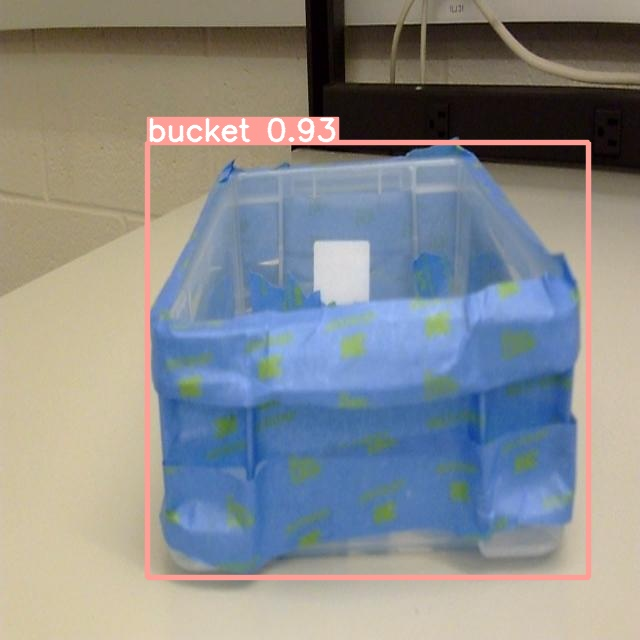
Object Dection and Gripper Arm/Object Detection/Source code/runs/detect/predict/WIN_20230304_14_51_23_Pro_jpg.rf.b7637abd5c1cf59ae2d9dddaa4c57533.jpg
