Ali-Helmi/modular_robotics/Object Dection and Gripper Arm/Object Detection/Source code/runs/detect/predict/WIN_20230304_14_51_26_Pro_jpg.rf.84c8f2db9bd754e3b1a219d4e7607120.jpg

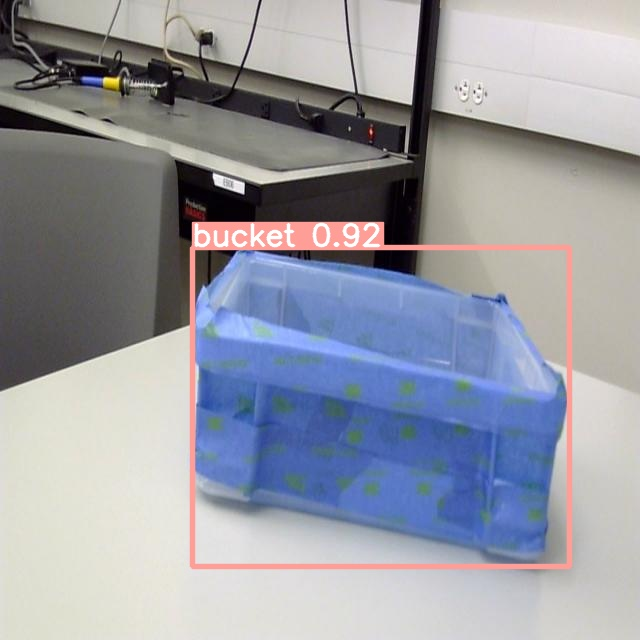
Object Dection and Gripper Arm/Object Detection/Source code/runs/detect/predict/WIN_20230304_14_51_26_Pro_jpg.rf.84c8f2db9bd754e3b1a219d4e7607120.jpg
