Ali-Helmi/modular_robotics/Object Dection and Gripper Arm/Object Detection/Source code/runs/detect/predict/WIN_20230304_14_51_42_Pro_jpg.rf.ecbffa6db7f02541f7effc140a1892e5.jpg

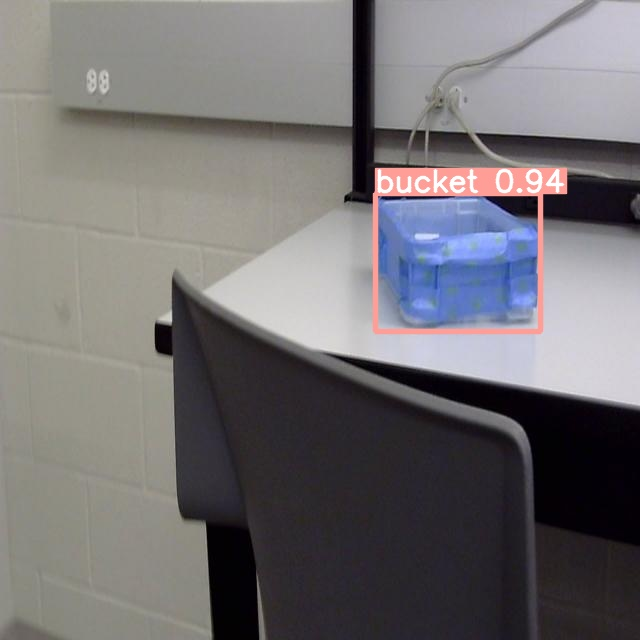
Object Dection and Gripper Arm/Object Detection/Source code/runs/detect/predict/WIN_20230304_14_51_42_Pro_jpg.rf.ecbffa6db7f02541f7effc140a1892e5.jpg
