Ali-Helmi/modular_robotics/Object Dection and Gripper Arm/Object Detection/Source code/runs/detect/predict/WIN_20230304_14_51_45_Pro_jpg.rf.2ce7c3f90950a9e1ec2383a3d6c525b8.jpg

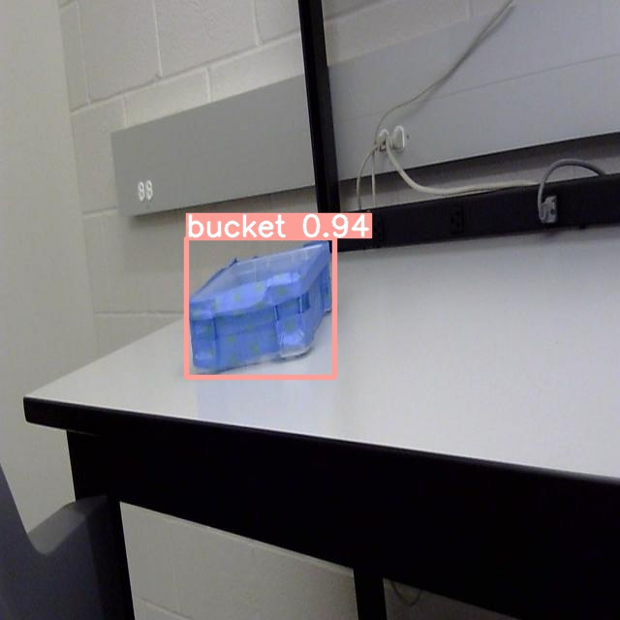
Object Dection and Gripper Arm/Object Detection/Source code/runs/detect/predict/WIN_20230304_14_51_45_Pro_jpg.rf.2ce7c3f90950a9e1ec2383a3d6c525b8.jpg
