Ali-Helmi/modular_robotics/Object Dection and Gripper Arm/Object Detection/Source code/runs/detect/predict/WIN_20230304_14_51_49_Pro_jpg.rf.e4e0c27ca76330e4c49fe71edc6d1e51.jpg

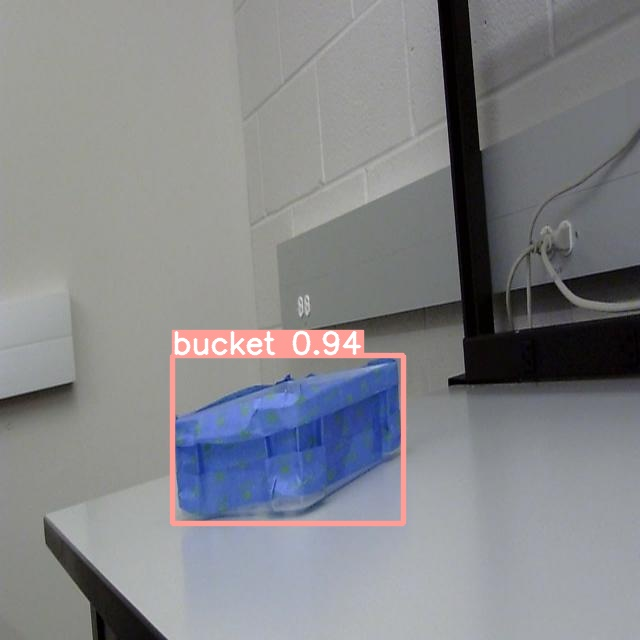
Object Dection and Gripper Arm/Object Detection/Source code/runs/detect/predict/WIN_20230304_14_51_49_Pro_jpg.rf.e4e0c27ca76330e4c49fe71edc6d1e51.jpg
