Ali-Helmi/modular_robotics/Object Dection and Gripper Arm/Object Detection/Source code/runs/detect/predict/WIN_20230304_14_51_57_Pro_jpg.rf.686484c8019d08c37c002e0953aab192.jpg

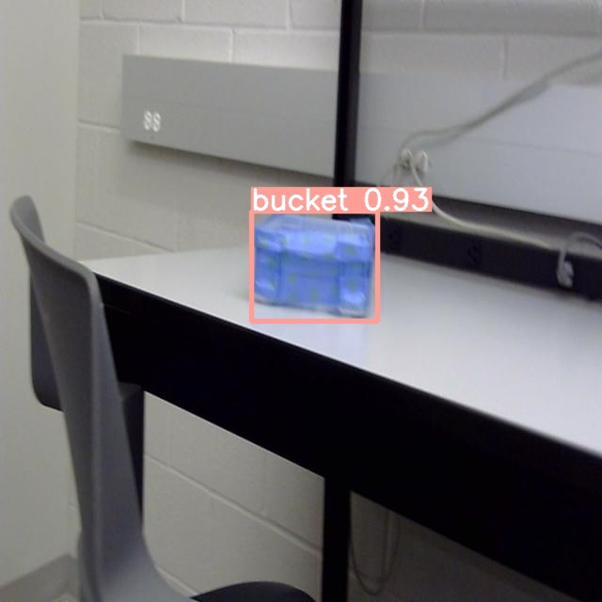
Object Dection and Gripper Arm/Object Detection/Source code/runs/detect/predict/WIN_20230304_14_51_57_Pro_jpg.rf.686484c8019d08c37c002e0953aab192.jpg
