Ali-Helmi/modular_robotics/Object Dection and Gripper Arm/Object Detection/Source code/runs/detect/predict/WIN_20230304_14_51_59_Pro_jpg.rf.b81e44aa5418d643ec2ed28b280370d5.jpg

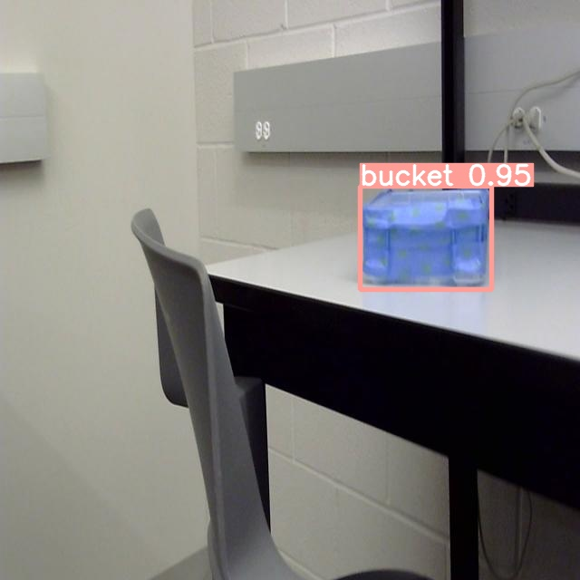
Object Dection and Gripper Arm/Object Detection/Source code/runs/detect/predict/WIN_20230304_14_51_59_Pro_jpg.rf.b81e44aa5418d643ec2ed28b280370d5.jpg
