Ali-Helmi/modular_robotics/Object Dection and Gripper Arm/Object Detection/Source code/runs/detect/predict/WIN_20230304_14_52_00_Pro_jpg.rf.1079a8d32675546552b9df15727734e0.jpg

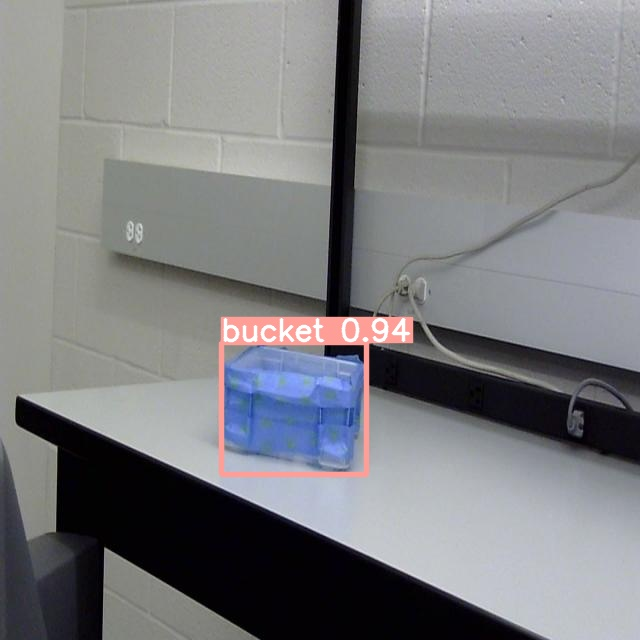
Object Dection and Gripper Arm/Object Detection/Source code/runs/detect/predict/WIN_20230304_14_52_00_Pro_jpg.rf.1079a8d32675546552b9df15727734e0.jpg
