Ali-Helmi/modular_robotics/Object Dection and Gripper Arm/Object Detection/Source code/runs/detect/predict/WIN_20230304_14_52_04_Pro_jpg.rf.b1626bbc921dc58fce38ab2797a1d3d6.jpg

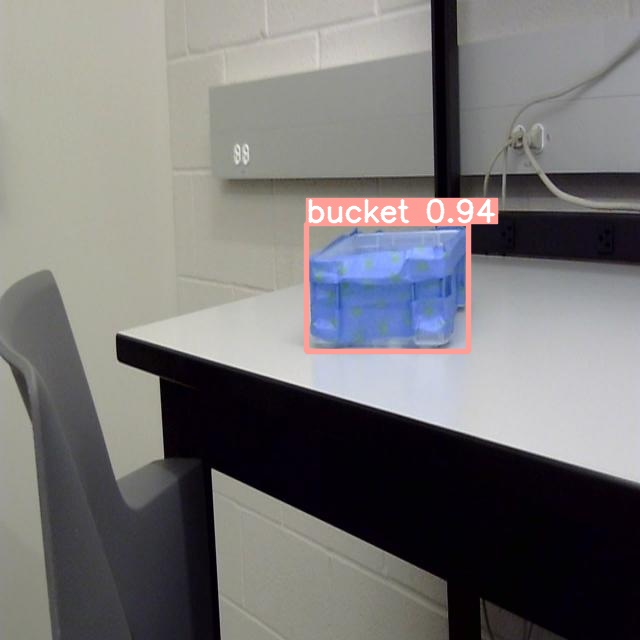
Object Dection and Gripper Arm/Object Detection/Source code/runs/detect/predict/WIN_20230304_14_52_04_Pro_jpg.rf.b1626bbc921dc58fce38ab2797a1d3d6.jpg
