Ali-Helmi/modular_robotics/Object Dection and Gripper Arm/Object Detection/Source code/runs/detect/predict/WIN_20230304_14_52_08_Pro_jpg.rf.198269a35d5d0959bc68ec24829afab5.jpg

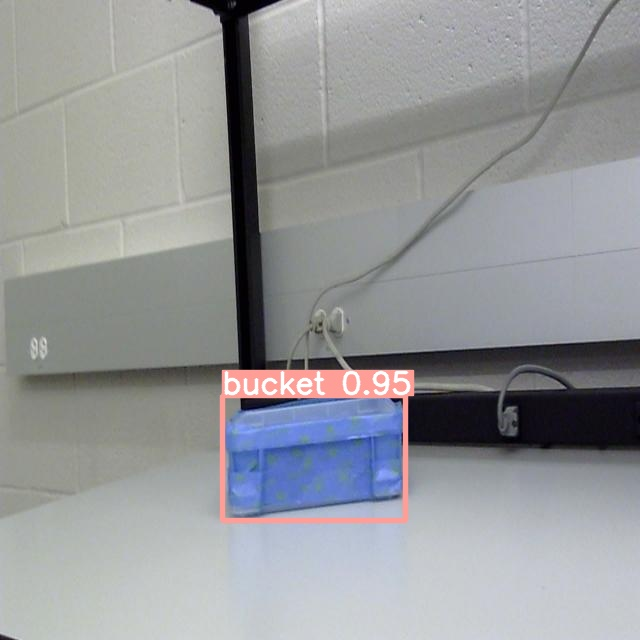
Object Dection and Gripper Arm/Object Detection/Source code/runs/detect/predict/WIN_20230304_14_52_08_Pro_jpg.rf.198269a35d5d0959bc68ec24829afab5.jpg
