Ali-Helmi/modular_robotics/Object Dection and Gripper Arm/Object Detection/Source code/runs/detect/predict/WIN_20230304_14_52_09_Pro_jpg.rf.50c3bdc61ff1386770ecb5da07d10de8.jpg

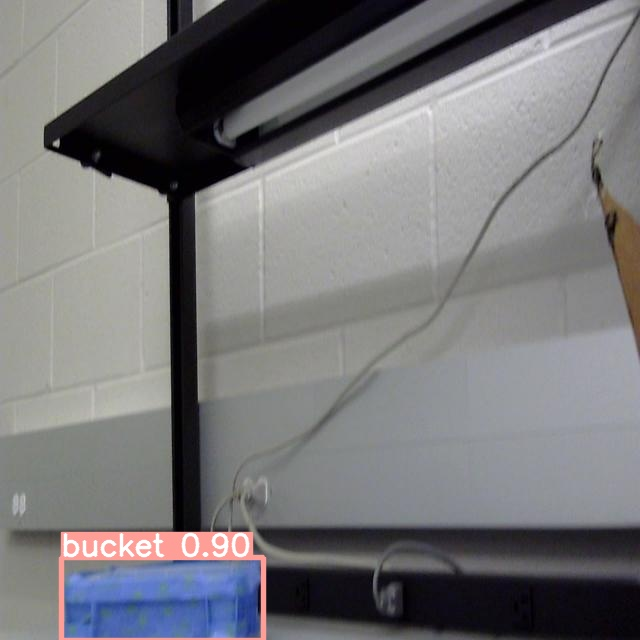
Object Dection and Gripper Arm/Object Detection/Source code/runs/detect/predict/WIN_20230304_14_52_09_Pro_jpg.rf.50c3bdc61ff1386770ecb5da07d10de8.jpg
