Ali-Helmi/modular_robotics/Object Dection and Gripper Arm/Object Detection/Source code/runs/detect/predict/WIN_20230304_14_52_10_Pro_jpg.rf.a37122c0391ecc62509827c08df3d740.jpg

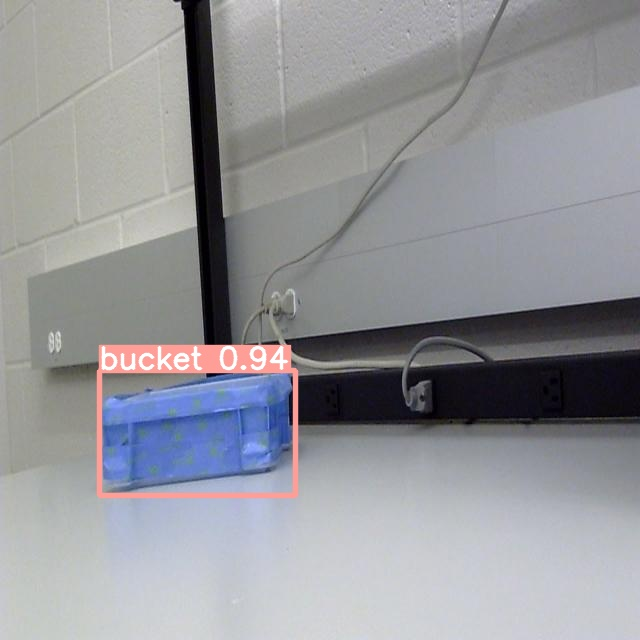
Object Dection and Gripper Arm/Object Detection/Source code/runs/detect/predict/WIN_20230304_14_52_10_Pro_jpg.rf.a37122c0391ecc62509827c08df3d740.jpg
