Ali-Helmi/modular_robotics/Object Dection and Gripper Arm/Object Detection/Source code/runs/detect/predict/WIN_20230304_14_52_11_Pro_jpg.rf.25ea23c9d6e2eaa1c901a7c079dccd47.jpg

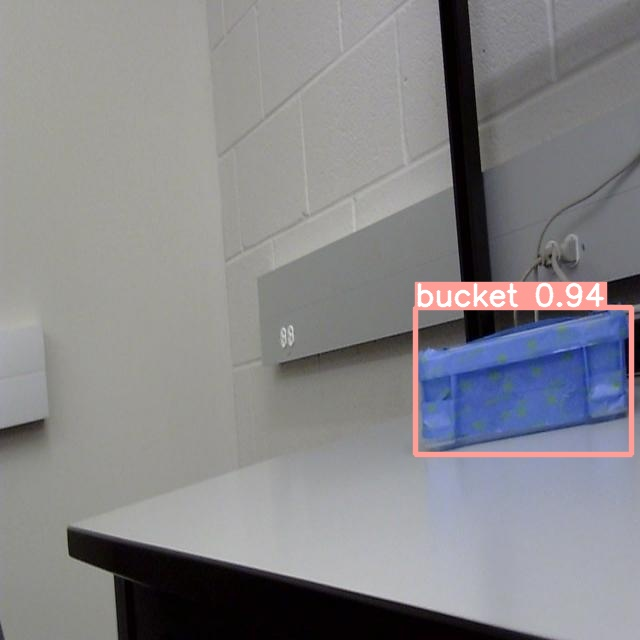
Object Dection and Gripper Arm/Object Detection/Source code/runs/detect/predict/WIN_20230304_14_52_11_Pro_jpg.rf.25ea23c9d6e2eaa1c901a7c079dccd47.jpg
