Ali-Helmi/modular_robotics/Object Dection and Gripper Arm/Object Detection/Source code/runs/detect/predict/WIN_20230304_14_52_12_Pro_jpg.rf.56bfc5e8075484a9d56bedc1758e51d4.jpg

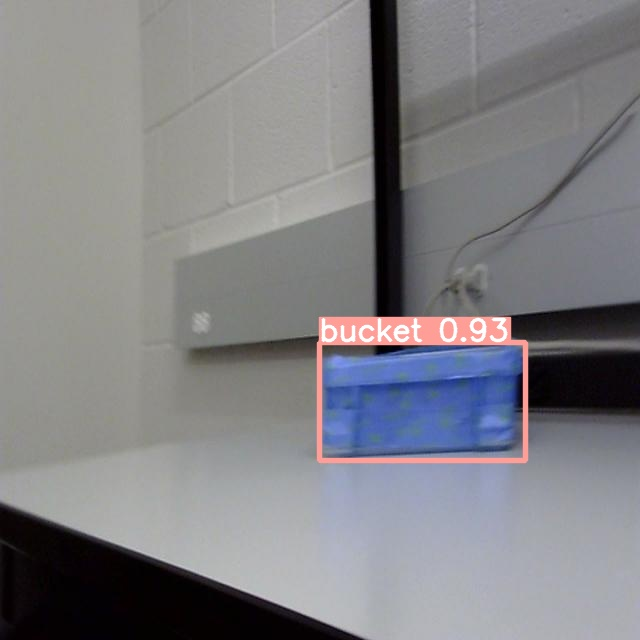
Object Dection and Gripper Arm/Object Detection/Source code/runs/detect/predict/WIN_20230304_14_52_12_Pro_jpg.rf.56bfc5e8075484a9d56bedc1758e51d4.jpg
