Ali-Helmi/modular_robotics/Power and Motor/Buck Converter/bom file (2).xlsx

Qty | Value | Device | Package | Parts | Description
2 | 100nF | CAP_CERAMIC_0603 | _0603 | C20, C26 | Ceramic Capacitors
2 | 100nF 50V | CAP_CERAMIC_0603 | _0603 | C11, C18 | Ceramic Capacitors
2 | 10K | R-US_R0402 | R0402 | R5, R15 | RESISTOR, American symbol
2 | 10TPB330M | 10TPB330M | CAPPM7343X400N | C29, C41 | Panasonic 330uF SMD Solid Polymer Tantalum Capacitor, 10 V +/-20%, POSCAP Series
2 | 10pF | CAP_CERAMIC_0603 | _0603 | C13, C23 | Ceramic Capacitors
2 | 120pF | CAP_CERAMIC_0603 | _0603 | C14, C24 | Ceramic Capacitors
2 | 196k | RESISTOR_0402 | _0402 | R9, R21 | Resistors
2 | 1uF | CAP_CERAMIC_0603 | _0603 | C21, C27 | Ceramic Capacitors
2 | 2.8k | RESISTOR_0603 | _0603 | R7, R19 | Resistors
2 | 270pF | CAP_CERAMIC_0603 | _0603 | C4, C17 | Ceramic Capacitors
2 | 2mOhm | RESISTOR1206 | 1206 | R10, R22 | Resistors
1 | 3.16K | R-US_R0402 | R0402 | R6 | RESISTOR, American symbol
2 | 30.1k | RESISTOR_0603 | _0603 | R4, R18 | Resistors
2 | 33nF | CAP_CERAMIC_0603 | _0603 | C3, C16 | Ceramic Capacitors
2 | 35SVPF82M | 35SVPF82M | 16SVPT560M | C19, C25 | Panasonic 82uF 35 V dc Polymer Aluminium Electrolytic Capacitor E12, OS-CON Series 5000h 8 x 11.9mm
2 | 4.7uF 50V | CAP_CERAMIC_0805 | _0805 | C12, C22 | Ceramic Capacitors
4 | 5.23k | RESISTOR_0402 | _0402 | R3, R8, R17, R20 | Resistors
1 | 5.9K | R-US_R0402 | R0402 | R16 | RESISTOR, American symbol
2 | 86.6k | RESISTOR_0603 | _0603 | R11, R23 | Resistors
2 | 9.76k | RESISTOR_0603 | _0603 | R12, R24 | Resistors
2 | BAS516,115 | DIODESOD-523 | SOD-523 | D1, D3 | Diode
4 | CSD18512Q5B | CSD18512Q5B | TRANS_CSD18512Q5B | Q1, Q2, Q5, Q6 | Check availability
2 | LM5116MHX/NOPB | LM5116MHX/NOPB | SOP65P640X110-21N | U2, U4 | 6-100V Wide Vin, Current Mode Synchronous Buck Controller 20-HTSSOP -40 to 150 Check availability
2 | SRP1270-1R5M | SRP1270-1R5M | SRP12701R5M | L1, L3 | Inductor Power Shielded Wirewound 1.5uH 20% 100KHz Iron 27A 0.0026Ohm DCR T/R
2 | SS54F | SS54F | SODFL4626X130N | D4, D6 | SURFACE MOUNT SCHOTTKY BARRIER RECTIFIER
1 | TB005-762-02BE | TB005-762-02BE | CUI_TB005-762-02BE | J1 | Check availability
1 | TB005-762-04BE | TB005-762-03BE | CUI_TB005-762-03BE | J2
2 | TPS5450DDAR | TPS5450DDAR | CONV_TPS5450DDAR | U3, U6 | 5.5V to 36V Input, 5A, 500kHz Step Down Converter 8-SO PowerPAD -40 to 125 Check prices
6 | UMF105B7103KVHF | C-EUC0402 | C0402 | C15, C28, C30, C39, C40, C42 | CAPACITOR, European symbol
4 | UMK316ABJ475KL8T | C-EUC1206 | C1206 | C9, C10, C37, C38 | CAPACITOR, European symbol
2 | XAL6060-153MEC | XAL6060-153MEC | XAL6060153MEC | L4, L6 | COILCRAFT - XAL6060-153MEC - INDUCTOR, 15UH, 6A, 20%, PWR, 11MHZ
