Ali-Helmi/modular_robotics/Object Dection and Gripper Arm/Gripper Arm/2-22-2023/newArm/arm/hollistic_sketch_double.SLDASM

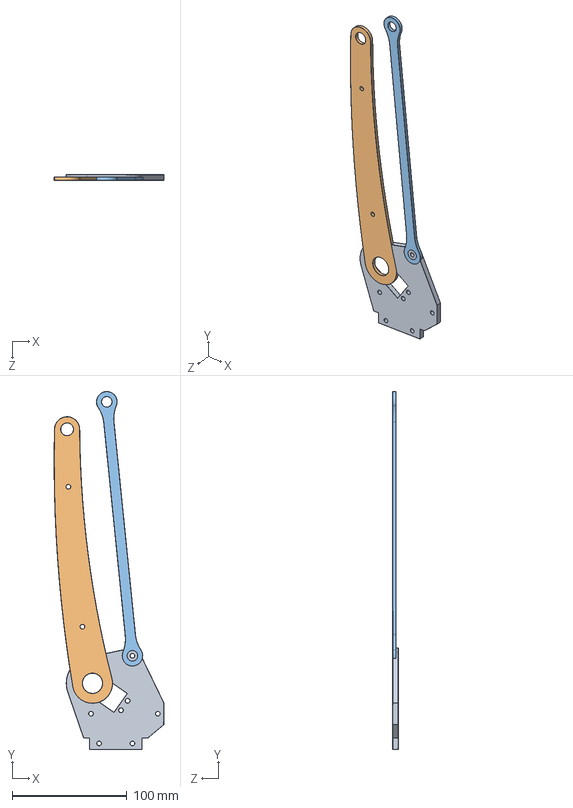
[picture p183: CAD file, 2023-04-12]
Object Dection and Gripper Arm/Gripper Arm/2-22-2023/newArm/arm/hollistic_sketch_double.SLDASM
95.5 x 311.4 x 5.00 mm
boards
leg1
base_leg2
