Ali-Helmi/modular_robotics/Object Dection and Gripper Arm/Gripper Arm/3-20-2023/newArm (1)/newArm/test/Assem1.SLDASM

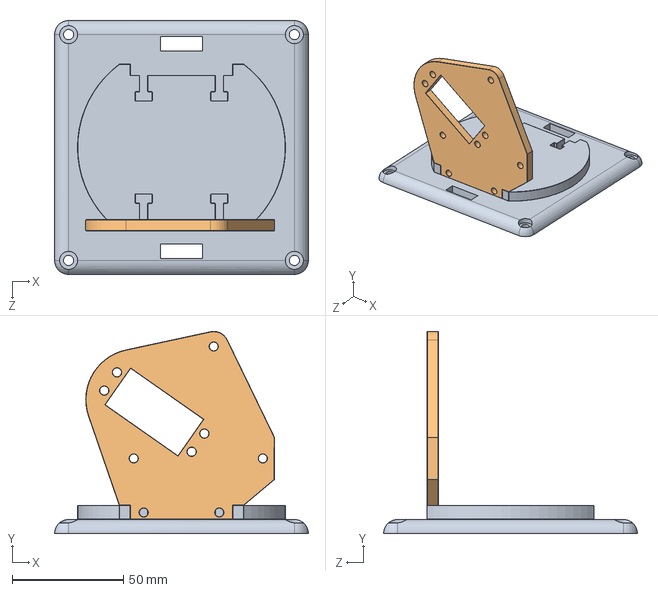
[picture p184: CAD file, 2023-04-12]
Object Dection and Gripper Arm/Gripper Arm/3-20-2023/newArm (1)/newArm/test/Assem1.SLDASM
114.3 x 91.0 x 114.3 mm
modular_base
boards
