Ali-Helmi/modular_robotics/Object Dection and Gripper Arm/Gripper Arm/Stl/mainarm3.stl

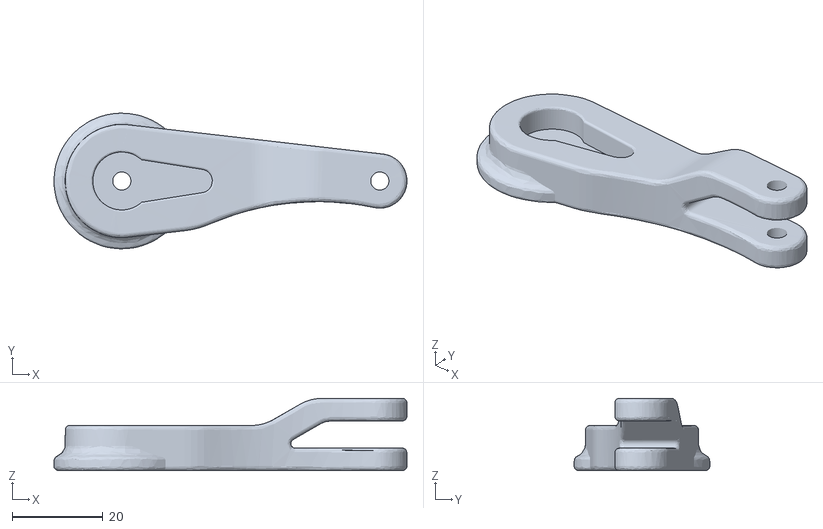
[picture p185: CAD file, 2022-12-05]
Object Dection and Gripper Arm/Gripper Arm/Stl/mainarm3.stl
78.0 x 30.0 x 16.0
