Ali-Helmi/modular_robotics/Object Dection and Gripper Arm/Gripper Arm/3-3-2023/newArm (1)/newArm/arm/hollistic_sketch.SLDASM

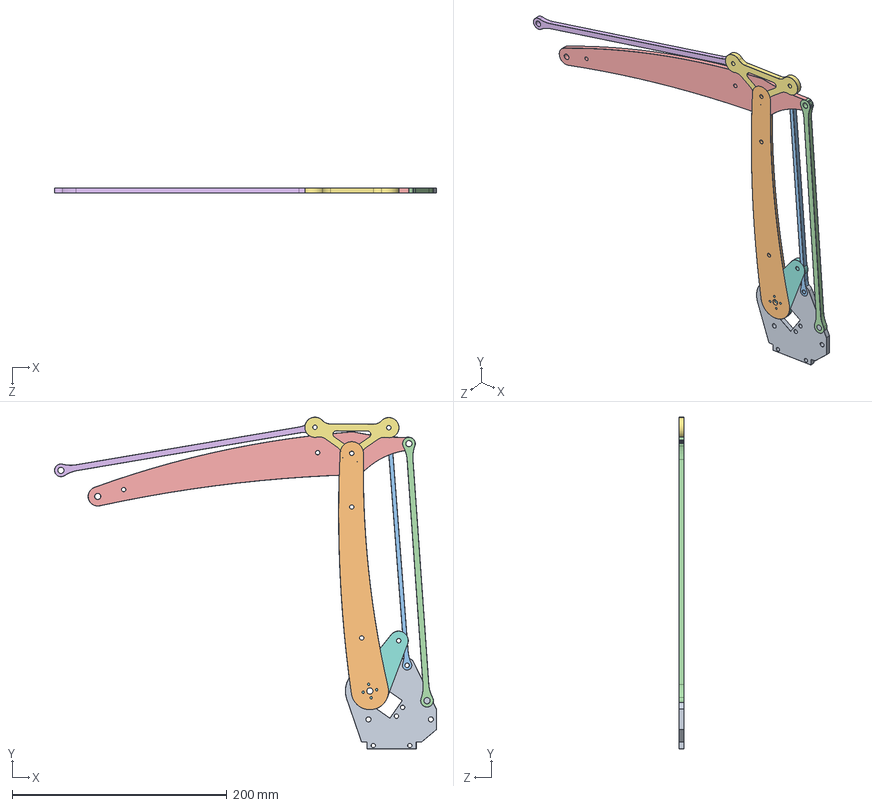
[picture p186: CAD file, 2023-04-12]
Object Dection and Gripper Arm/Gripper Arm/3-3-2023/newArm (1)/newArm/arm/hollistic_sketch.SLDASM
355.8 x 309.1 x 5.00 mm
boards
leg1
base_leg2
base_leg3
extension_leg1
extension_leg2
base_triangle
base_support
