Ali-Helmi/modular_robotics/Object Dection and Gripper Arm/Gripper Arm/Stl/mainbase.stl

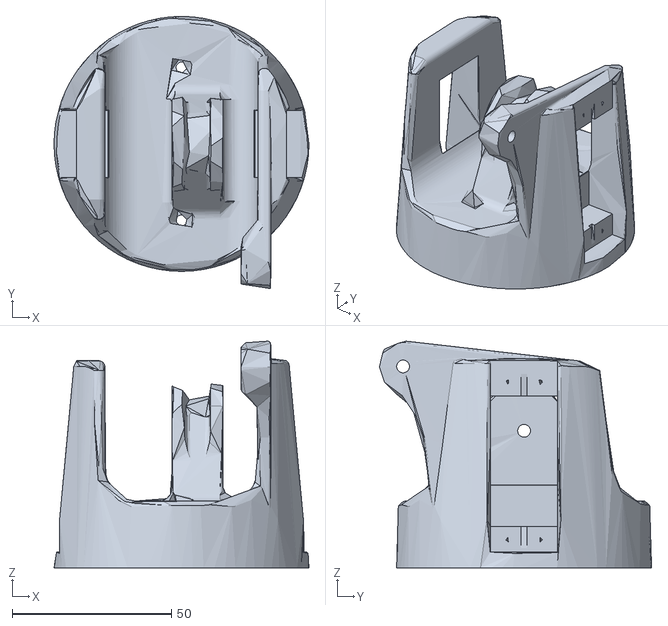
[picture p187: CAD file, 2022-12-05]
Object Dection and Gripper Arm/Gripper Arm/Stl/mainbase.stl
80.0 x 85.4 x 71.1
