Ali-Helmi/modular_robotics/Object Dection and Gripper Arm/Gripper Arm/Stl/mainarm2.stl

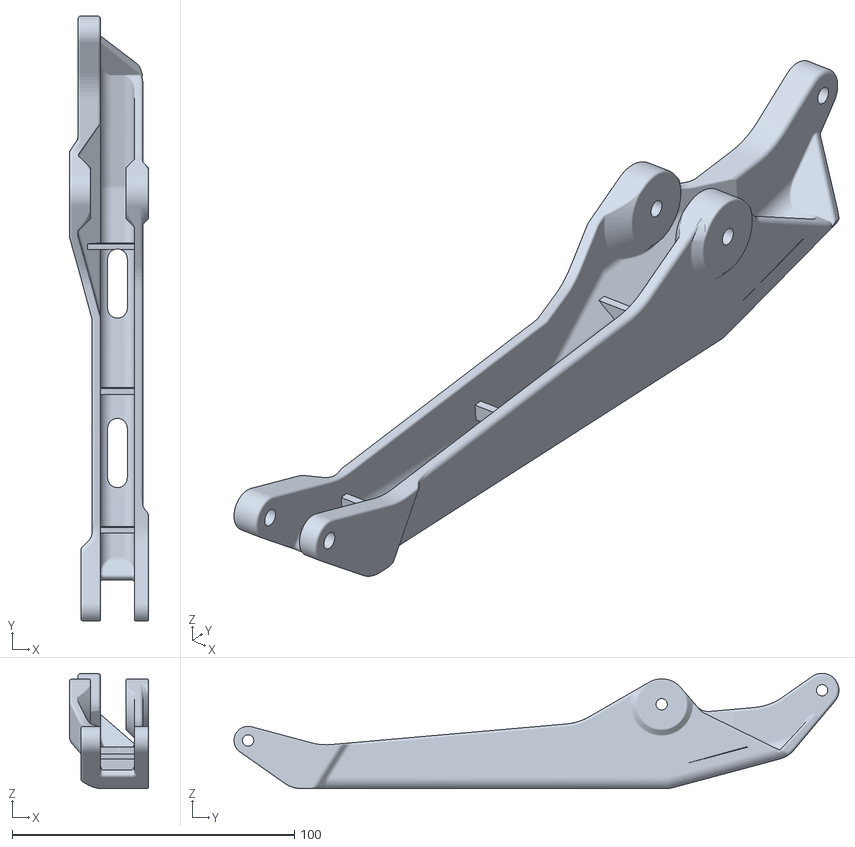
[picture p188: CAD file, 2022-12-05]
Object Dection and Gripper Arm/Gripper Arm/Stl/mainarm2.stl
28.0 x 214.2 x 40.9
