Ali-Helmi/modular_robotics/Object Dection and Gripper Arm/Gripper Arm/3-3-2023/newArm (1)/newArm/arm/hollistic_sketch_double.SLDASM

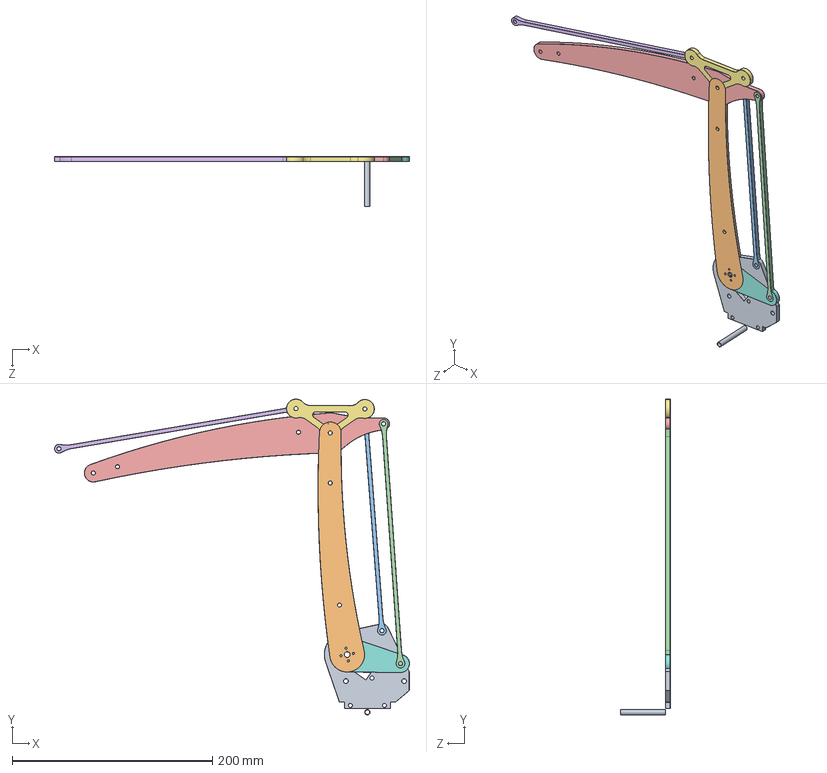
[picture p189: CAD file, 2023-04-12]
Object Dection and Gripper Arm/Gripper Arm/3-3-2023/newArm (1)/newArm/arm/hollistic_sketch_double.SLDASM
354.5 x 315.4 x 49.5 mm
boards
leg1
base_leg2
base_leg3
extension_leg1
extension_leg2
base_triangle
base_support
