Ali-Helmi/modular_robotics/Object Dection and Gripper Arm/Gripper Arm/Stl/mainarm.stl

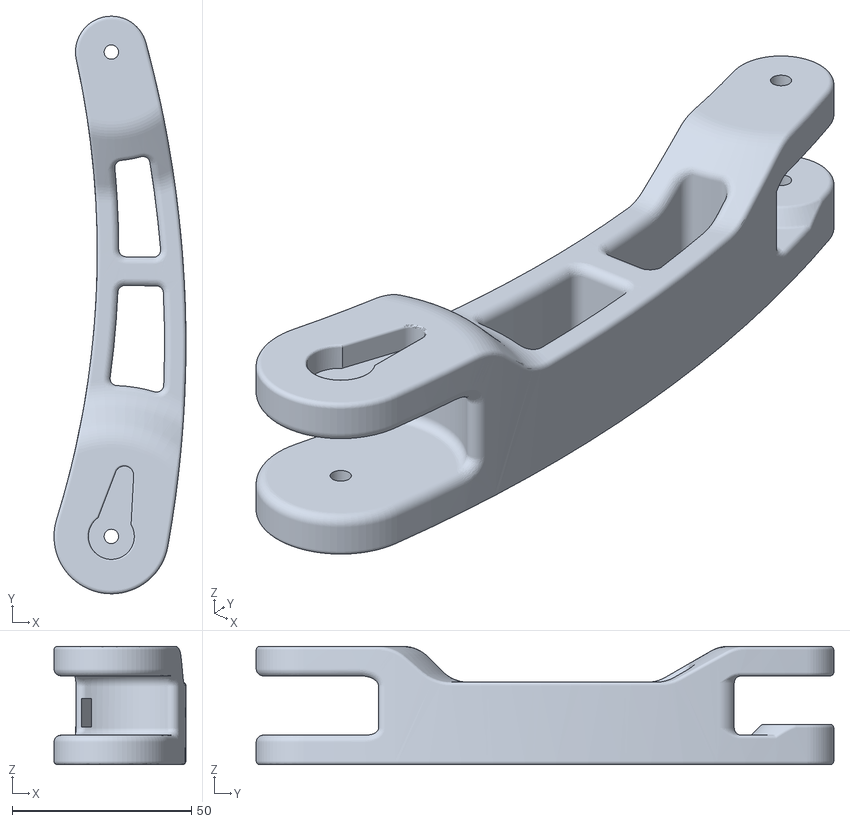
[picture p190: CAD file, 2022-12-05]
Object Dection and Gripper Arm/Gripper Arm/Stl/mainarm.stl
36.8 x 161.0 x 33.0
