Ali-Helmi/modular_robotics/Object Dection and Gripper Arm/Gripper Arm/Stl/gripper_mainarm.stl

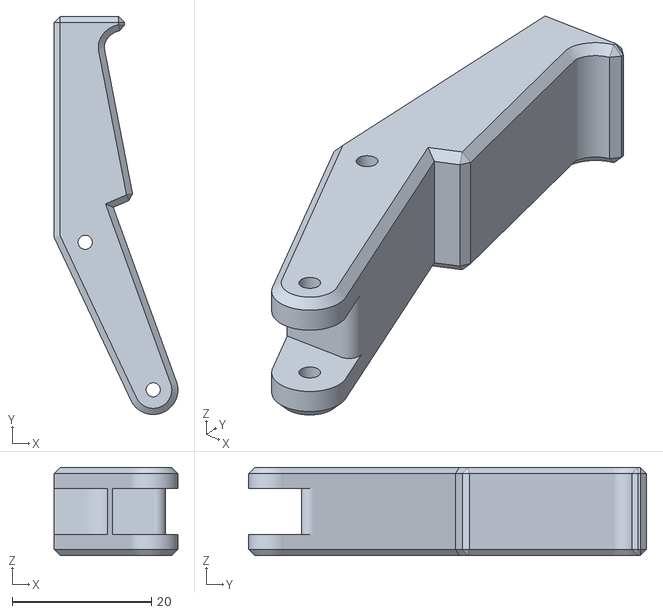
[picture p191: CAD file, 2022-12-05]
Object Dection and Gripper Arm/Gripper Arm/Stl/gripper_mainarm.stl
17.8 x 57.2 x 12.7
