Ali-Helmi/modular_robotics/Object Dection and Gripper Arm/Gripper Arm/Stl/gripper_mainarm_base.stl

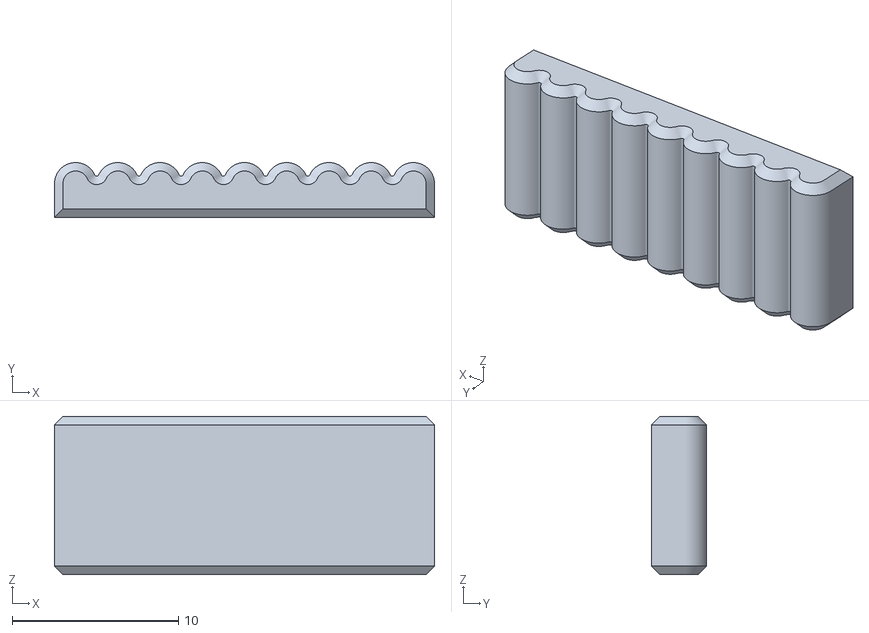
[picture p192: CAD file, 2022-12-05]
Object Dection and Gripper Arm/Gripper Arm/Stl/gripper_mainarm_base.stl
22.9 x 3.30 x 9.53
