Ali-Helmi/modular_robotics/Housing and PCBs/Housing/Controller Module/Controller_Part1.SLDPRT

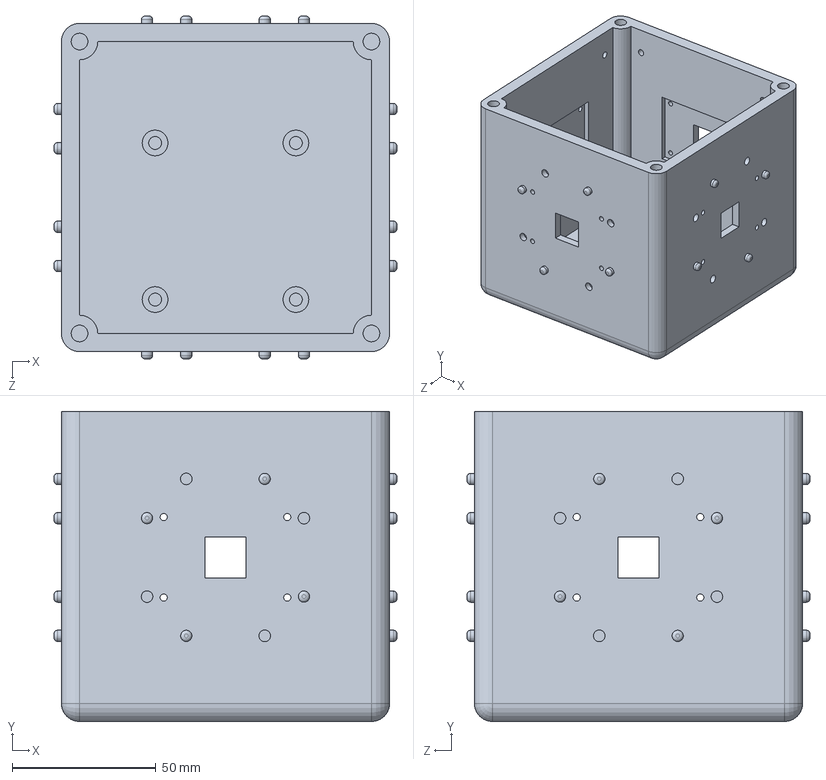
[picture p194: CAD file, 2022-12-05]
Housing and PCBs/Housing/Controller Module/Controller_Part1.SLDPRT
119.4 x 108.0 x 119.4 mm
