Ali-Helmi/modular_robotics/Housing and PCBs/Housing/final_housing_design_404/arm_module/arm_standoffs.SLDPRT

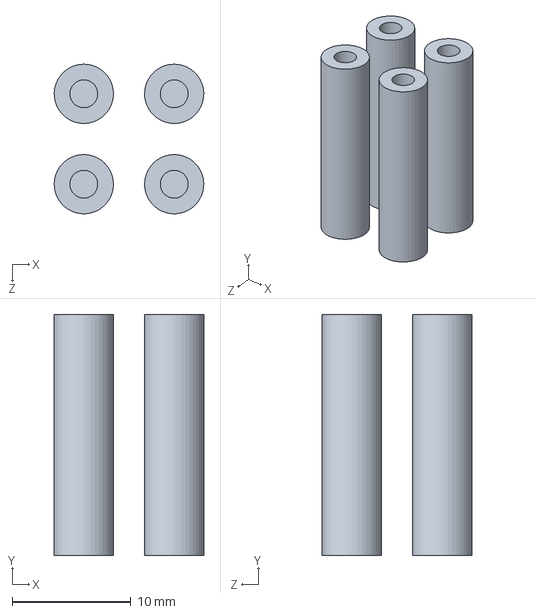
[picture p195: CAD file, 2023-05-02]
Housing and PCBs/Housing/final_housing_design_404/arm_module/arm_standoffs.SLDPRT
12.6 x 20.3 x 12.6 mm
