Ali-Helmi/modular_robotics/Housing and PCBs/Housing/final_housing_design_404/battery_module/connecting_wall_power.SLDPRT

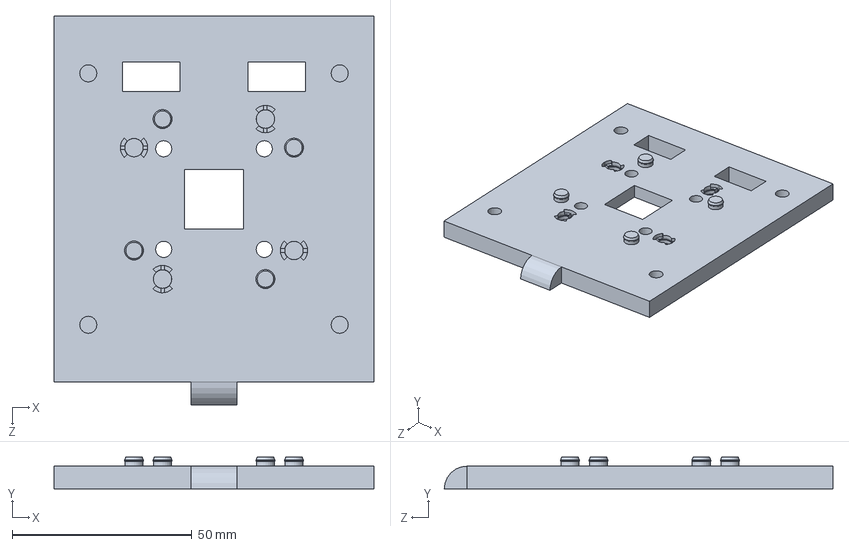
[picture p196: CAD file, 2023-05-02]
Housing and PCBs/Housing/final_housing_design_404/battery_module/connecting_wall_power.SLDPRT
88.9 x 8.89 x 107.9 mm
