Ali-Helmi/modular_robotics/Housing and PCBs/Housing/final_housing_design_404/camera_module/camera_wall.SLDPRT

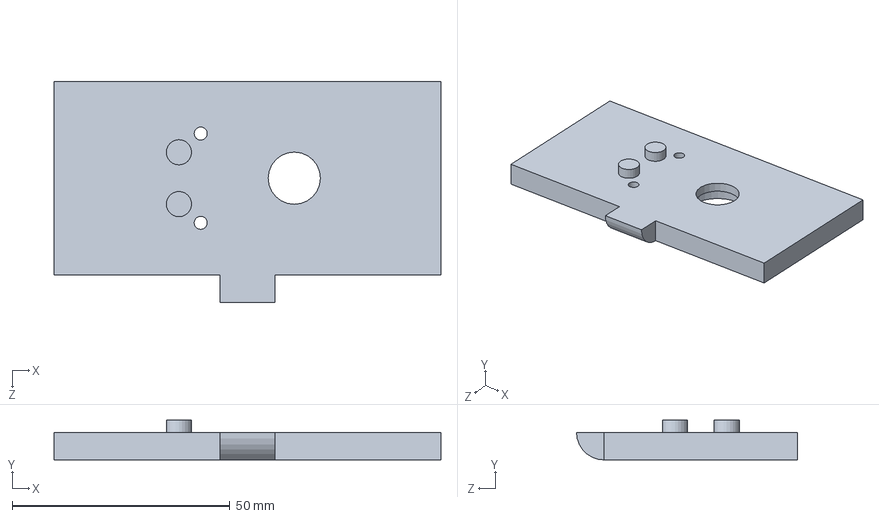
[picture p198: CAD file, 2023-05-02]
Housing and PCBs/Housing/final_housing_design_404/camera_module/camera_wall.SLDPRT
88.9 x 9.15 x 50.8 mm
