Ali-Helmi/modular_robotics/Housing and PCBs/Housing/final_housing_design_404/motor_module/motor_fastener.SLDPRT

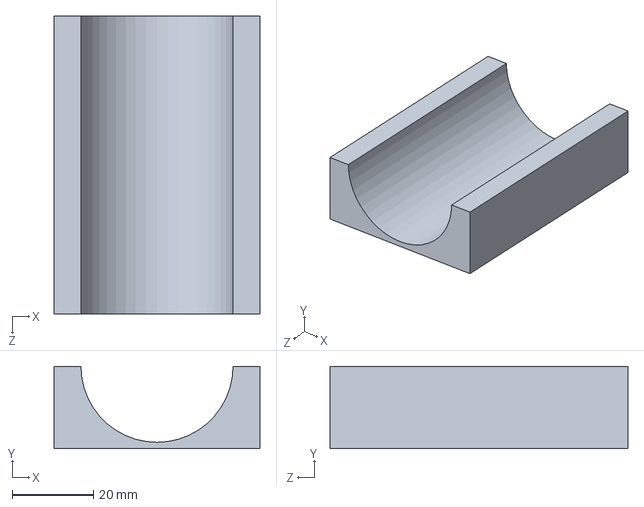
[picture p199: CAD file, 2023-05-02]
Housing and PCBs/Housing/final_housing_design_404/motor_module/motor_fastener.SLDPRT
50.8 x 20.3 x 73.4 mm
