Ali-Helmi/modular_robotics/Housing and PCBs/Housing/final_housing_design_404/sensor_module/sensor_base.SLDPRT

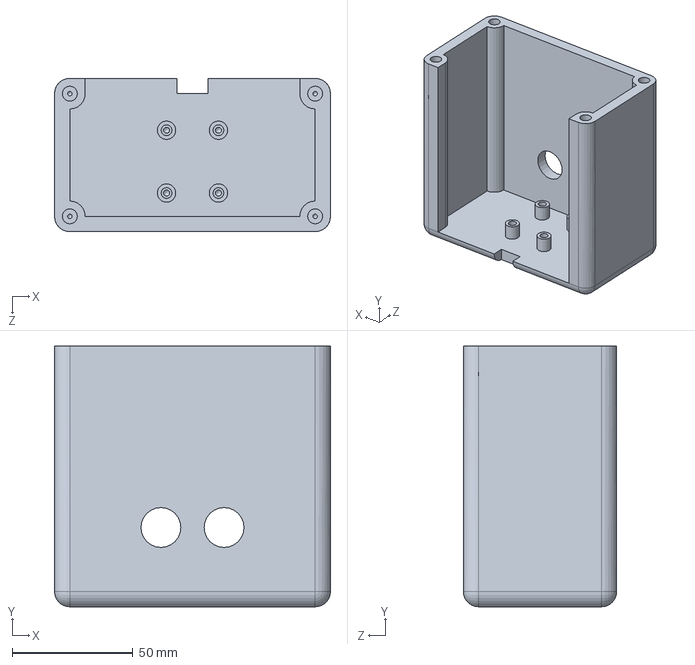
[picture p200: CAD file, 2023-05-02]
Housing and PCBs/Housing/final_housing_design_404/sensor_module/sensor_base.SLDPRT
114.3 x 108.0 x 63.5 mm
