Ali-Helmi/modular_robotics/Housing and PCBs/Housing/Housing_before_FDM_optimization_404/arm module/arm_Part1_v2.SLDPRT

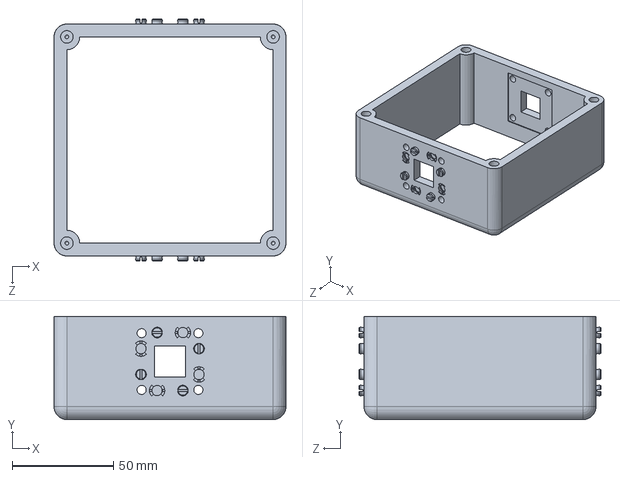
[picture p201: CAD file, 2023-05-02]
Housing and PCBs/Housing/Housing_before_FDM_optimization_404/arm module/arm_Part1_v2.SLDPRT
114.3 x 50.8 x 119.4 mm
