Ali-Helmi/modular_robotics/Housing and PCBs/Housing/Housing_before_FDM_optimization_404/power module/PD_part1.STL

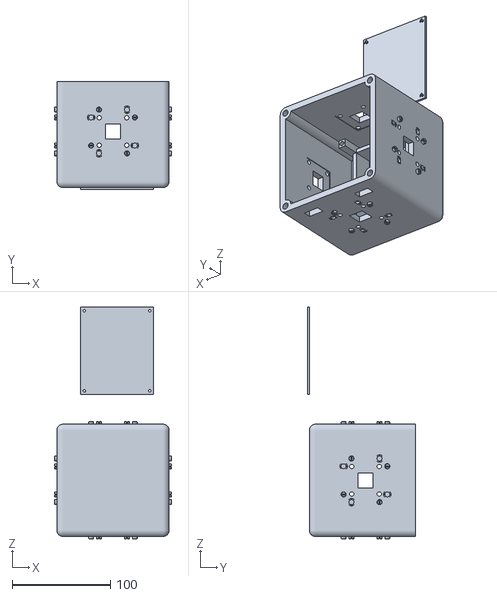
[picture p202: CAD file, 2023-05-02]
Housing and PCBs/Housing/Housing_before_FDM_optimization_404/power module/PD_part1.STL
119.4 x 109.7 x 236.0
