Ali-Helmi/modular_robotics/Housing and PCBs/Housing/Housing_before_FDM_optimization_404/sensor module/sensor_Part2.SLDPRT

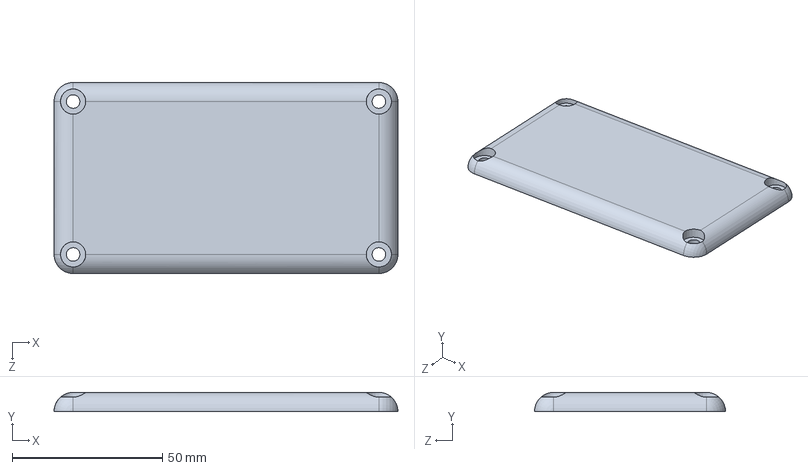
[picture p203: CAD file, 2023-05-02]
Housing and PCBs/Housing/Housing_before_FDM_optimization_404/sensor module/sensor_Part2.SLDPRT
114.3 x 6.35 x 63.5 mm
