Ali-Helmi/modular_robotics/Housing and PCBs/Housing/Motor/Motor_Part2.SLDPRT

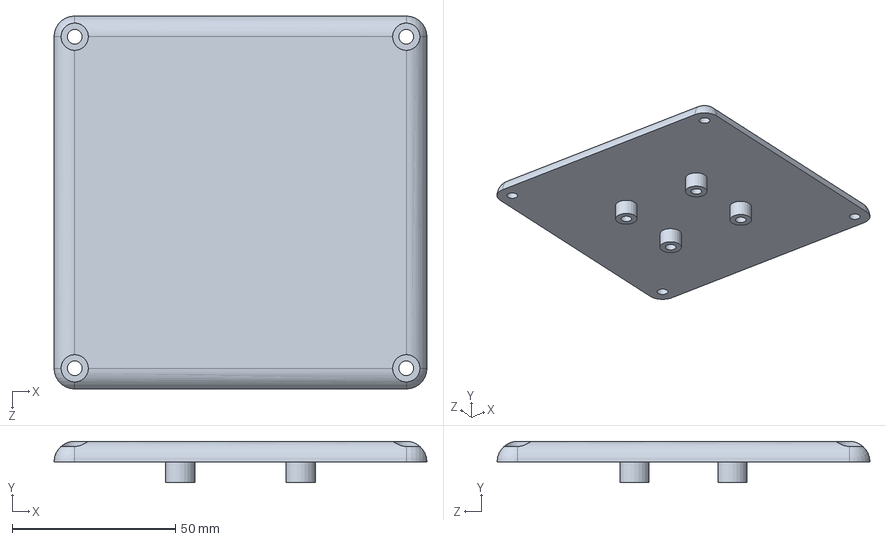
[picture p204: CAD file, 2022-12-05]
Housing and PCBs/Housing/Motor/Motor_Part2.SLDPRT
114.3 x 12.7 x 114.3 mm
