Ali-Helmi/modular_robotics/Housing and PCBs/Housing/Power Delivery/PD_Part3.SLDPRT

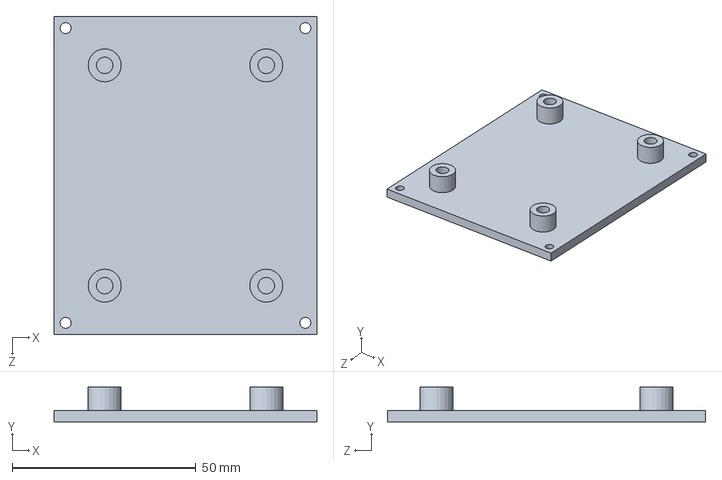
[picture p205: CAD file, 2022-12-05]
Housing and PCBs/Housing/Power Delivery/PD_Part3.SLDPRT
71.6 x 9.53 x 86.6 mm
