Ali-Helmi/modular_robotics/Object Dection and Gripper Arm/Gripper Arm/2-15-2023/newArm/base/modular_base.SLDPRT

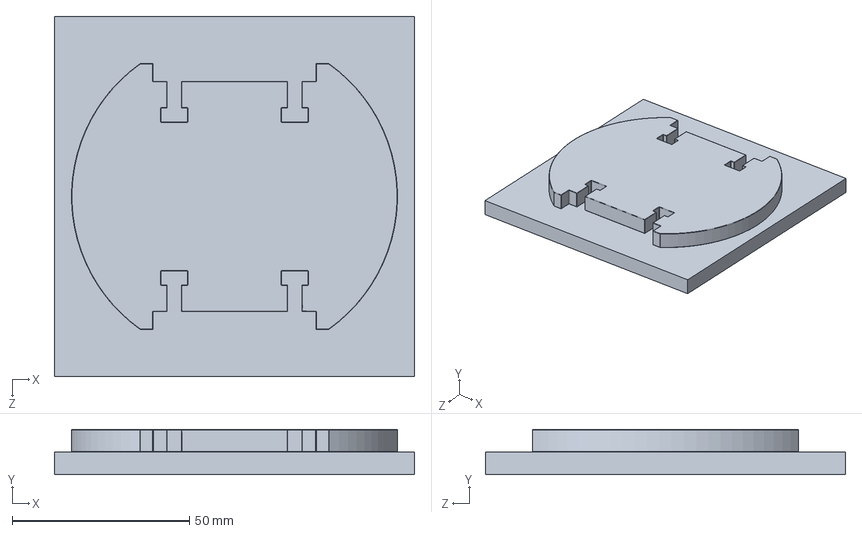
[picture p206: CAD file, 2023-04-12]
Object Dection and Gripper Arm/Gripper Arm/2-15-2023/newArm/base/modular_base.SLDPRT
101.6 x 12.7 x 101.6 mm
