Ali-Helmi/modular_robotics/Object Dection and Gripper Arm/Gripper Arm/2-21-2023/newArm/base/modular_base.SLDPRT

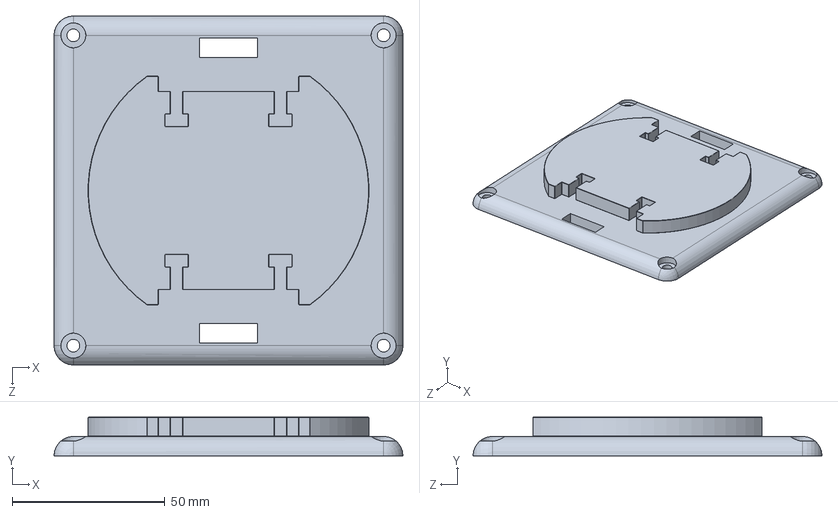
[picture p207: CAD file, 2023-04-12]
Object Dection and Gripper Arm/Gripper Arm/2-21-2023/newArm/base/modular_base.SLDPRT
114.3 x 12.7 x 114.3 mm
