Ali-Helmi/modular_robotics/Object Dection and Gripper Arm/Gripper Arm/3-20-2023/newArm (1)/newArm/arm/leg1.SLDPRT

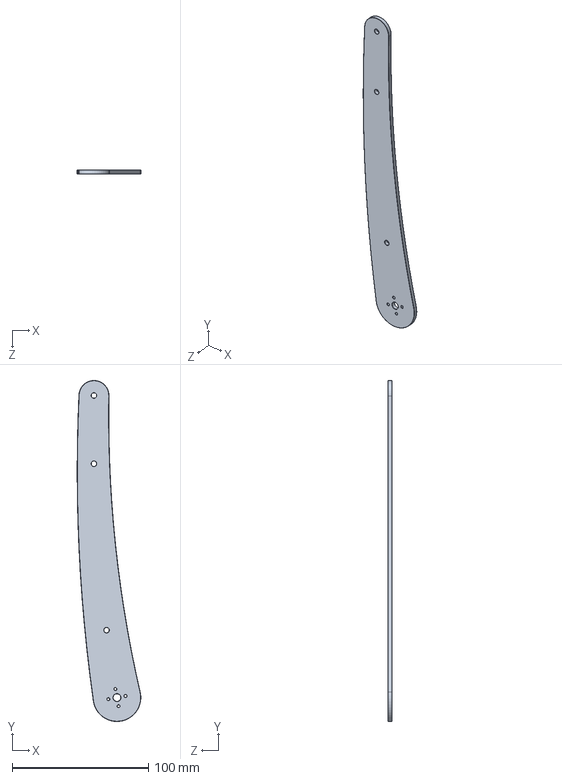
[picture p208: CAD file, 2023-04-12]
Object Dection and Gripper Arm/Gripper Arm/3-20-2023/newArm (1)/newArm/arm/leg1.SLDPRT
46.7 x 249.9 x 3.00 mm
