Ali-Helmi/modular_robotics/Object Dection and Gripper Arm/Gripper Arm/3-20-2023/newArm (1)/newArm/rods/M3Pin_445.SLDPRT

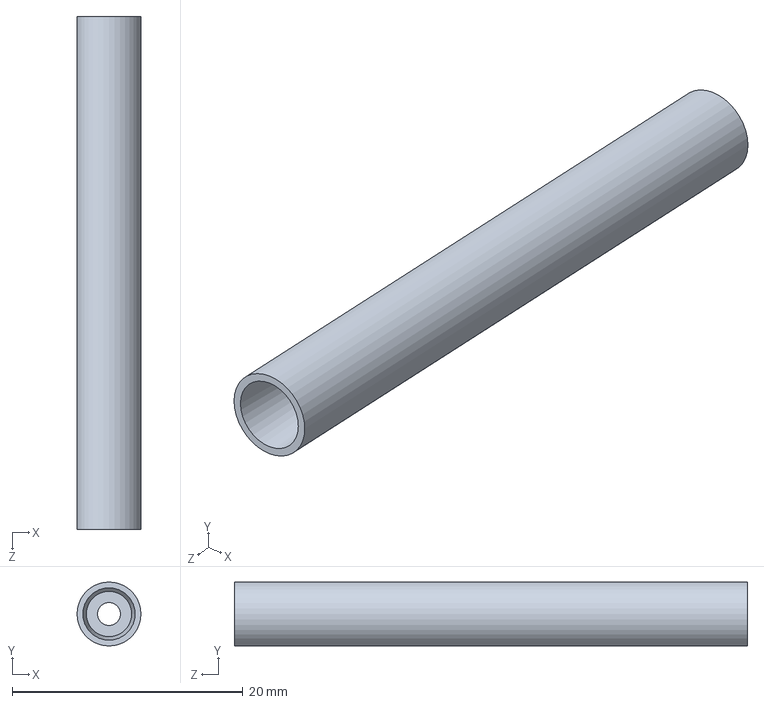
[picture p209: CAD file, 2023-04-12]
Object Dection and Gripper Arm/Gripper Arm/3-20-2023/newArm (1)/newArm/rods/M3Pin_445.SLDPRT
5.55 x 5.55 x 44.5 mm
