Ali-Helmi/modular_robotics/Object Dection and Gripper Arm/Gripper Arm/3-20-2023/newArm (1)/newPrint/base_leg1.STL

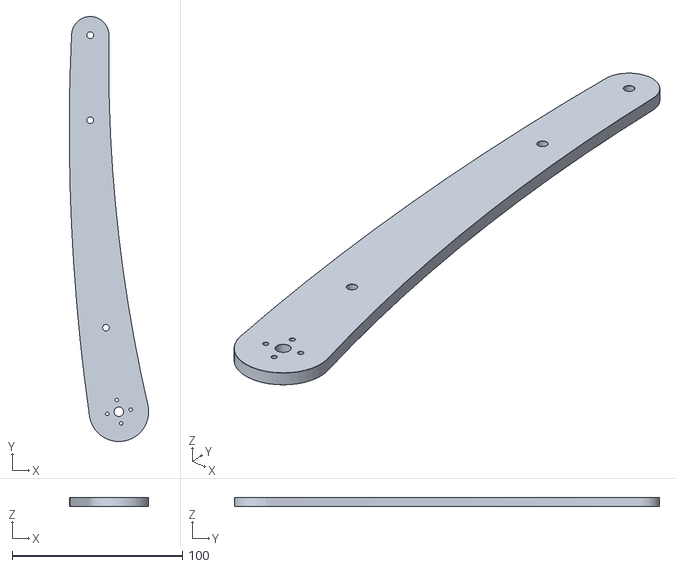
[picture p210: CAD file, 2023-04-12]
Object Dection and Gripper Arm/Gripper Arm/3-20-2023/newArm (1)/newPrint/base_leg1.STL
46.6 x 249.8 x 5.00
