Ali-Helmi/modular_robotics/Object Dection and Gripper Arm/Gripper Arm/3-3-2023/newArm (1)/newArm/arm/base_leg2.SLDPRT

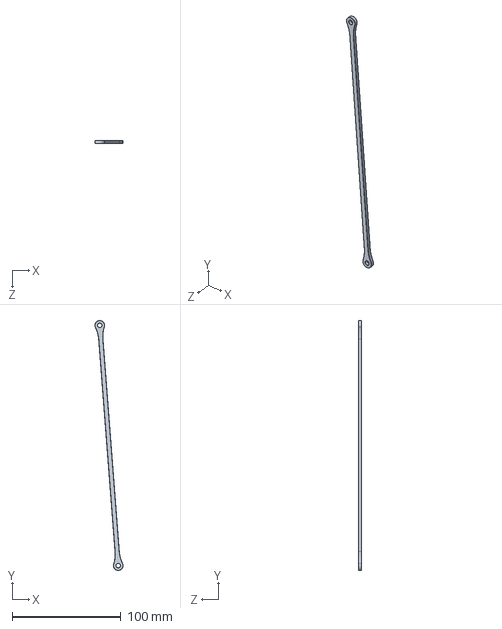
[picture p211: CAD file, 2023-04-12]
Object Dection and Gripper Arm/Gripper Arm/3-3-2023/newArm (1)/newArm/arm/base_leg2.SLDPRT
26.0 x 230.3 x 3.00 mm
