Ali-Helmi/modular_robotics/Object Dection and Gripper Arm/Gripper Arm/3-3-2023/newArm (1)/newArm/rods/M3Pin_25.SLDPRT

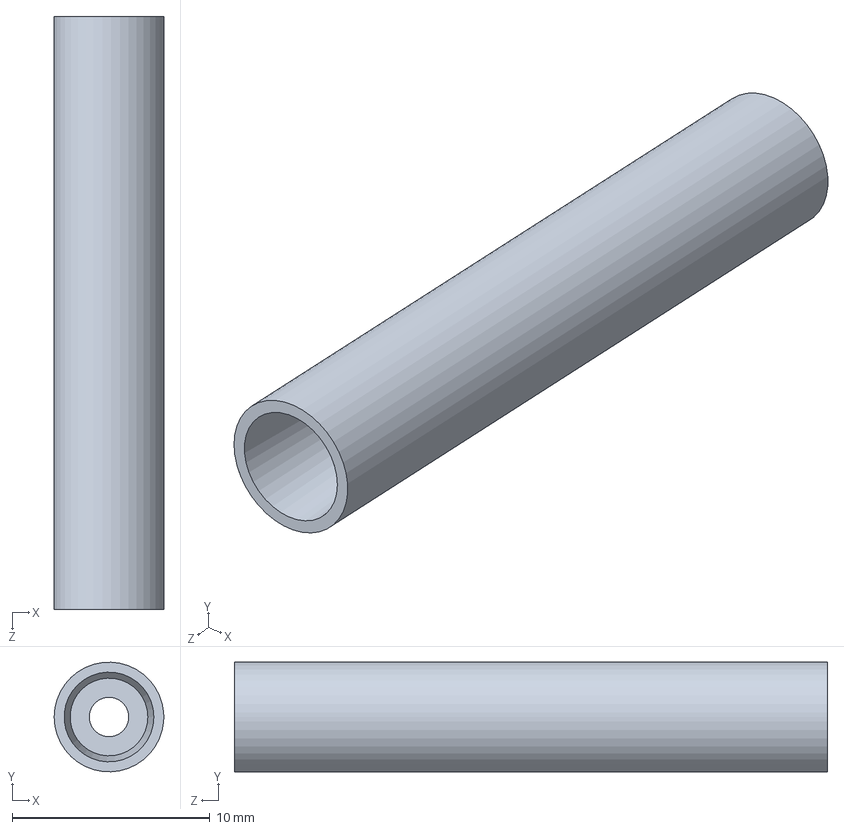
[picture p212: CAD file, 2023-04-12]
Object Dection and Gripper Arm/Gripper Arm/3-3-2023/newArm (1)/newArm/rods/M3Pin_25.SLDPRT
5.55 x 5.55 x 30.0 mm
