Ali-Helmi/modular_robotics/Object Dection and Gripper Arm/Gripper Arm/3-3-2023/print/N8Pin_656.STL

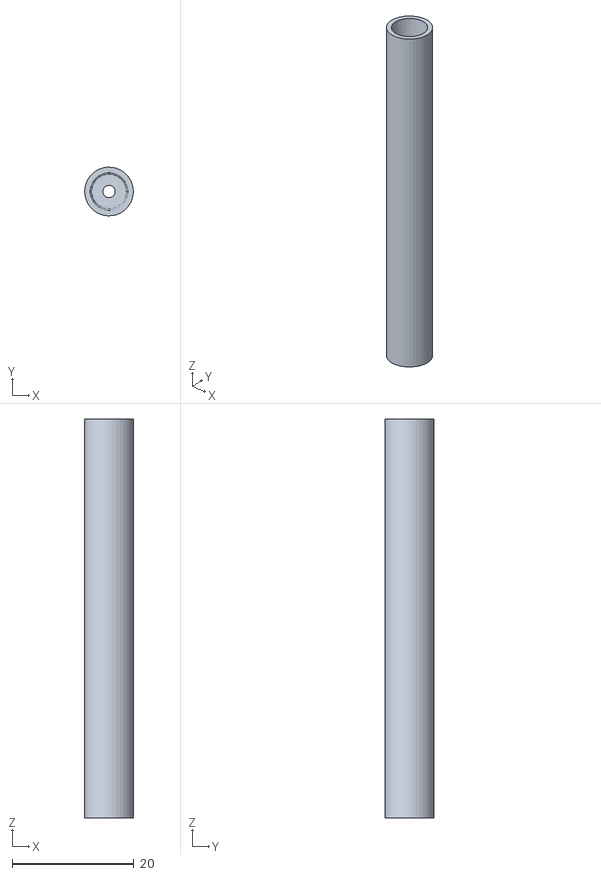
[picture p213: CAD file, 2023-04-12]
Object Dection and Gripper Arm/Gripper Arm/3-3-2023/print/N8Pin_656.STL
8.00 x 7.99 x 65.5
