Ali-Helmi/modular_robotics/Object Dection and Gripper Arm/Gripper Arm/4-2-2023/print_this/M3Pin_36.STL

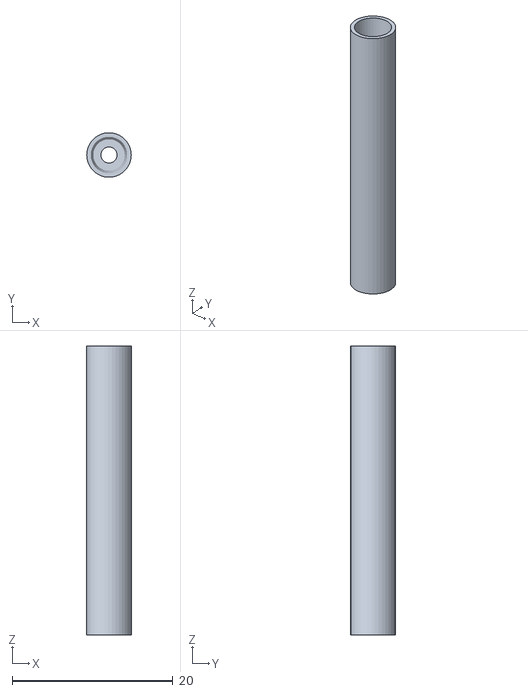
[picture p214: CAD file, 2023-04-12]
Object Dection and Gripper Arm/Gripper Arm/4-2-2023/print_this/M3Pin_36.STL
5.55 x 5.54 x 36.0
