Ali-Helmi/modular_robotics/Housing and PCBs/Housing/Controller Module/Controller_Part2.SLDPRT

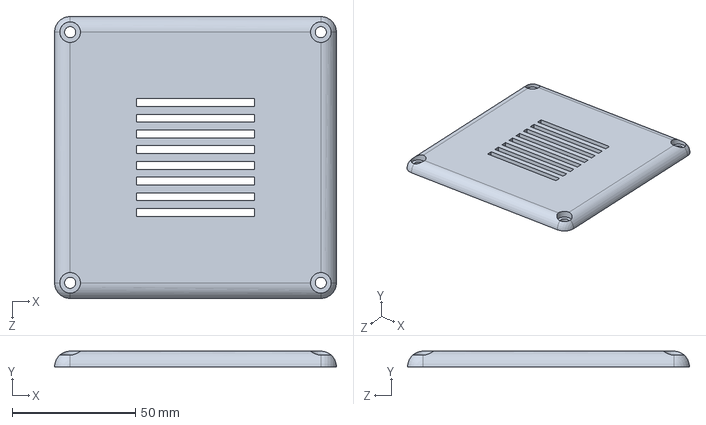
[picture p215: CAD file, 2022-12-05]
Housing and PCBs/Housing/Controller Module/Controller_Part2.SLDPRT
114.3 x 6.35 x 114.3 mm
