Ali-Helmi/modular_robotics/Housing and PCBs/Housing/final_housing_design_404/arm_module/arm_camera_bottom.SLDPRT

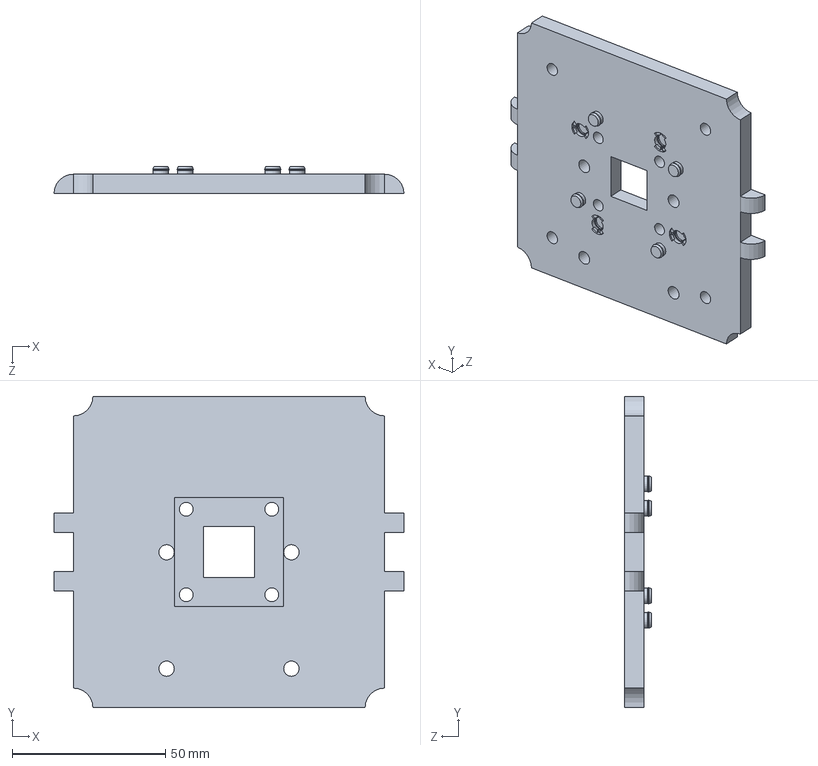
[picture p216: CAD file, 2023-05-02]
Housing and PCBs/Housing/final_housing_design_404/arm_module/arm_camera_bottom.SLDPRT
114.3 x 101.6 x 8.89 mm
