Ali-Helmi/modular_robotics/Housing and PCBs/Housing/final_housing_design_404/battery_module/PD_battery_fastener.SLDPRT

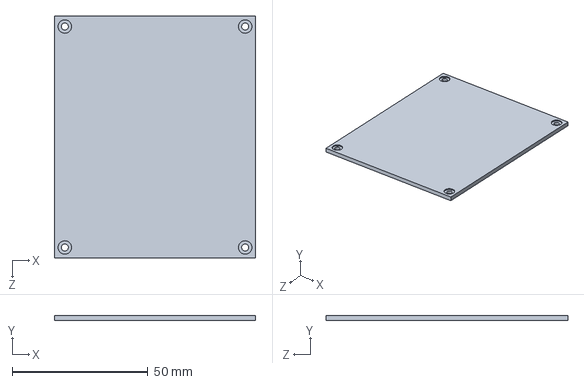
[picture p217: CAD file, 2023-05-02]
Housing and PCBs/Housing/final_housing_design_404/battery_module/PD_battery_fastener.SLDPRT
74.2 x 2.00 x 89.2 mm
