Ali-Helmi/modular_robotics/Housing and PCBs/Housing/final_housing_design_404/camera_module/camera_wall_15deg.SLDPRT

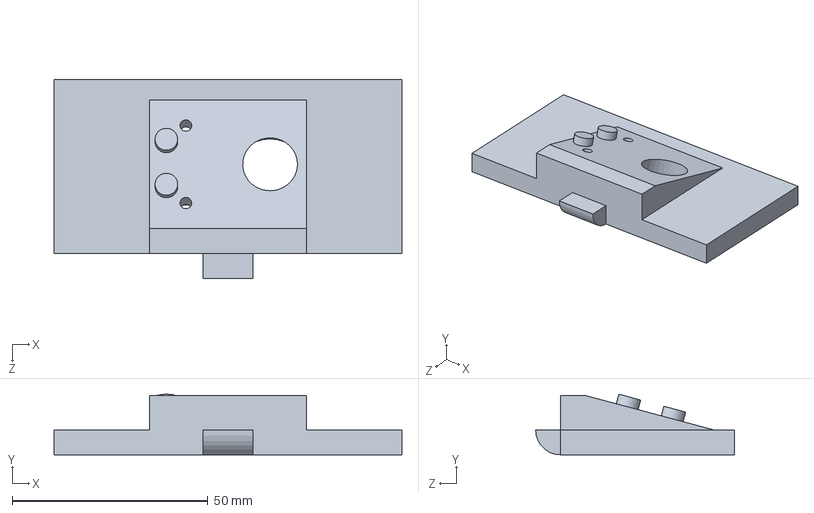
[picture p218: CAD file, 2023-05-02]
Housing and PCBs/Housing/final_housing_design_404/camera_module/camera_wall_15deg.SLDPRT
88.9 x 15.5 x 50.8 mm
