Ali-Helmi/modular_robotics/Housing and PCBs/Housing/final_housing_design_404/controller_module/connecting_top.SLDPRT

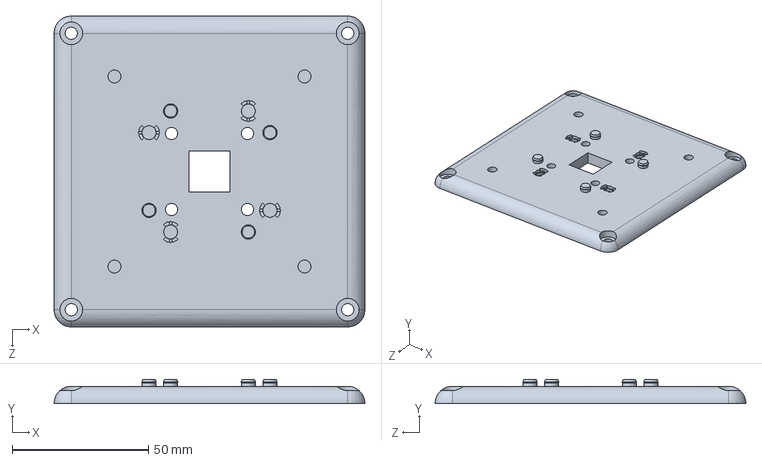
[picture p219: CAD file, 2023-05-02]
Housing and PCBs/Housing/final_housing_design_404/controller_module/connecting_top.SLDPRT
114.3 x 8.89 x 114.3 mm
