Ali-Helmi/modular_robotics/Housing and PCBs/Housing/Housing_before_FDM_optimization_404/arm module/arm_part_2_new.STL

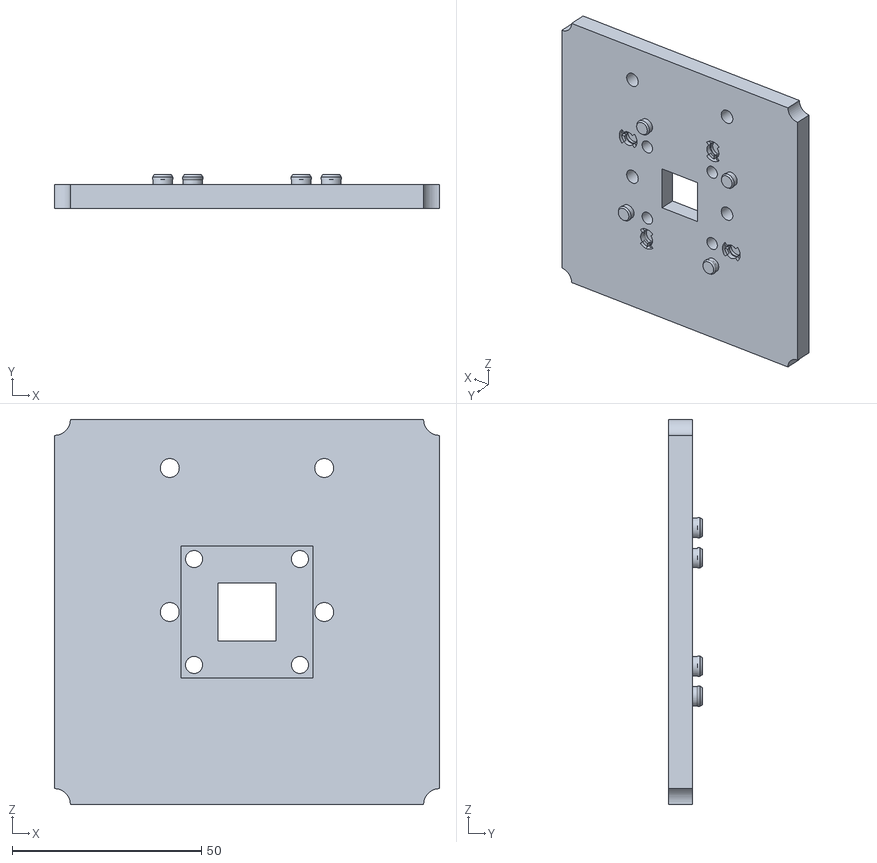
[picture p221: CAD file, 2023-05-02]
Housing and PCBs/Housing/Housing_before_FDM_optimization_404/arm module/arm_part_2_new.STL
101.6 x 8.89 x 101.6
