Ali-Helmi/modular_robotics/Housing and PCBs/Housing/Housing_before_FDM_optimization_404/sensor module/sensor_Part1.SLDPRT

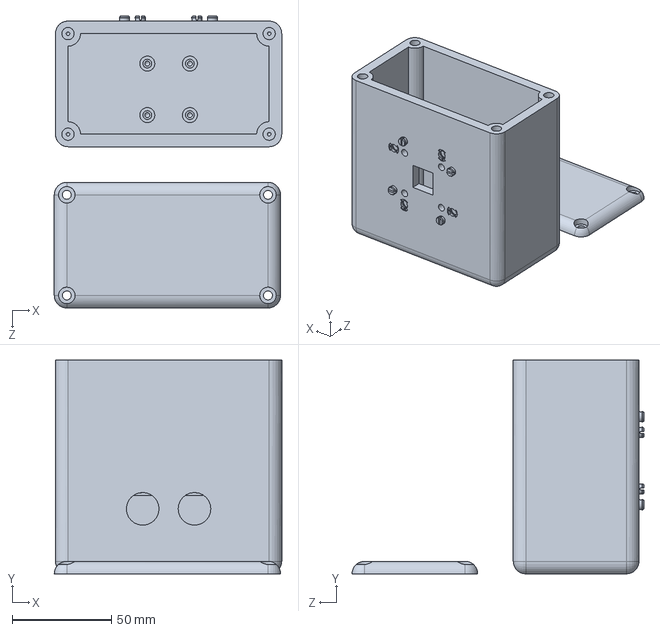
[picture p222: CAD file, 2023-05-02]
Housing and PCBs/Housing/Housing_before_FDM_optimization_404/sensor module/sensor_Part1.SLDPRT
114.9 x 108.0 x 147.5 mm
