Ali-Helmi/modular_robotics/Housing and PCBs/Housing/Motor/Motor_Part3.SLDPRT

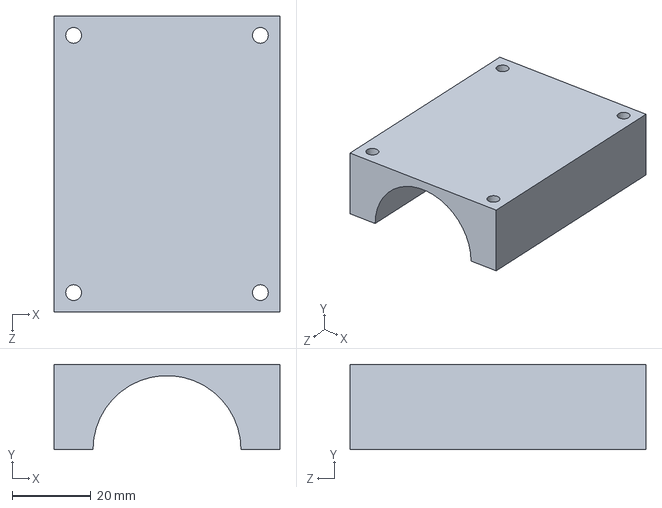
[picture p223: CAD file, 2022-12-05]
Housing and PCBs/Housing/Motor/Motor_Part3.SLDPRT
57.1 x 21.6 x 75.0 mm
