Ali-Helmi/modular_robotics/Object Dection and Gripper Arm/Gripper Arm/2-22-2023/newArm/arm/leg1.SLDPRT

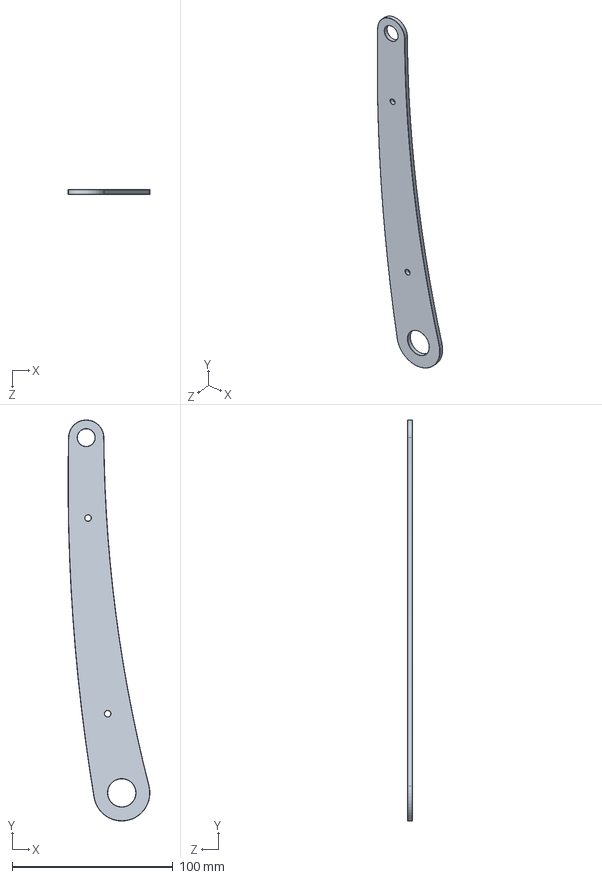
[picture p225: CAD file, 2023-04-12]
Object Dection and Gripper Arm/Gripper Arm/2-22-2023/newArm/arm/leg1.SLDPRT
50.9 x 249.4 x 3.00 mm
