Ali-Helmi/modular_robotics/Object Dection and Gripper Arm/Gripper Arm/3-20-2023/newArm (1)/newArm/arm/base_support.SLDPRT

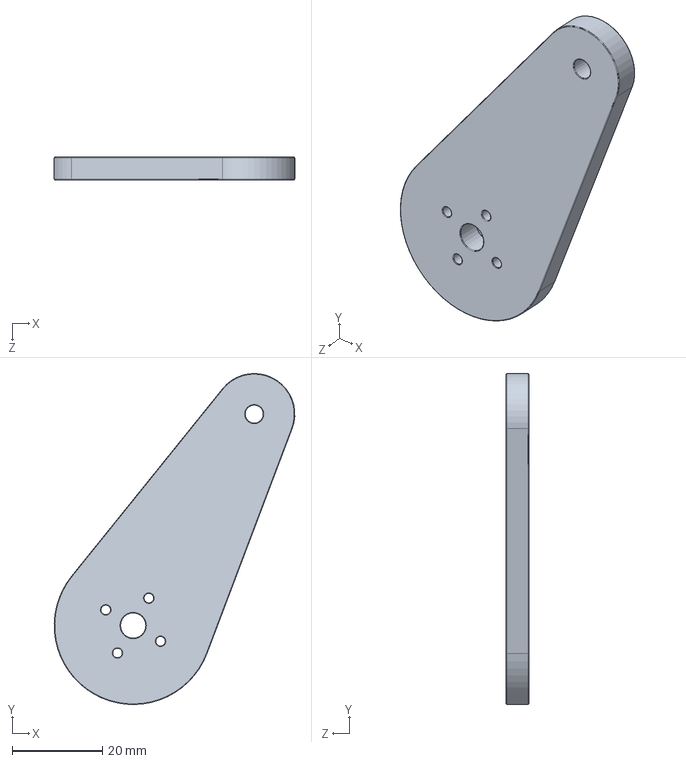
[picture p226: CAD file, 2023-04-12]
Object Dection and Gripper Arm/Gripper Arm/3-20-2023/newArm (1)/newArm/arm/base_support.SLDPRT
53.3 x 73.4 x 5.00 mm
