Ali-Helmi/modular_robotics/Object Dection and Gripper Arm/Gripper Arm/3-20-2023/newArm (1)/newArm/rods/solidPin_475.SLDPRT

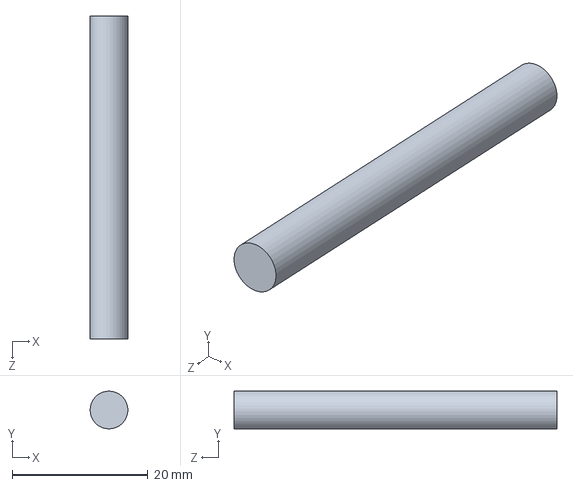
[picture p227: CAD file, 2023-04-12]
Object Dection and Gripper Arm/Gripper Arm/3-20-2023/newArm (1)/newArm/rods/solidPin_475.SLDPRT
5.55 x 5.54 x 47.5 mm
