Ali-Helmi/modular_robotics/Object Dection and Gripper Arm/Gripper Arm/3-26-2023/print_this/half_sphere.STL

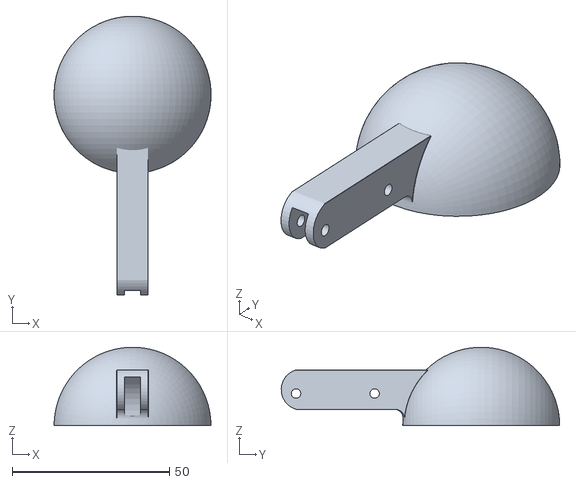
[picture p229: CAD file, 2023-04-12]
Object Dection and Gripper Arm/Gripper Arm/3-26-2023/print_this/half_sphere.STL
50.0 x 88.7 x 24.9
