Ali-Helmi/modular_robotics/Object Dection and Gripper Arm/Gripper Arm/4-2-2023/print_this/weird_part.STL

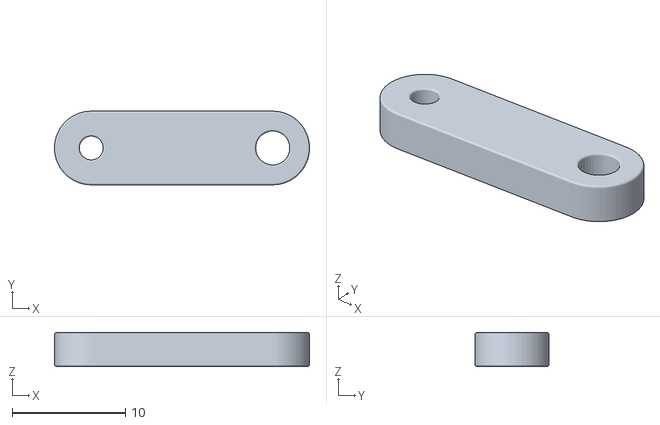
[picture p231: CAD file, 2023-04-12]
Object Dection and Gripper Arm/Gripper Arm/4-2-2023/print_this/weird_part.STL
22.5 x 6.50 x 3.00
