Ali-Helmi/modular_robotics/Object Dection and Gripper Arm/Gripper Arm/Stl/trianglejoint_front.stl

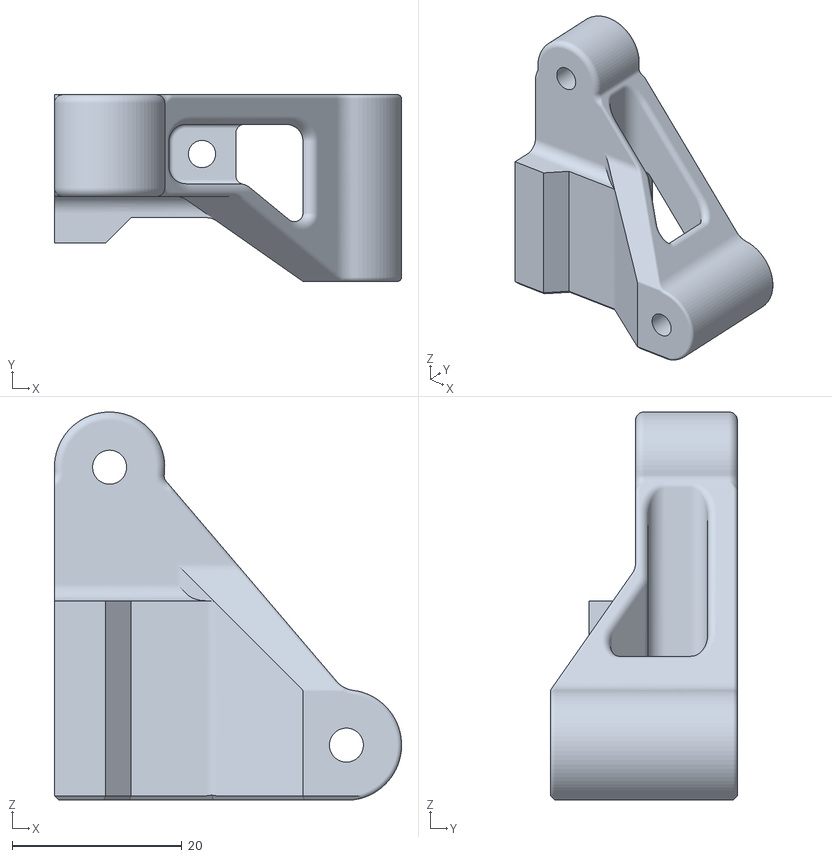
[picture p232: CAD file, 2022-12-05]
Object Dection and Gripper Arm/Gripper Arm/Stl/trianglejoint_front.stl
40.9 x 22.0 x 45.7
