Ali-Helmi/modular_robotics/Housing and PCBs/Housing/final_housing_design_404/arm_module/arm_camera_connecting_wall.SLDPRT

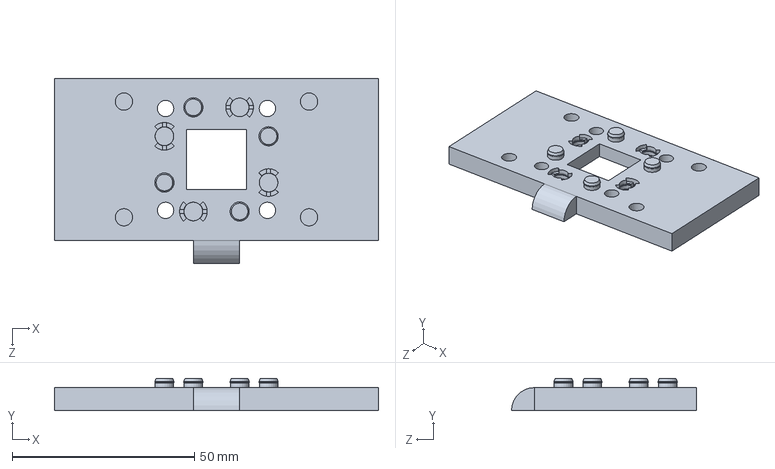
[picture p233: CAD file, 2023-05-02]
Housing and PCBs/Housing/final_housing_design_404/arm_module/arm_camera_connecting_wall.SLDPRT
88.9 x 8.89 x 50.8 mm
