Ali-Helmi/modular_robotics/Housing and PCBs/Housing/final_housing_design_404/battery_module/PD_base.SLDPRT

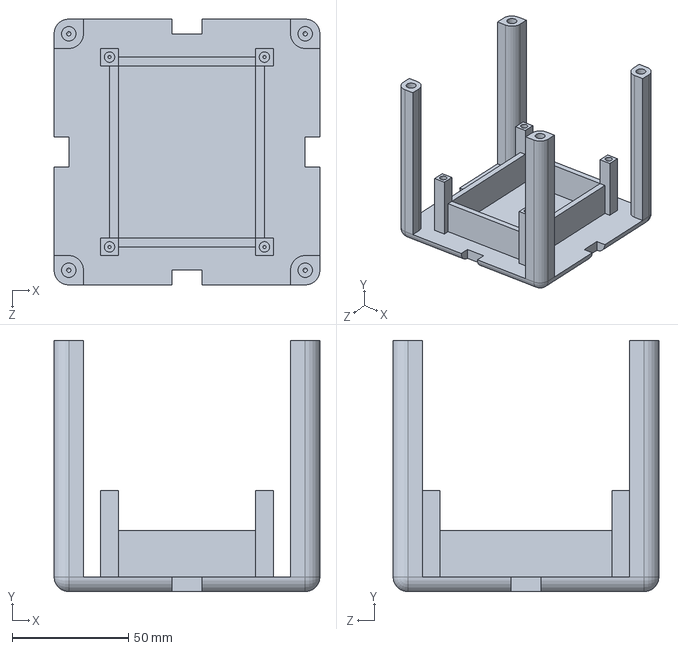
[picture p234: CAD file, 2023-05-02]
Housing and PCBs/Housing/final_housing_design_404/battery_module/PD_base.SLDPRT
114.3 x 108.0 x 114.3 mm
