Ali-Helmi/modular_robotics/Object Dection and Gripper Arm/Gripper Arm/2-22-2023/newArm/arm/boards.SLDPRT

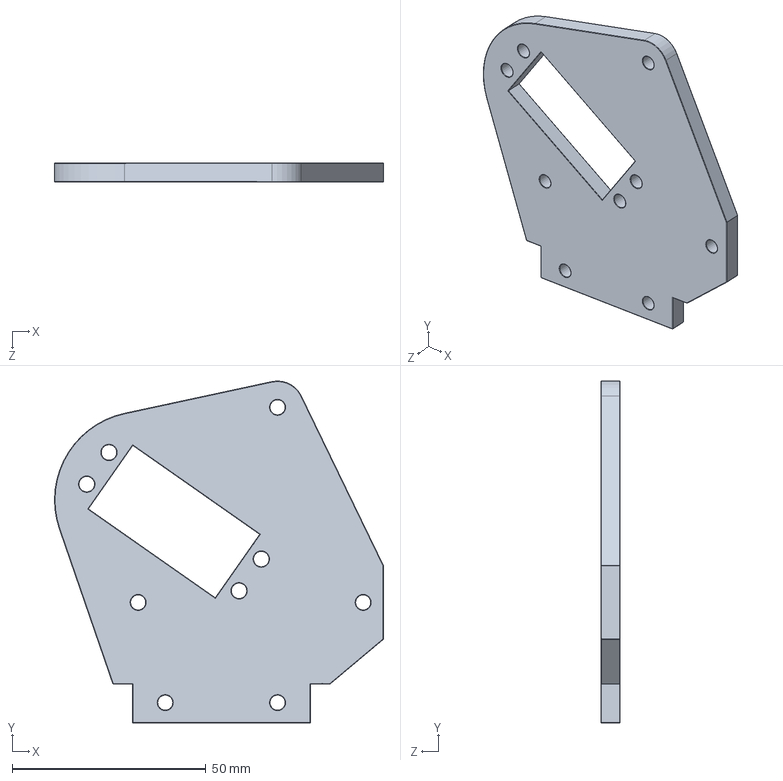
[picture p236: CAD file, 2023-04-12]
Object Dection and Gripper Arm/Gripper Arm/2-22-2023/newArm/arm/boards.SLDPRT
84.9 x 88.3 x 5.00 mm
