Ali-Helmi/modular_robotics/Object Dection and Gripper Arm/Gripper Arm/3-20-2023/newArm (1)/newArm/arm/extension_leg1.SLDPRT

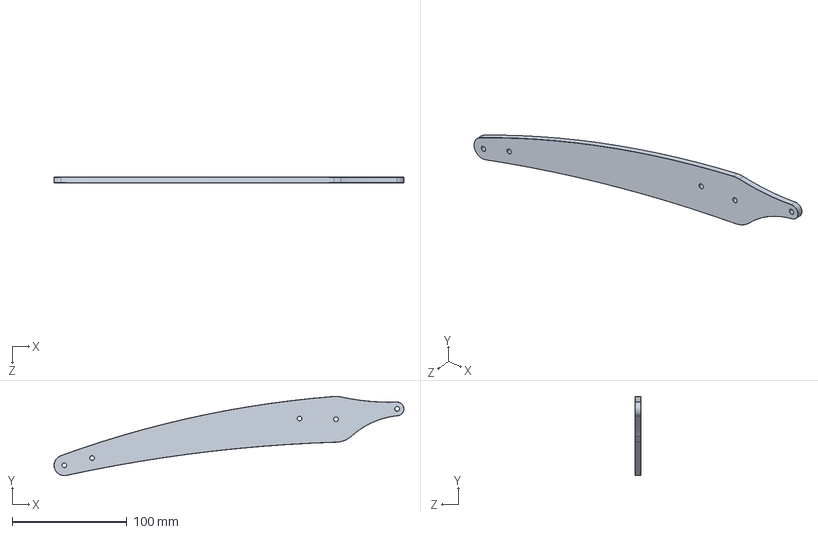
[picture p237: CAD file, 2023-04-12]
Object Dection and Gripper Arm/Gripper Arm/3-20-2023/newArm (1)/newArm/arm/extension_leg1.SLDPRT
304.9 x 69.1 x 5.00 mm
