Ali-Helmi/modular_robotics/Object Dection and Gripper Arm/Gripper Arm/3-20-2023/newArm (1)/newPrint/N8Pin_656.STL

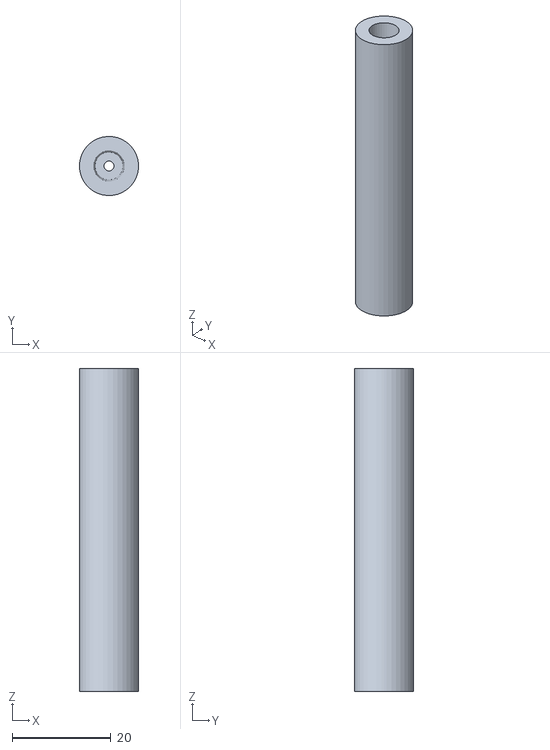
[picture p239: CAD file, 2023-04-12]
Object Dection and Gripper Arm/Gripper Arm/3-20-2023/newArm (1)/newPrint/N8Pin_656.STL
12.0 x 12.0 x 65.5
