Ali-Helmi/modular_robotics/Object Dection and Gripper Arm/Gripper Arm/3-3-2023/print/M3Pin_25.STL

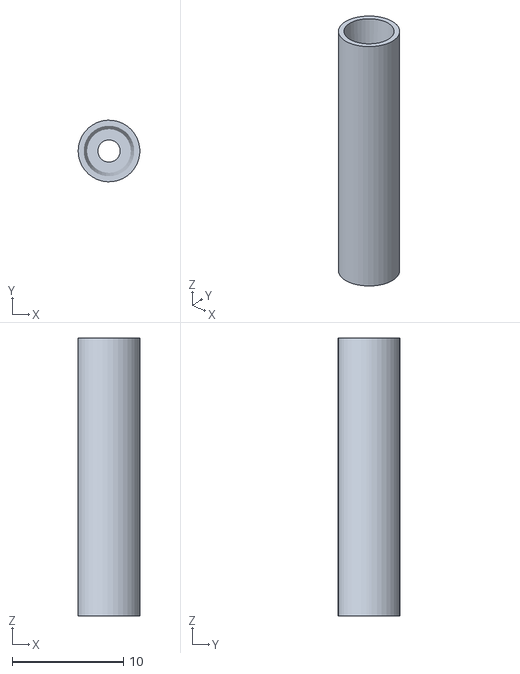
[picture p240: CAD file, 2023-04-12]
Object Dection and Gripper Arm/Gripper Arm/3-3-2023/print/M3Pin_25.STL
5.55 x 5.54 x 25.0
