Ali-Helmi/modular_robotics/Housing and PCBs/Housing/final_housing_design_404/arm_module/arm_camera_base.SLDPRT

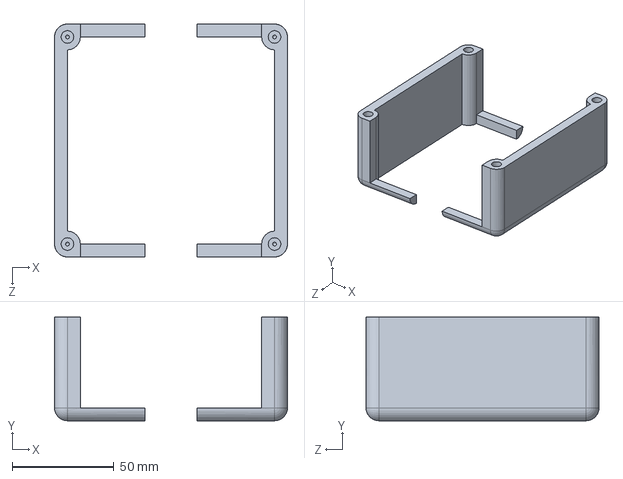
[picture p241: CAD file, 2023-05-02]
Housing and PCBs/Housing/final_housing_design_404/arm_module/arm_camera_base.SLDPRT
114.3 x 50.8 x 114.3 mm
