Ali-Helmi/modular_robotics/Object Dection and Gripper Arm/Gripper Arm/2-22-2023/newArm/arm/base_leg2.SLDPRT

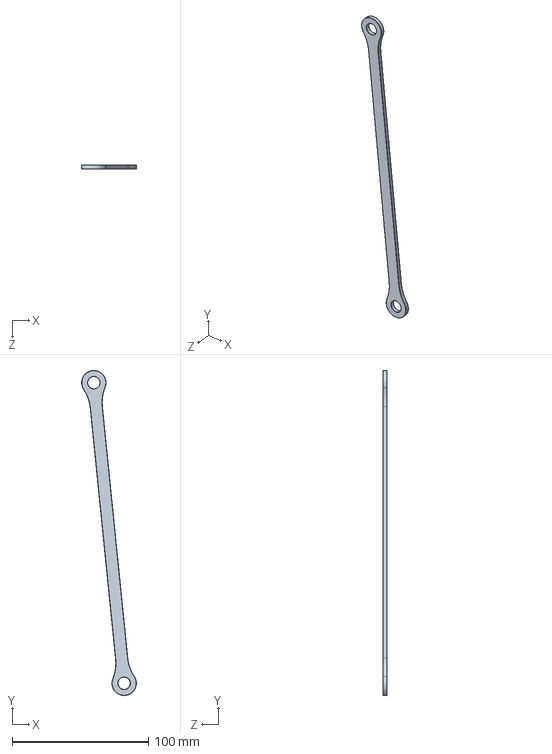
[picture p242: CAD file, 2023-04-12]
Object Dection and Gripper Arm/Gripper Arm/2-22-2023/newArm/arm/base_leg2.SLDPRT
40.2 x 238.8 x 3.00 mm
