Ali-Helmi/modular_robotics/Object Dection and Gripper Arm/Gripper Arm/3-3-2023/newArm (1)/newArm/arm/boards.SLDPRT

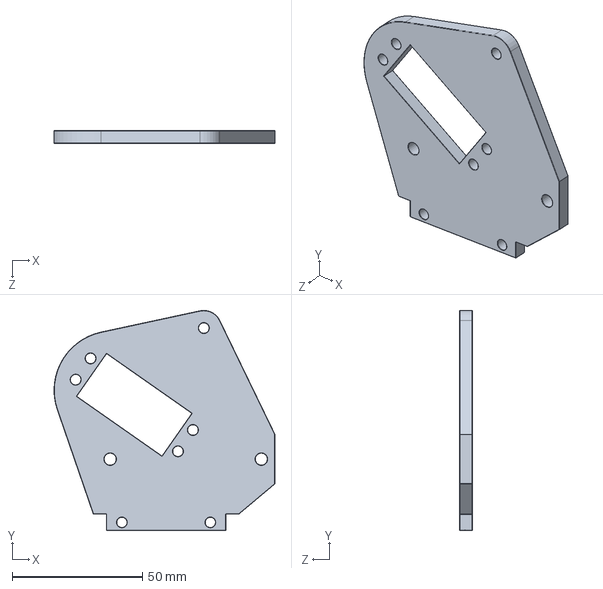
[picture p243: CAD file, 2023-04-12]
Object Dection and Gripper Arm/Gripper Arm/3-3-2023/newArm (1)/newArm/arm/boards.SLDPRT
84.9 x 84.6 x 5.00 mm
