Ali-Helmi/modular_robotics/Object Dection and Gripper Arm/Gripper Arm/3-3-2023/print/base_triangle.STL

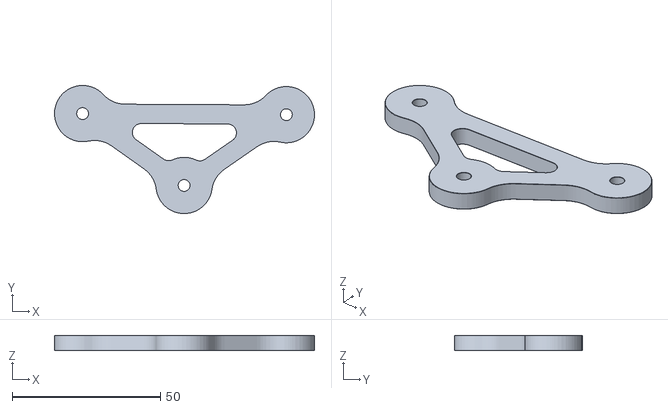
[picture p244: CAD file, 2023-04-12]
Object Dection and Gripper Arm/Gripper Arm/3-3-2023/print/base_triangle.STL
87.8 x 43.3 x 5.00
