Ali-Helmi/modular_robotics/Object Dection and Gripper Arm/Gripper Arm/4-2-2023/print_this/middle_gaurd.STL

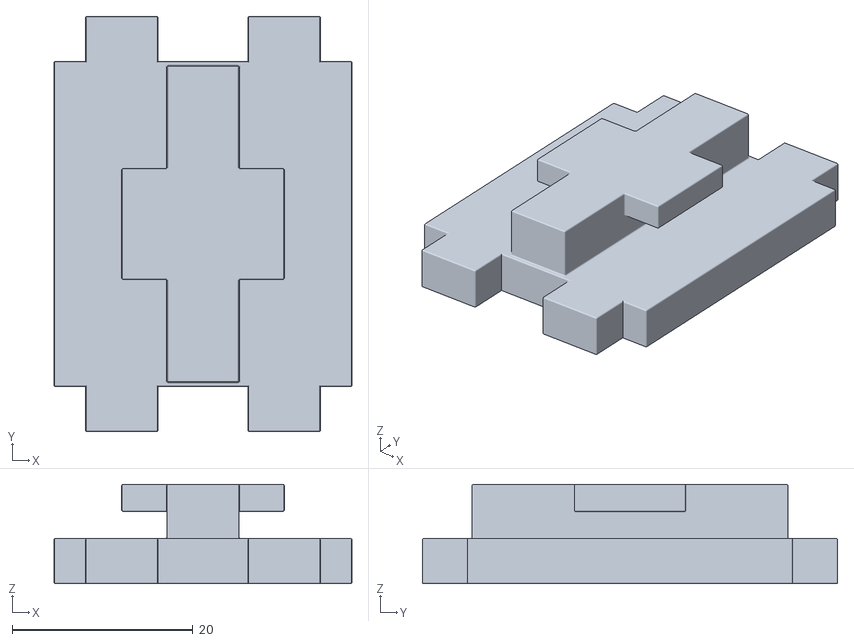
[picture p245: CAD file, 2023-04-12]
Object Dection and Gripper Arm/Gripper Arm/4-2-2023/print_this/middle_gaurd.STL
33.0 x 46.0 x 11.0
