Ali-Helmi/modular_robotics/Object Dection and Gripper Arm/Gripper Arm/Stl/gripper_armleft.stl

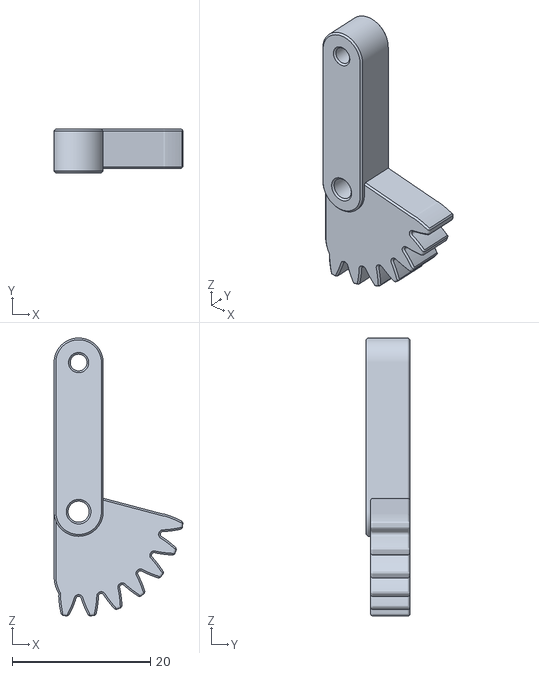
[picture p246: CAD file, 2022-12-05]
Object Dection and Gripper Arm/Gripper Arm/Stl/gripper_armleft.stl
18.7 x 6.35 x 40.2
