Ali-Helmi/modular_robotics/Object Dection and Gripper Arm/Gripper Arm/3-20-2023/newArm (1)/newArm/arm/center_pin.SLDPRT

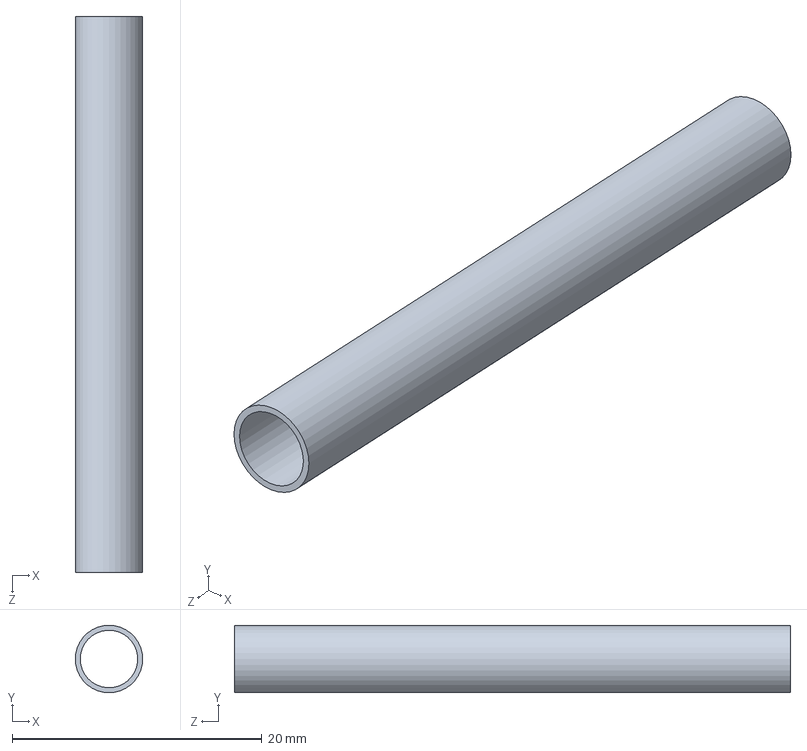
[picture p247: CAD file, 2023-04-12]
Object Dection and Gripper Arm/Gripper Arm/3-20-2023/newArm (1)/newArm/arm/center_pin.SLDPRT
5.40 x 5.40 x 44.5 mm
