Ali-Helmi/modular_robotics/Object Dection and Gripper Arm/Gripper Arm/3-20-2023/newArm (1)/newPrint/extension_leg2.STL

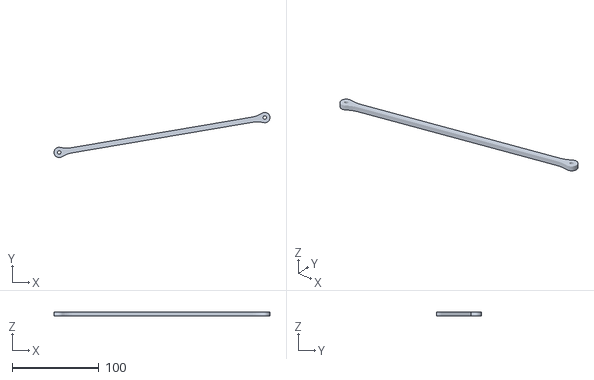
[picture p248: CAD file, 2023-04-12]
Object Dection and Gripper Arm/Gripper Arm/3-20-2023/newArm (1)/newPrint/extension_leg2.STL
248.6 x 52.1 x 5.00
