Ali-Helmi/modular_robotics/Object Dection and Gripper Arm/Gripper Arm/4-2-2023/print_this/half_sphere.STL

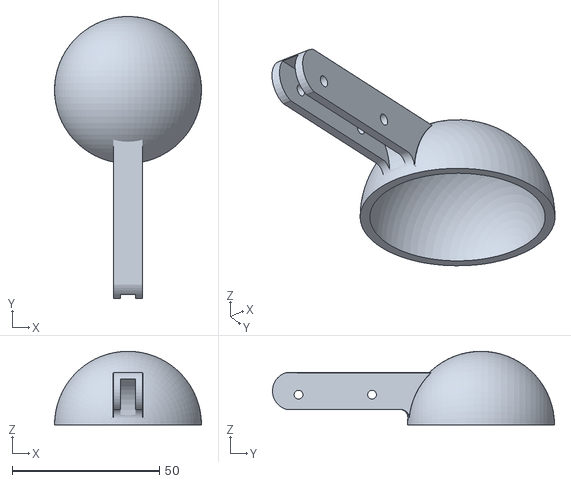
[picture p249: CAD file, 2023-04-12]
Object Dection and Gripper Arm/Gripper Arm/4-2-2023/print_this/half_sphere.STL
50.0 x 95.9 x 25.0
