Ali-Helmi/modular_robotics/Object Dection and Gripper Arm/Gripper Arm/3-20-2023/newArm (1)/newArm/rods/M3Pin_18.SLDPRT

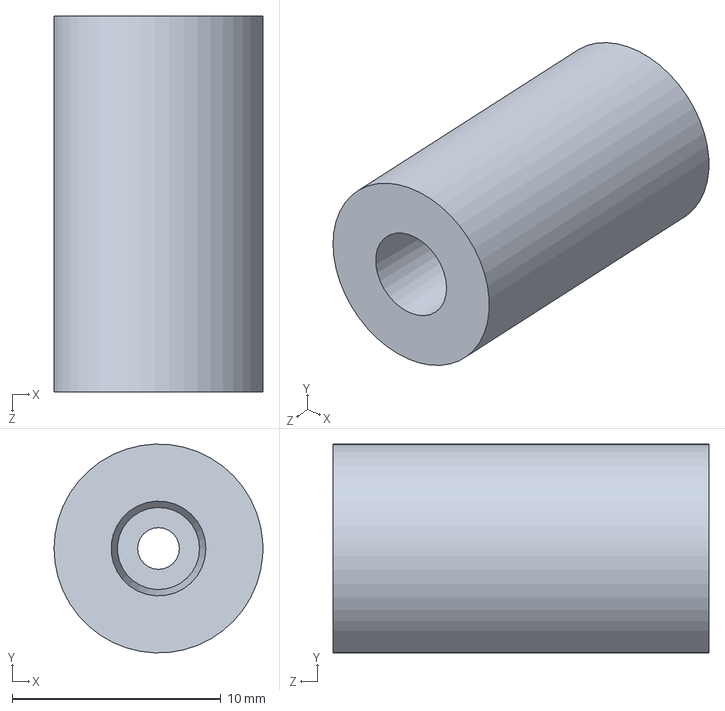
[picture p250: CAD file, 2023-04-12]
Object Dection and Gripper Arm/Gripper Arm/3-20-2023/newArm (1)/newArm/rods/M3Pin_18.SLDPRT
10.0 x 9.99 x 18.0 mm
