Ali-Helmi/modular_robotics/Object Dection and Gripper Arm/Gripper Arm/3-3-2023/newArm (1)/newArm/arm/extension_leg2.SLDPRT

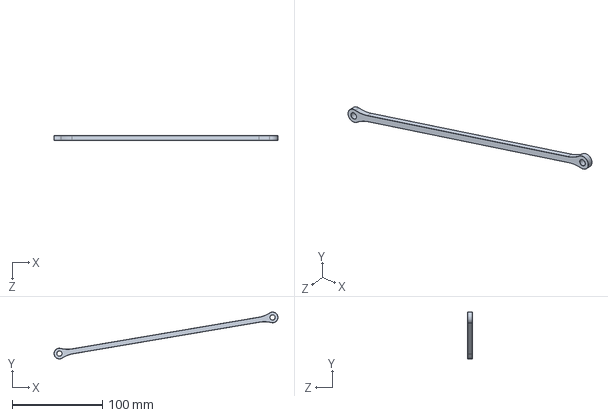
[picture p251: CAD file, 2023-04-12]
Object Dection and Gripper Arm/Gripper Arm/3-3-2023/newArm (1)/newArm/arm/extension_leg2.SLDPRT
248.6 x 52.1 x 5.00 mm
