Ali-Helmi/modular_robotics/Object Dection and Gripper Arm/Gripper Arm/Stl/gripper_forwardarm.stl

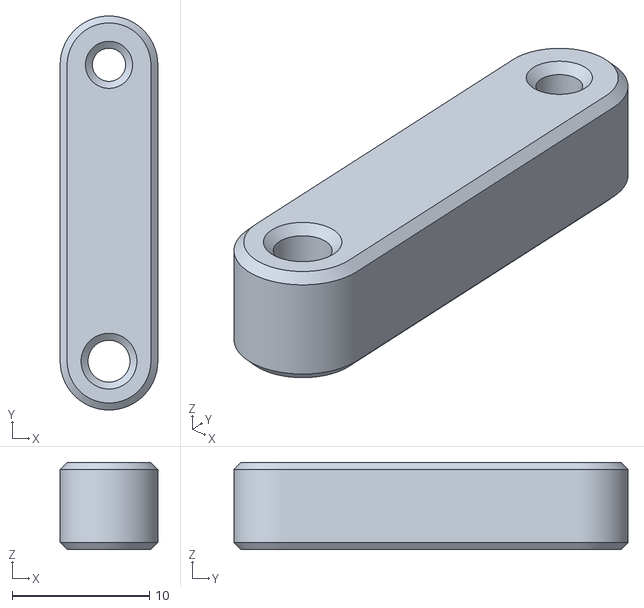
[picture p253: CAD file, 2022-12-05]
Object Dection and Gripper Arm/Gripper Arm/Stl/gripper_forwardarm.stl
7.11 x 28.7 x 6.35
