Ali-Helmi/modular_robotics/Object Dection and Gripper Arm/Gripper Arm/3-3-2023/newArm (1)/newArm/rods/M3Pin_18.SLDPRT

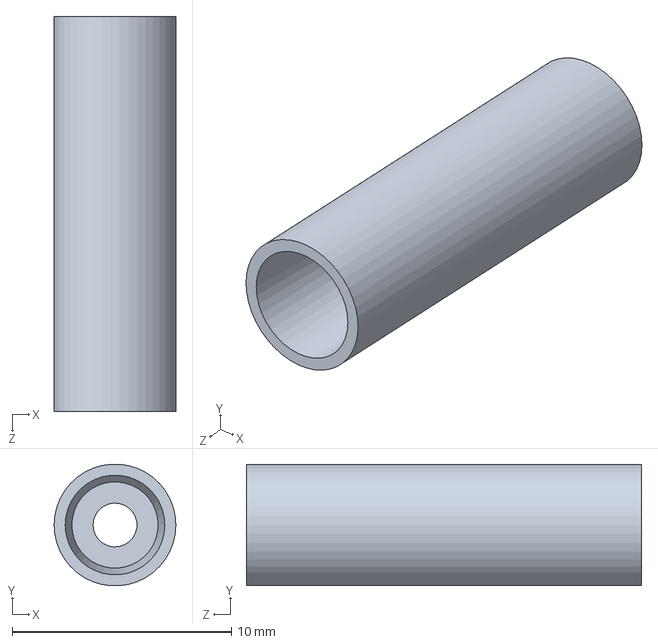
[picture p254: CAD file, 2023-04-12]
Object Dection and Gripper Arm/Gripper Arm/3-3-2023/newArm (1)/newArm/rods/M3Pin_18.SLDPRT
5.55 x 5.53 x 18.0 mm
