Ali-Helmi/modular_robotics/Object Dection and Gripper Arm/Gripper Arm/4-2-2023/print_this/servo_stabilizer2.STL

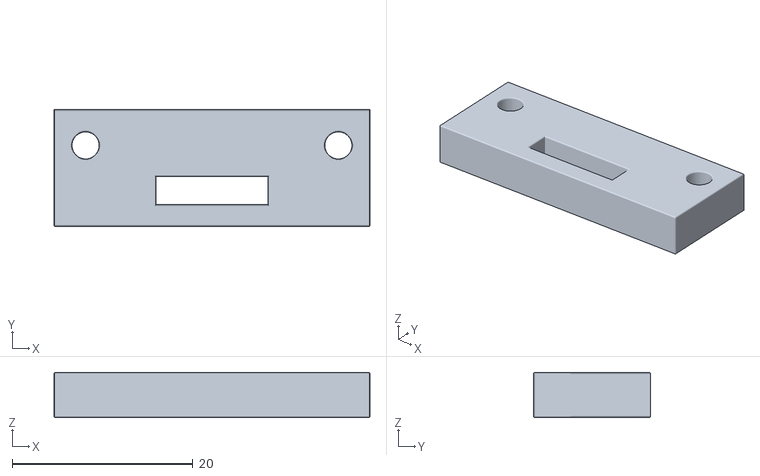
[picture p255: CAD file, 2023-04-12]
Object Dection and Gripper Arm/Gripper Arm/4-2-2023/print_this/servo_stabilizer2.STL
35.0 x 13.0 x 5.00
