Ali-Helmi/modular_robotics/Object Dection and Gripper Arm/Gripper Arm/3-20-2023/newArm (1)/newArm/arm/base_leg3.SLDPRT

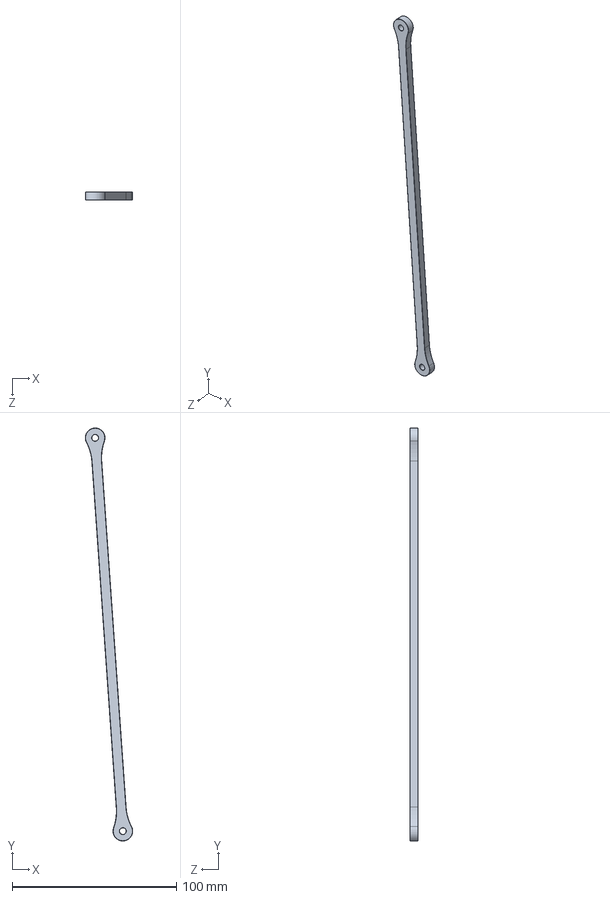
[picture p256: CAD file, 2023-04-12]
Object Dection and Gripper Arm/Gripper Arm/3-20-2023/newArm (1)/newArm/arm/base_leg3.SLDPRT
28.8 x 251.4 x 5.00 mm
