Ali-Helmi/modular_robotics/Object Dection and Gripper Arm/Gripper Arm/3-20-2023/newArm (1)/newArm/rods/M3Pin_20.SLDPRT

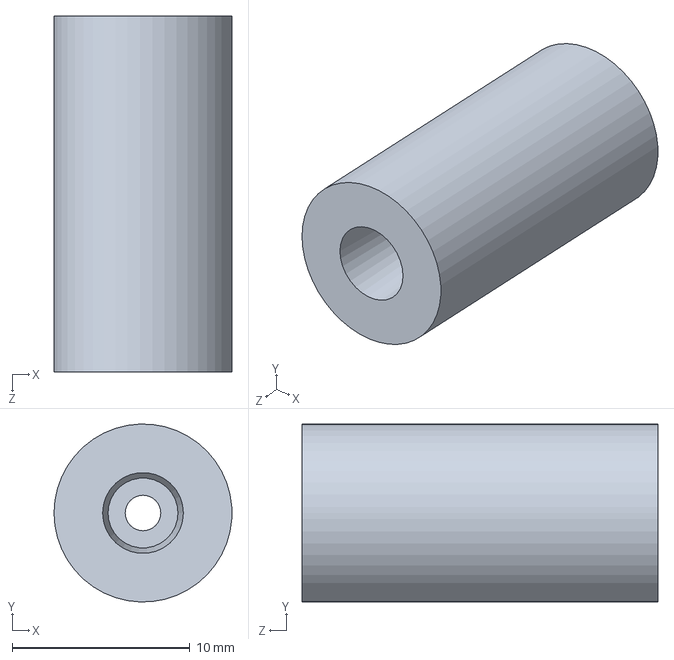
[picture p257: CAD file, 2023-04-12]
Object Dection and Gripper Arm/Gripper Arm/3-20-2023/newArm (1)/newArm/rods/M3Pin_20.SLDPRT
10.0 x 9.99 x 20.0 mm
