Ali-Helmi/modular_robotics/Object Dection and Gripper Arm/Gripper Arm/3-20-2023/newArm (1)/newPrint/M3Pin_47_solid.STL

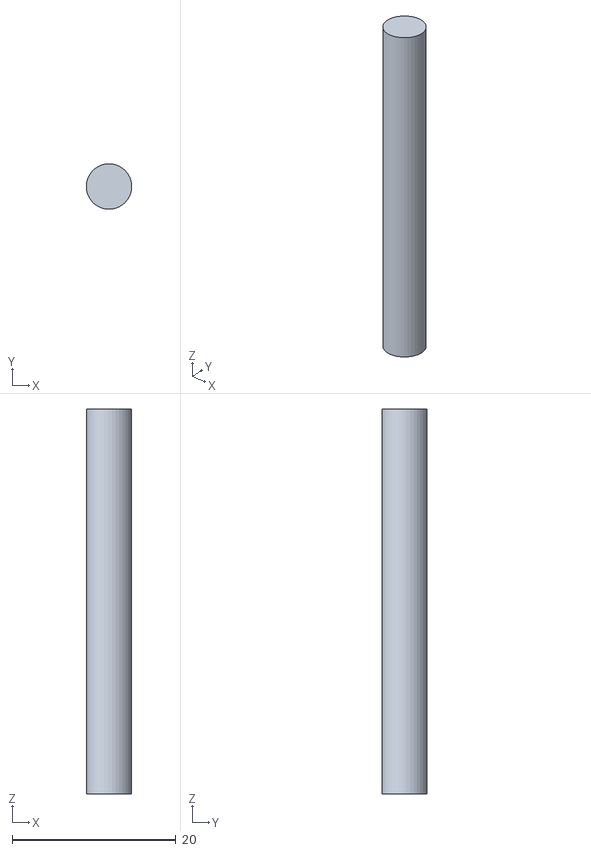
[picture p258: CAD file, 2023-04-12]
Object Dection and Gripper Arm/Gripper Arm/3-20-2023/newArm (1)/newPrint/M3Pin_47_solid.STL
5.55 x 5.54 x 47.0
