Ali-Helmi/modular_robotics/Object Dection and Gripper Arm/Gripper Arm/4-2-2023/print_this/triangular_connectors.STL

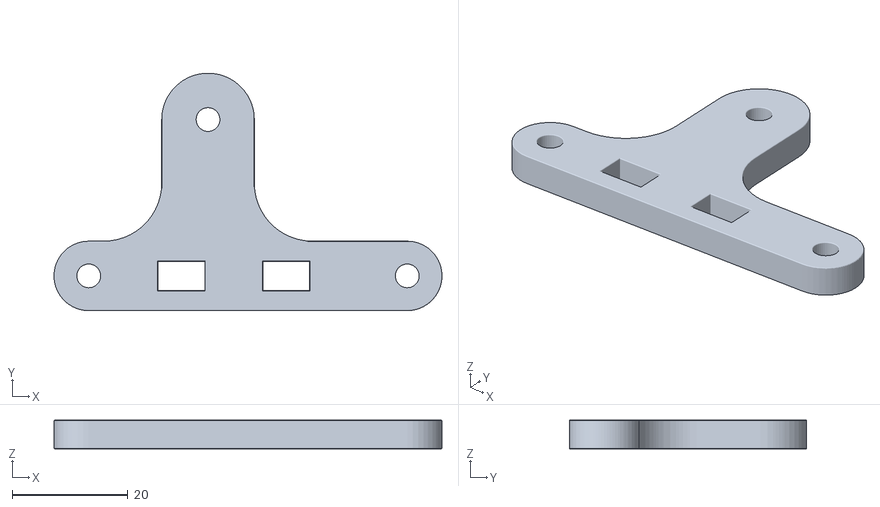
[picture p259: CAD file, 2023-04-12]
Object Dection and Gripper Arm/Gripper Arm/4-2-2023/print_this/triangular_connectors.STL
67.0 x 41.0 x 5.00
