Ali-Helmi/modular_robotics/Object Dection and Gripper Arm/Gripper Arm/Stl/link15.stl

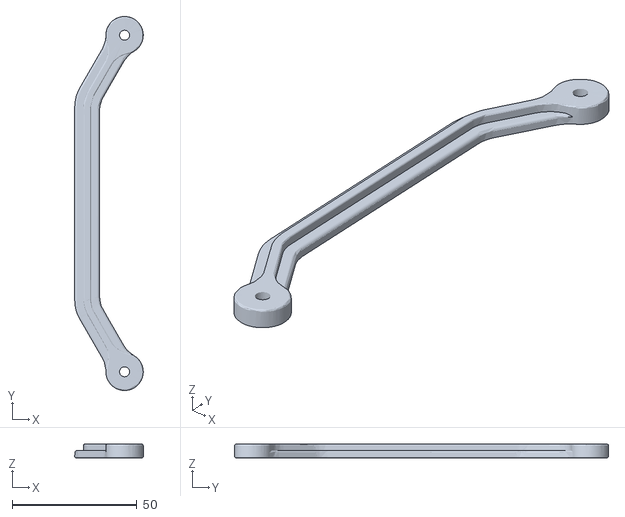
[picture p260: CAD file, 2022-12-05]
Object Dection and Gripper Arm/Gripper Arm/Stl/link15.stl
27.5 x 150.0 x 5.50
