Ali-Helmi/modular_robotics/(list of files, cad)

Other CAD files:
Object Dection and Gripper Arm/Gripper Arm/2-15-2023/newArm/arm/hollistic_sketch.SLDASM
Object Dection and Gripper Arm/Gripper Arm/2-21-2023/newArm/arm/hollistic_sketch_double.SLDASM
Object Dection and Gripper Arm/Gripper Arm/3-20-2023/newArm (1)/newArm/gripper/Assem1.SLDASM
Object Dection and Gripper Arm/Gripper Arm/2-17-2023/newArm/arm/hollistic_sketch.SLDASM
Object Dection and Gripper Arm/Gripper Arm/2-21-2023/newArm/arm/hollistic_sketch.SLDASM
Housing and PCBs/Housing/final_housing_design_404/controller_module/connecting_wall.SLDPRT
Housing and PCBs/Housing/final_housing_design_404/stl_files/motor_fastener.STL
Housing and PCBs/Housing/Housing_before_FDM_optimization_404/camera module/camera_Part1.SLDPRT
Housing and PCBs/Housing/Housing_before_FDM_optimization_404/connector module/connector_part1.SLDPRT
Housing and PCBs/Housing/Housing_before_FDM_optimization_404/controller module/ControllerModule_Part1(edit and reprint this).SLDPRT
Housing and PCBs/Housing/Housing_before_FDM_optimization_404/motor module/motor_new_Part1v2.STL
Object Dection and Gripper Arm/Gripper Arm/2-17-2023/newArm/arm/boards.SLDPRT
Object Dection and Gripper Arm/Gripper Arm/2-22-2023/newArm/base/modular_base_stl.STL
Object Dection and Gripper Arm/Gripper Arm/3-20-2023/newArm (1)/newArm/base/modular_base.SLDPRT
Object Dection and Gripper Arm/Gripper Arm/3-3-2023/newArm (1)/newArm/base/modular_base_stl.STL
Housing and PCBs/Housing/Connector Module/Connector_Part1.SLDPRT
Housing and PCBs/Housing/final_housing_design_404/stl_files/arm_camera_bottom.STL
Housing and PCBs/Housing/Housing_before_FDM_optimization_404/camera module/camera_Part1_v2.SLDPRT
Housing and PCBs/Housing/Housing_before_FDM_optimization_404/controller module/ControllerModule_Part1_v2.SLDPRT
Housing and PCBs/Housing/Housing_before_FDM_optimization_404/motor module/motor_new_Part1.SLDPRT
Housing and PCBs/Housing/Housing_before_FDM_optimization_404/power module/PD_Part1_v2.SLDPRT
Object Dection and Gripper Arm/Gripper Arm/2-21-2023/newArm/base/modular_base_stl.STL
Object Dection and Gripper Arm/Gripper Arm/3-20-2023/newArm (1)/newArm/base/modular_base_stl.STL
Object Dection and Gripper Arm/Gripper Arm/3-3-2023/newArm (1)/newArm/arm/base_leg1.SLDPRT
Object Dection and Gripper Arm/Gripper Arm/3-3-2023/newArm (1)/newArm/base/modular_base.SLDPRT
Object Dection and Gripper Arm/Gripper Arm/3-3-2023/print/M3Pin_20.STL
Housing and PCBs/Housing/final_housing_design_404/stl_files/connecting_wall.STL
Housing and PCBs/Housing/Housing_before_FDM_optimization_404/arm module/arm_Part2.SLDPRT
Housing and PCBs/Housing/Housing_before_FDM_optimization_404/controller module/ControllerModule_Part1.STL
Housing and PCBs/Housing/Housing_before_FDM_optimization_404/motor module/motor_new2_Part1.STL
Housing and PCBs/Housing/Motor/Motor_Part1.SLDPRT
Housing and PCBs/Housing/Power Delivery/PD_Part2.SLDPRT
Object Dection and Gripper Arm/Gripper Arm/2-21-2023/newArm/arm/boards.SLDPRT
Object Dection and Gripper Arm/Gripper Arm/Stl/trianglejoint.stl
Housing and PCBs/Housing/final_housing_design_404/stl_files/motor_base.STL
Housing and PCBs/Housing/Housing_before_FDM_optimization_404/arm module/connecting_face_(edit this).SLDPRT
Housing and PCBs/Housing/Housing_before_FDM_optimization_404/controller module/connecting_face_(edit this).SLDPRT
Object Dection and Gripper Arm/Gripper Arm/3-20-2023/newArm (1)/newArm/arm/base_leg1.SLDPRT
Object Dection and Gripper Arm/Gripper Arm/3-20-2023/newArm (1)/newPrint/extension_leg1.STL
Object Dection and Gripper Arm/Gripper Arm/3-3-2023/newArm (1)/newArm/rods/M3Pin_30.SLDPRT
Housing and PCBs/Housing/final_housing_design_404/stl_files/camera_wall_15deg.STL
Housing and PCBs/Housing/Housing_before_FDM_optimization_404/controller module/connecting_face_new.STL
Object Dection and Gripper Arm/Gripper Arm/3-20-2023/newArm (1)/newArm/rods/M3Pin_30.SLDPRT
Object Dection and Gripper Arm/Gripper Arm/3-3-2023/newArm (1)/newArm/rods/N8Pin_656.SLDPRT
Object Dection and Gripper Arm/Gripper Arm/3-3-2023/print/extension_leg1.STL
Housing and PCBs/Housing/final_housing_design_404/stl_files/sensor_base.STL
Object Dection and Gripper Arm/Gripper Arm/3-20-2023/newArm (1)/newPrint/base_triangle.STL
Object Dection and Gripper Arm/Gripper Arm/3-3-2023/print/M3Pin_445.STL
Housing and PCBs/Housing/final_housing_design_404/stl_files/PD_battery_fastener.STL
Object Dection and Gripper Arm/Gripper Arm/3-20-2023/newArm (1)/newArm/arm/base_triangle.SLDPRT
Object Dection and Gripper Arm/Gripper Arm/3-20-2023/newArm (1)/newArm/rods/N8Pin_656.SLDPRT
Object Dection and Gripper Arm/Gripper Arm/3-20-2023/newArm (1)/newPrint/M3Pin_475_solid.STL
Object Dection and Gripper Arm/Gripper Arm/3-3-2023/print/M3Pin_18.STL
Housing and PCBs/Housing/final_housing_design_404/stl_files/controller_base.STL
Object Dection and Gripper Arm/Gripper Arm/3-3-2023/newArm (1)/newArm/arm/extension_leg1.SLDPRT
Object Dection and Gripper Arm/Gripper Arm/3-3-2023/print/base_leg1.STL
Housing and PCBs/Housing/final_housing_design_404/stl_files/PD_base.STL
Object Dection and Gripper Arm/Gripper Arm/3-20-2023/newArm (1)/newArm/arm/extension_leg2.SLDPRT
Object Dection and Gripper Arm/Gripper Arm/3-20-2023/newArm (1)/newPrint/base_support.STL
Housing and PCBs/Housing/Connector Module/Connector_Part1.STL
Housing and PCBs/Housing/Controller Module/Controller_Part1.STL
Housing and PCBs/Housing/Controller Module/Controller_Part2.STL
Housing and PCBs/Housing/Housing_before_FDM_optimization_404/arm module/arm_Part1_v2.STL
Housing and PCBs/Housing/Housing_before_FDM_optimization_404/arm module/arm_Part2.STL
Housing and PCBs/Housing/Housing_before_FDM_optimization_404/camera module/camera_Part1_v2.STL
Housing and PCBs/Housing/Housing_before_FDM_optimization_404/controller module/ControllerModule_Part1_v2.STL
Housing and PCBs/Housing/Housing_before_FDM_optimization_404/motor module/motor_new_Part1.STL
Housing and PCBs/Housing/Housing_before_FDM_optimization_404/sensor module/sensor_Part1.STL
Housing and PCBs/Housing/Motor/Motor_Part1.STL
Housing and PCBs/Housing/Motor/Motor_Part2.STL
Housing and PCBs/Housing/Motor/Motor_Part3.STL
Housing and PCBs/Housing/Power Delivery/PD_Part1.STL
Housing and PCBs/Housing/Power Delivery/PD_Part2.STL
Housing and PCBs/Housing/Power Delivery/PD_Part3.STL
Housing and PCBs/Housing/Sensor Module/Sensor_Part1.SLDPRT
Housing and PCBs/Housing/Sensor Module/Sensor_Part1.STL
Housing and PCBs/Housing/Sensor Module/Sensor_Part2.STL
Housing and PCBs/Housing/final_housing_design_404/stl_files/arm_camera_base.STL
Housing and PCBs/Housing/final_housing_design_404/stl_files/arm_camera_connecting_wall.STL
Housing and PCBs/Housing/final_housing_design_404/stl_files/arm_standoffs.STL
Housing and PCBs/Housing/final_housing_design_404/stl_files/connecting_top.STL
Housing and PCBs/Housing/final_housing_design_404/stl_files/connecting_wall_power.STL
Housing and PCBs/Housing/final_housing_design_404/stl_files/connector_base.STL
Housing and PCBs/Housing/final_housing_design_404/stl_files/flat_top.STL
Housing and PCBs/Housing/final_housing_design_404/stl_files/sensor_top.STL
Object Dection and Gripper Arm/Gripper Arm/3-20-2023/newArm (1)/newArm/arm/base_leg2.SLDPRT
Object Dection and Gripper Arm/Gripper Arm/3-20-2023/newArm (1)/newPrint/M3Pin_18.STL
Object Dection and Gripper Arm/Gripper Arm/3-20-2023/newArm (1)/newPrint/M3Pin_20.STL
Object Dection and Gripper Arm/Gripper Arm/3-20-2023/newArm (1)/newPrint/base_leg2.STL
Object Dection and Gripper Arm/Gripper Arm/3-20-2023/newArm (1)/newPrint/base_leg3.STL
Object Dection and Gripper Arm/Gripper Arm/3-26-2023/print_this/gear_hand_wscrew.STL
Object Dection and Gripper Arm/Gripper Arm/3-3-2023/newArm (1)/newArm/arm/base_leg3.SLDPRT
Object Dection and Gripper Arm/Gripper Arm/3-3-2023/newArm (1)/newArm/arm/base_support.SLDPRT
Object Dection and Gripper Arm/Gripper Arm/3-3-2023/newArm (1)/newArm/arm/base_triangle.SLDPRT
Object Dection and Gripper Arm/Gripper Arm/3-3-2023/print/M3Pin_15.STL
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
