Ali-Helmi/modular_robotics/Object Dection and Gripper Arm/Object Detection/Source code/runs/detect/train/results.csv

epoch | train/box_loss | train/cls_loss | train/dfl_loss | metrics/precision(B) | metrics/recall(B) | metrics/mAP50(B) | metrics/mAP50-95(B) | val/box_loss | val/cls_loss | val/dfl_loss | lr/pg0 | lr/pg1 | lr/pg2
0 | 1.1964 | 3.1379 | 1.6204 | 0.47089 | 0.44439 | 0.46118 | 0.40079 | 0.61585 | 1.6697 | 1.0102 | 0.07075 | 0.00325 | 0.00325
1 | 0.97745 | 1.274 | 1.4022 | 0.62851 | 0.93989 | 0.68645 | 0.60614 | 0.5605 | 0.85541 | 0.95474 | 0.040685 | 0.0065182 | 0.0065182
2 | 0.94465 | 1.2018 | 1.3546 | 0.80495 | 0.54247 | 0.65562 | 0.59866 | 0.71679 | 0.77641 | 1.021 | 0.010554 | 0.0097203 | 0.0097203
3 | 0.98596 | 1.1556 | 1.3917 | 0.33382 | 0.46887 | 0.21342 | 0.15508 | 1.1764 | 2.8267 | 1.3447 | 0.009703 | 0.009703 | 0.009703
4 | 0.99905 | 1.1834 | 1.4073 | 0.32935 | 0.83809 | 0.33574 | 0.26722 | 0.8952 | 1.8049 | 1.156 | 0.009703 | 0.009703 | 0.009703
5 | 0.99517 | 1.1442 | 1.4163 | 0.57746 | 0.98512 | 0.68824 | 0.52211 | 0.65657 | 0.6417 | 1.0241 | 0.009604 | 0.009604 | 0.009604
6 | 1.0009 | 1.1295 | 1.4196 | 0.63919 | 0.29813 | 0.31184 | 0.25106 | 0.79985 | 0.87512 | 1.1077 | 0.009505 | 0.009505 | 0.009505
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
