Ali-Helmi/modular_robotics/Object Dection and Gripper Arm/Object Detection/Demonstration/results.png

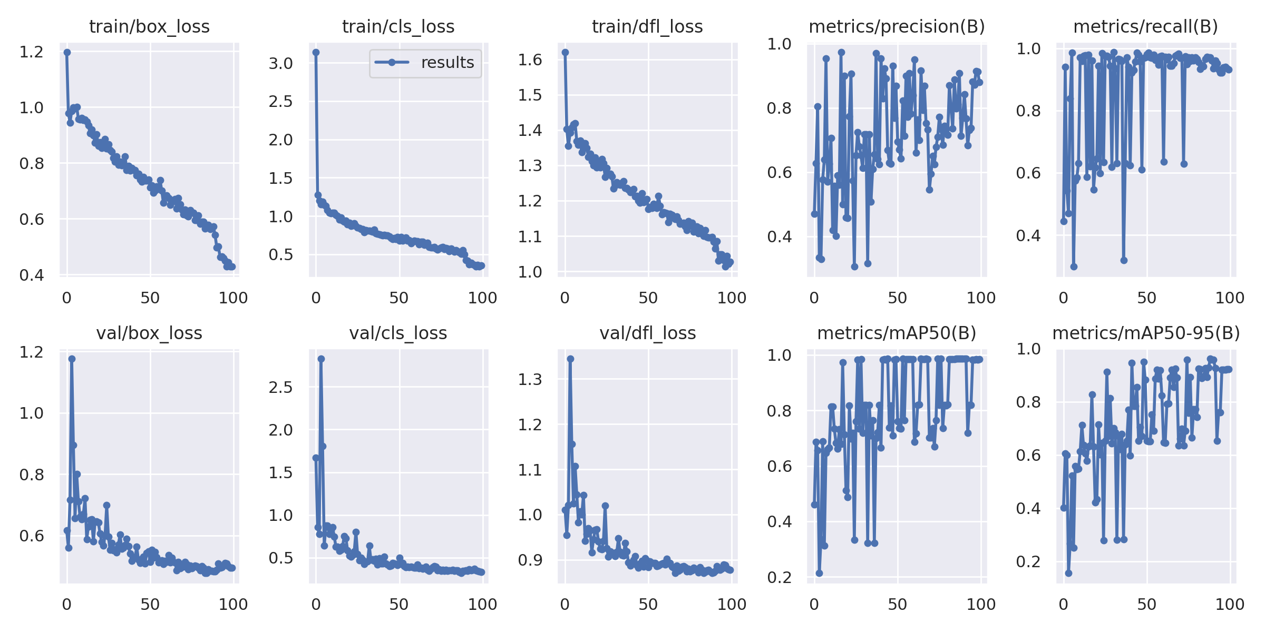
Object Dection and Gripper Arm/Object Detection/Demonstration/results.png
