Ali-Helmi/modular_robotics/Object Dection and Gripper Arm/Object Detection/Source code/test/images/WIN_20230222_20_42_03_Pro_jpg.rf.00696d6be8a1389aa20fa8b58e5d67e8.jpg

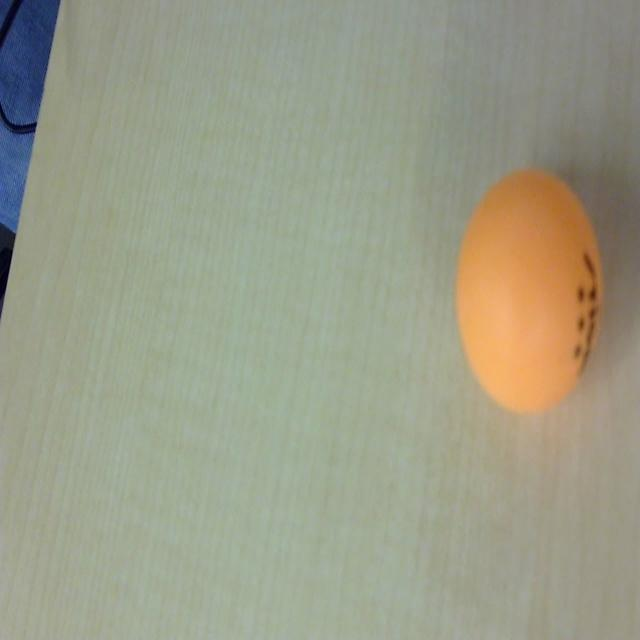
Object Dection and Gripper Arm/Object Detection/Source code/test/images/WIN_20230222_20_42_03_Pro_jpg.rf.00696d6be8a1389aa20fa8b58e5d67e8.jpg
