Ali-Helmi/modular_robotics/Object Dection and Gripper Arm/Object Detection/Source code/test/images/WIN_20230222_20_42_47_Pro_jpg.rf.5bab557098f4f11752993c2bd87a1b65.jpg

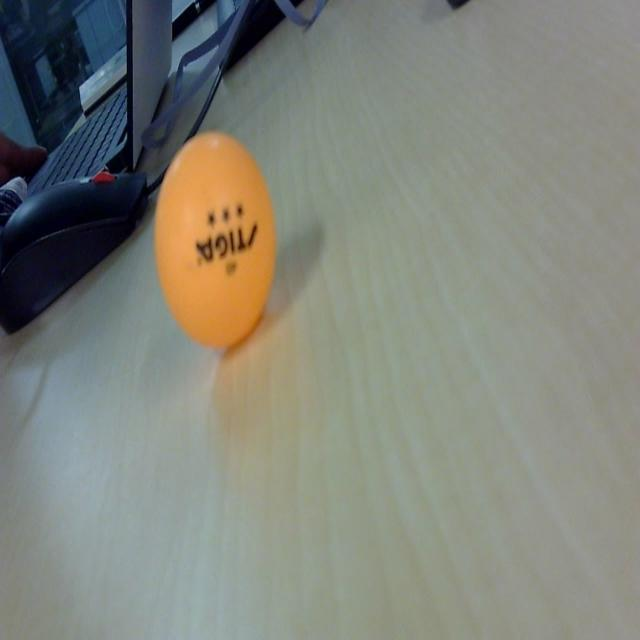
Object Dection and Gripper Arm/Object Detection/Source code/test/images/WIN_20230222_20_42_47_Pro_jpg.rf.5bab557098f4f11752993c2bd87a1b65.jpg
