Ali-Helmi/modular_robotics/Object Dection and Gripper Arm/Object Detection/Source code/test/images/WIN_20230304_14_49_19_Pro_jpg.rf.e8d3a9a1415165b660fd9a73492417c9.jpg

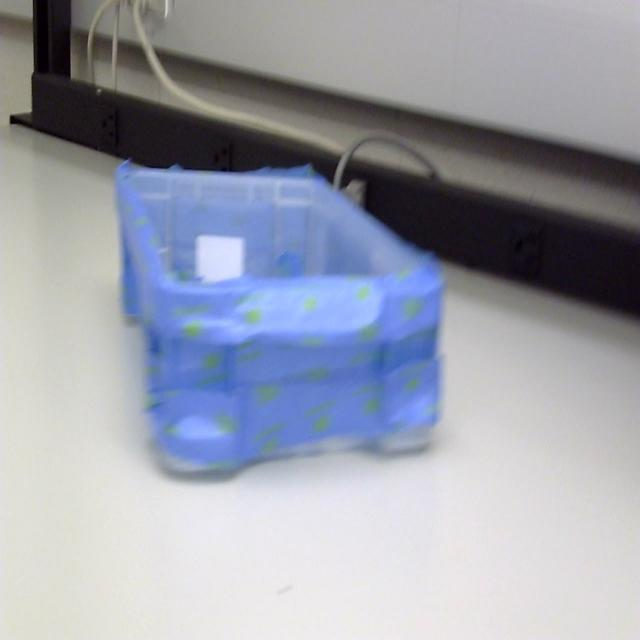
Object Dection and Gripper Arm/Object Detection/Source code/test/images/WIN_20230304_14_49_19_Pro_jpg.rf.e8d3a9a1415165b660fd9a73492417c9.jpg
