Ali-Helmi/modular_robotics/Object Dection and Gripper Arm/Object Detection/Source code/test/images/WIN_20230304_14_51_00_Pro_jpg.rf.92f4723db9decdf56b857068899f3be2.jpg

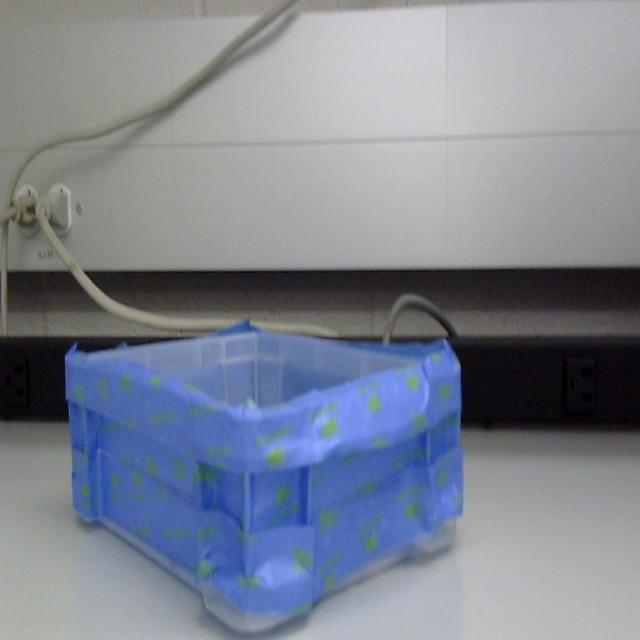
Object Dection and Gripper Arm/Object Detection/Source code/test/images/WIN_20230304_14_51_00_Pro_jpg.rf.92f4723db9decdf56b857068899f3be2.jpg
