Ali-Helmi/modular_robotics/Code/MCUs/pwm_funcs.h

/* 
 * File:   pwm_funcs.h
 * Author: andre
 *
 * Created on October 16, 2022, 12:42 AM
 */

#ifndef PWM_FUNCS_H
#define	PWM_FUNCS_H

// PWM functions
void setup_timer(void);
void setup_pwm(uint8_t channel);
void disable_pwm(uint8_t channel);
void set_pwm_duty_cycle(uint8_t channel, uint32_t percent);
void set_pwm_raw_duty_cycle(uint8_t channel, uint16_t duty_cycle);
void pwm_on(uint8_t channel, uint8_t duty_cycle);
void pwm_off(uint8_t channel);



#endif	/* PWM_FUNCS_H */
