Ali-Helmi/modular_robotics/(commit log)

2022-12-05 Raspberry Pi and MCU files
2022-12-05 Create Buck Converters
2022-12-05 Update Buck Converters
2022-12-05 Power and motor files
    [BMS Circuit.csv, BMS Circuit.kicad_pcb, BMS Circuit.kicad_sch, H_Bridge.csv, H_Bridge.kicad_pcb, H_Bridge.kicad_sch, Power.csv, Power.kicad_pcb]
2022-12-05 Datasheets for power and motor
2022-12-05 Gripper Arm & Object Detection Files
    Initial commit
    [gripper_armleft.stl, gripper_armright.stl, gripper_base.stl, gripper_basetop.stl, gripper_forwardarm.stl, gripper_mainarm.stl, gripper_mainarm_base.stl, gripper_servogear.stl]
2023-01-30 Moving RPi and MCU code to its own folder. Created a basic framework for the main python program as well as the beginnings of the robot script. Updated the motor control code to fit with the latest m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
2023-02-13 Object Detection Integration
    Adding queue as an argument to the function, and appending to it desired objects every frame.
    [yolov3-tiny.cfg, yolov3.cfg]
2023-02-13 Fixed UART comms to no longer lock up MCUs, updated robot script to communicate a bit faster
    [controller.py, fake_serial.py, main.c, motor_control.c, motor_control.h, pwm_funcs.c, pwm_funcs.h, robot.py]
2023-04-12 Object Detection & Gripper Arm Updates
    Weekly updates, and updated supporting files for both object detection and gripper arm.
    [Assem1.SLDASM, M3Pin_15.SLDPRT, M3Pin_15.STL, M3Pin_18.SLDPRT, M3Pin_18.STL, M3Pin_20.SLDPRT, M3Pin_20.STL, M3Pin_25.SLDPRT]
2023-04-12 Object Detection & Gripper Arm Updates
    Training demos including confusion matrix and other graphs.
2023-04-27 Power and Motor Updates
    [6 cell bms.brd, 6 cell bms.csv, 6 cell bms.sch, BMS Circuit.csv, BMS Circuit.kicad_pcb, BMS Circuit.kicad_sch, H_Bridge.csv, H_Bridge.kicad_pcb]
